Jupiterust/autoBike/bike_code/下位机软件要求.md

# 上位机通信契约 · 协议 v3（舵机轴角 ×100）

> 对应 `USER/upper/upper.c` / `upper.h` 当前实现。舵机命令、回显及边界统一为**相对现有回中位置的舵机输出轴角度 ×100**，有符号16位小端整数，单位0.01°，右正左负。发送前乘100并取整，接收后除100得到度。回显 rpm 优先使用有效的 ODrive 实测反馈，`status & 0x08` 表示本帧 rpm 为实测；`status & 0x20` 表示角度为传感器实测（当前恒0）。v3仅为文档版本，帧中没有版本字段。

上位机连接 **USART2，115200 8N1**：车端 PD6 RX、PD5 TX，双方 TX/RX 交叉连接并共地。UART7 的 ASCII 蓝牙遥控及 USART6 的二进制遥测是另外两条链路；仓库根目录 `REMOTE_PROTOCOL.md` 描述的是遥控链路，不是本文协议。

当前上位机舵机线值范围 **−2100～+2100**（左21.00°～右21.00°）。标定关系为120内部PWM单位≈21°，保持底层 `Servo_Delta=120` 的行程。上位机后轮目标 **0～240 rpm**；遥控器驾驶目标 **−240～+240 rpm**（±4转/秒），每次按键调整6rpm。两种模式均对叠加转弯补偿后的最终速度限幅；上位机不允许倒转，遥控器允许倒转。

遥控L/R键保持独立 `SERVO_RC_LIMIT_UNITS=114`，左右各20°目标向下取整后估算±19.95°，现在相应USART2回显为±1995。屏幕青色 `SERVO~` 仍显示角度（保留一位小数），右正左负，`~`表示估算而非传感器反馈；这里指舵机输出轴，不是龙头或前轮经连杆后的转角。回中位置不变，线性比例和左右对称性仍需硬件验证。

**兼容性：这是舵机字段单位的不兼容变更，上下位机必须同步升级。** 帧头、长度、字段偏移、CRC及方向均不变，不自动识别旧单位。旧程序发`+120`现在表示右1.20°，不再是旧端点约21°；新端点发送`+2100`。上位机连接后应查询边界，当前返回±2100；不要依赖旧±120常量。

**取整：** 命令先限幅到±2100，再按 `PWM = -round(servo × 120 / 2100)` 转换为整数PWM控制量；回显按 `servo = round(-Servo_Ctl × 2100 / 120)` 换算，正负半值均远离零。0.01°是协议分辨率，内部一个PWM单位约0.175°；例如发送`+1000`（右10.00°）得到`Servo_Ctl=-57`，稳定后回显`+998`（估算右9.98°）。量化取整不置`CLAMPED`，超过接受范围才置位。

上电默认由遥控器控制。必须由遥控器发送 `(S,)` 切到上位机控制，再发送新的命令；`S` 是切换命令，请勿周期重发。边界查询在两种模式都可用。执行要求平衡已使能且不在重立缓冲期；否则目标清零。上位机模式超时 **100ms**，请持续每 **20～30ms** 发送完整目标命令（目标未变化也要发）；查询帧不能代替命令保活。

**CRC-8**：多项式 `0x07`，初值 `0x00`，不反转、不异或。命令、普通回显、边界查询/回复及姿态回复使用 CRC；新增姿态查询 `AA 57 49 5A` 的第三字节是类型 `0x49`，不带 CRC。
自检：对 `"123456789"` 算出 `0xF4`。

---

## 一、要实现什么

| # | 方向 | 内容 | 章节 |
|---|---|---|---|
| 1 | 收 | **命令帧**（8 字节）→ 校验通过后设为当前目标值 | §二 |
| 2 | 收 | **边界查询帧**（4 字节）→ 回一帧边界帧 | §三 |
| 3 | 发 | **回显帧**（9 字节）：每 100 ms 一帧，值/状态变化时立即补发 | §四 |
| 4 | 发 | **边界帧**（12 字节）：收到查询帧时回 | §五 |
| 5 | 内部 | **超时保护**：超过超时时间没收到有效命令帧 → 目标清零 | §六 |
| 6 | 内部 | **上电默认**：舵机中位、电机不使能 | §七 |
| 7 | 收/发 | **姿态查询**（4 字节）→ **姿态回复**（11 字节），不主动周期发送 | §四·补 |

---

## 二、收：命令帧（固定 8 字节）

```
 偏移  长度  字段     类型       单位     说明
 ─────────────────────────────────────────────────────────────
  0     1   帧头1    —          —        0xAA
  1     1   帧头2    —          —        0x55
  2     2   servo    int16 小端  0.01°    绝对轴角目标，正 = 右
  4     2   rpm      int16 小端  r/min    电机转速，0 = 停
  6     1   crc8     —          —        覆盖字节 0..5
  7     1   帧尾     —          —        0x5A
 ─────────────────────────────────────────────────────────────
```

**要求：**

1. 找到帧头 `AA 55` → 收满 8 字节 → 查帧尾 `0x5A` → 查 CRC-8 → 查 `rpm ≥ 0`。
2. 全部通过：把 `servo`、`rpm` **限幅后**设为当前目标值，并记录"收到有效命令的时刻"。
3. 任一项不通过：丢弃该帧，不改变任何状态。
4. 丢弃一帧时，**只跳过 `AA 55` 这两个字节**，从下一个字节继续找帧头。
5. 处理必须**幂等**：同一帧收到 100 次 ≡ 收到 1 次，**不得累加**。
6. `servo`、`rpm` 超出你的量程 → 钳位，并置回显帧的 `CLAMPED` 位。

**帧样例**：

| 场景 | 8 字节 |
|---|---|
| 回中 + 停 | `AA 55 00 00 00 00 DD 5A` |
| 直行 120 rpm | `AA 55 00 00 78 00 D7 5A` |
| 直行 240 rpm（当前上限） | `AA 55 00 00 F0 00 C9 5A` |
| 右5.25°（+525）/ 120 rpm | `AA 55 0D 02 78 00 FF 5A` |
| 左10.50°（−1050）/ 180 rpm | `AA 55 E6 FB B4 00 56 5A` |
| 右21.00°（+2100，当前上限）/ 120 rpm | `AA 55 34 08 78 00 77 5A` |
| 左21.00°（−2100，当前下限）/ 120 rpm | `AA 55 CC F7 78 00 EF 5A` |
| 右10.00°（+1000，量化后回显+998）/ 120 rpm | `AA 55 E8 03 78 00 BE 5A` |

---

## 三、收：边界查询帧（固定 4 字节）

```
 偏移  长度  字段     类型   说明
 ──────────────────────────────────────────
  0     1   帧头1    —      0xAA
  1     1   帧头2    —      0x57
  2     1   crc8     —      覆盖字节 0..1
  3     1   帧尾     —      0x5A
 ──────────────────────────────────────────
```

**要求**：CRC 通过 → **立即回一帧边界帧**（§五）。此帧不改变任何目标值。

**帧样例**：`AA 57 38 5A`

---

## 四、发：回显帧（固定 9 字节）

```
 偏移  长度  字段     类型       单位     说明
 ─────────────────────────────────────────────────────────────
  0     1   帧头1    —          —        0xAA
  1     1   帧头2    —          —        0x55
  2     2   servo    int16 小端  0.01°    当前PWM输出换算的轴角估计，正 = 右
  4     2   rpm      int16 小端  r/min    实测转速；反馈失效时回退指令，见 status
  6     1   status   u8         —        见下表
  7     1   crc8     —          —        覆盖字节 0..6
  8     1   帧尾     —          —        0x5A
 ─────────────────────────────────────────────────────────────
```

**`status` 位：**

| 位 | 名称 | 掩码 | 置 1 条件 |
|---|---|---|---|
| 0 | `LINK_OK` | `0x01` | 上位机控制模式下，最近一个超时周期内收到过有效命令帧 |
| 1 | `TIMEOUT_SEEN` | `0x02` | 本次上电后曾因命令超时，或平衡/重立保护清除正在执行的目标而进入安全态；保持到复位 |
| 2 | `MOTOR_EN` | `0x04` | 固件允许后轮驱动；不代表 ODrive 确认闭环或电机实际正在转 |
| 3 | `MEASURED_RPM` | `0x08` | 本帧 rpm 来自有效、未过期的 ODrive 实测速度；0表示回退到速度指令 |
| 4 | `CLAMPED` | `0x10` | 输入命令或最终速度指令被限幅；不表示实测转速被限到0～240 |
| 5 | `MEASURED_ANGLE` | `0x20` | 舵机角度为传感器实测；当前没有位置反馈，恒0 |
| 6–7 | — | — | 填0 |

**要求：**

1. **每 100 ms 一帧**。
2. `servo`、`rpm` 或 `status` 任一变化 → **立即补发一帧**。
3. 角度与转速分别判断测量来源，上位机必须按各自状态位解释。

角度由限幅、转向斜坡后的当前软件输出 `Servo_Ctl` 按上述标定换算，`MEASURED_ANGLE=0`，不是请求目标的直接复制。角度回显与命令采用相同单位和方向，因输出量化及转向斜坡可能不同；平衡关闭或重立时回显0。

转速取 `odrive_vel1_turns * 60` 并四舍五入为整数 rpm。ODrive 位置与速度交替查询，当前速度更新约5Hz；回显频率并不等于传感器采样率。只有收到速度回复、数值有限且可用 int16 表示、距该速度回复解析时间不超过 **500ms** 时置 `MEASURED_RPM=1`。位置回复不刷新速度时间戳，接收重启后也必须等到新的速度回复。

反馈未收到、过期或无效时，清除 `MEASURED_RPM`，回退到最终速度指令 `odrive.set_speed1 * 60`；驱动禁用时回退值为0。若反馈有效，即使超时停车、平衡关闭或 `MOTOR_EN=0`，也继续回传实测速度，保留滑行、反转及超过240rpm的反馈，不按命令范围钳位。边界帧中的0～240rpm仍是**接受的命令范围**。

**帧样例**：

| 场景 | 9 字节 |
|---|---|
| 执行中（估算右5.25°、实测120rpm、链路正常、驱动使能） | `AA 55 0D 02 78 00 0D D0 5A` |
| 执行中（估算右21.00°、实测120rpm、链路正常、驱动使能） | `AA 55 34 08 78 00 0D 61 5A` |
| 反馈失效（估算右5.25°、回退指令120rpm、链路正常、驱动使能） | `AA 55 0D 02 78 00 05 E8 5A` |
| 反馈失效（估算右9.98°、回退指令120rpm、链路正常、驱动使能） | `AA 55 E6 03 78 00 05 7A 5A` |
| 超时后仍滑行（输出角0°、实测60rpm、驱动关闭、曾进安全态） | `AA 55 00 00 3C 00 0A 30 5A` |
| 超时后已停（输出角0°、实测0rpm、驱动关闭、曾进安全态） | `AA 55 00 00 00 00 0A 2B 5A` |
| 超时且反馈失效（输出角0°、回退指令0rpm、曾进安全态） | `AA 55 00 00 00 00 02 13 5A` |

---

## 四·补、IMU 姿态查询与回复

查询固定为 `AA 57 49 5A`（第三字节为 item，不是 CRC）。旧边界查询 `AA 57 38 5A` 保持不变；其他 item 拒收。

回复固定 11 字节：

| 偏移 | 长度 | 字段 | 格式/含义 |
|---|---|---|---|
| 0 | 1 | 帧头 | `0xAA` |
| 1 | 1 | 帧类型 | `0x58` |
| 2 | 2 | pitch | int16 小端，0.01°，抬头为正 |
| 4 | 2 | roll | int16 小端，0.01°，右倾为正 |
| 6 | 2 | yaw | int16 小端，0.01°，俯视顺时针为正 |
| 8 | 1 | status | `0x01 VALID`；`0x02 CALIBRATED`；其他位恒0 |
| 9 | 1 | CRC-8 | 覆盖偏移0～8 |
| 10 | 1 | 帧尾 | `0x5A` |

安装方向已由实车观察确认：`pitch=imu.pit`、`roll=-imu.rol`、`yaw=-imu.yaw`。三轴乘100后四舍五入（负数半值远离零），上位机除100得到度。不改变平衡控制变量，不减 `angular_zero`，不做航向归零；屏幕仍显示原始 `imu.rol/pit/yaw`。车体轴为 x前/y左/z上，角度正方向以本表约定为准。**姿态与舵机字段均用0.01°，但分别表示车身姿态与舵机输出轴角度，两者不能互推。**

`VALID=1` 要求收到帧头和CRC正确、三轴有限的 CH100 数据，距离成功解帧不超过 **100ms**（含100ms），且转换后可用 int16 表示。启动未收到数据、CRC错误、UART错误/接收重启、非有限值、超范围或超过100ms均无效；新的有效帧到达后恢复。无效回复 `status=0`、三个字段填0，**这些0不是实际姿态，上位机必须丢弃**。

`CALIBRATED` 暂时恒0，表示车端未确认零偏标定完成，不否认CH100内部出厂校准或补偿；31秒等待和 `angular_zero` 均不作为标定完成依据。有效回复因此为 `status=0x01`。没有额外 `MEASURED` 位。

一问一答，遥控/上位机两种控制模式、平衡未使能时均可查询。只在前台使用 USART2 非阻塞发送；查询不改变目标，不刷新驾驶超时。待发顺序为 **边界回复 → 姿态回复 → 普通回显**，已在发送的帧不会被中断。UART忙/发送失败时保留待发计数，成功启动发送才扣减。两类查询各用16位饱和计数，极端积压达到65535后同类新增查询丢弃；上位机按10～50Hz轮询即可，切勿无节制连续请求。等待期间不保存历史样本，回复取发送时最新姿态。

样例：`AA 58 2C 01 38 FF 8C 23 01 97 5A`，表示 pitch=+3.00°、roll=−2.00°、yaw=+91.00°，有效且未确认标定。

---

## 五、发：边界帧（固定 12 字节）

```
 偏移  长度  字段        类型       单位     说明
 ─────────────────────────────────────────────────────────────
  0     1   帧头1       —          —        0xAA
  1     1   帧头2       —          —        0x56
  2     2   servo_min   int16 小端  0.01°    最小轴角目标，当前-2100（左21°）
  4     2   servo_max   int16 小端  0.01°    最大轴角目标，当前+2100（右21°）
  6     2   rpm_min     uint16 小端 r/min    最小可稳转速；0 = 未提供
  8     2   rpm_max     uint16 小端 r/min    最大可用转速；0 = 未提供
 10     1   crc8        —          —        覆盖字节 0..9
 11     1   帧尾        —          —        0x5A
 ─────────────────────────────────────────────────────────────
```

**要求：**

1. 填**你实际会接受的量程**（就是 §二 里做限幅用的那两个数）。
2. 必须保证 **`servo_max` 是往右的极限**；舵机装反时在固件内部取反。
3. 未标定时填当前保守值；全部填 0 表示"未提供"。
4. 收到边界查询帧（§三）时回一帧；上电后也可主动发一次。

**帧样例**：

| 场景 | 12 字节 |
|---|---|
| 当前车端：舵机±21.00°（线值±2100）、rpm_min 未标定、rpm_max=240 | `AA 56 CC F7 34 08 00 00 F0 00 AD 5A` |
| 未提供（全 0） | `AA 56 00 00 00 00 00 00 00 00 B8 5A` |

---

## 六、超时保护

**判据**：距上次收到**有效命令帧**的时间 > 超时值。

**动作**：舵机与后轮的**控制目标**清零（回中 + 停），置 `TIMEOUT_SEEN`；收到新的有效命令帧后按平衡/重立条件恢复。回显 rpm 在反馈有效时仍显示实测转速，可能因车轮滑行暂不为0。

**超时值**（当前 `UPPER_TIMEOUT_MS=100u`，编译期可覆盖；下表其他档位仅供配置参考，并非运行时切换）：

| 档 | 超时值 | 上位机发送间隔上限 |
|---|---|---|
| bench（台架 / 低速调试） | 500 ms | ≤ 166 ms |
| slow（低速路测 ≤1.5 m/s） | 200 ms | ≤ 66 ms |
| normal（正常行驶，默认） | 100 ms | ≤ 33 ms |

---

## 七、上电默认

| 项 | 要求 |
|---|---|
| 舵机 | 中位（`servo = 0`） |
| 电机 | 不使能 |
| 目标值 | `servo = 0`、`rpm = 0` |
| 是否等待握手 | 无握手；先由遥控器 `(S,)` 切入上位机模式，平衡使能且非重立期间才能执行新命令 |
