Jupiterust/autoBike/bike_code/下位机通信实现说明.md

# 上位机与下位机通信实现说明

本文仅说明已实现的上位机与下位机串口通信：接口、收发帧、字段含义、命令处理、状态回显及超时保护。完整协议契约及样例见 [下位机软件要求.md](./下位机软件要求.md)。

本次统一将舵机命令、回显、边界改为**舵机输出轴角度 ×100（0.01°）**，右正左负，相对现有回中位置。上位机目标范围为±2100，即±21.00°；保持原PWM行程。旧整数控制量不兼容，帧内没有版本字段，上位机须同步调整发送、解析及边界单位。

## 1. 通信接口

| 项目 | 当前配置 |
|---|---|
| 下位机串口 | USART2 / huart2 |
| 下位机 TX | PD5，连接上位机 RX |
| 下位机 RX | PD6，连接上位机 TX |
| 串口参数 | 115200，8 数据位，无校验，1 停止位，无流控 |
| 电气连接 | 3.3 V TTL，共地 |
| 传输方式 | 二进制原始字节，不追加换行 |

运动命令仅在上位机控制已启用时生效；未启用时忽略运动命令，也不更新命令时间，但仍回复边界查询和发送状态回显。通信协议本身不提供启用或切换控制来源的指令。启用后需要新的完整有效命令，不会自动执行先前收到的目标。

## 2. 协议总览与校验

| 帧 | 方向 | 帧头 | 总长度 |
|---|---|---|---|
| 运动命令 | 上位机 → 下位机 | AA 55 | 8 字节 |
| 边界查询 | 上位机 → 下位机 | AA 57（38） | 4 字节 |
| 姿态查询 | 上位机 → 下位机 | AA 57（49） | 4 字节 |
| 姿态回复 | 下位机 → 上位机 | AA 58 | 11 字节 |
| 状态回显 | 下位机 → 上位机 | AA 55 | 9 字节 |
| 边界回复 | 下位机 → 上位机 | AA 56 | 12 字节 |

所有帧均以 5A 结束。多字节字段使用小端编码；有符号字段使用 int16 补码。

姿态查询 `AA 57 49 5A` 的第三字节是 item，不是CRC；其他帧按下述规则校验。姿态回复字段及有效性见协议契约 §四·补。

CRC-8 参数：多项式 0x07，初值 0x00，不反转，最终不异或。CRC 覆盖帧头至 CRC 字节之前的全部字节，不包含 CRC 本身和帧尾。自检：ASCII “123456789” 的 CRC 为 F4。

运动命令与状态回显虽然都以 AA 55 开头，但长度不同。上位机接收应按 9 字节回显解析，不能按 8 字节命令解析。

## 3. 上位机发送运动命令

### 3.1 帧格式

| 偏移 | 字节数 | 字段 | 含义 |
|---|---|---|---|
| 0–1 | 2 | 帧头 | AA 55 |
| 2–3 | 2 | servo，int16 小端 | 绝对舵机轴角目标，单位 0.01°；正为右，负为左，0 为中位 |
| 4–5 | 2 | rpm，int16 小端 | 电机轴目标转速，单位 r/min；0 为停止 |
| 6 | 1 | CRC | 覆盖字节 0–5 |
| 7 | 1 | 帧尾 | 5A |

### 3.2 当前处理规则

- 校验帧尾、CRC 和 rpm ≥ 0，全部通过才处理命令。
- 合法命令覆盖当前绝对目标，并记录接收时间；重复发送相同命令不累加目标，只更新有效命令时间。
- servo 接受范围为 -2100～+2100，即左 21.00°～右 21.00°。
- rpm 接受范围为 0～240，指电机轴 RPM，不是车轮 RPM 或车辆速度。
- 超过角度或正转速上限时钳位，并设置回显的 CLAMPED 位。
- rpm 为负时拒绝整条命令，转向和转速均不更新，也不刷新超时。
- 帧尾或 CRC 错误时不更新目标及命令时间；仅跳过候选帧头两个字节，继续寻找合法帧。
- 支持分段接收、连续多帧及噪声后的重新同步；串口接收错误时清除未完成的半帧。

转向采用实测标定关系：120内部PWM单位≈21°，不代表已达到0.01°实测精度。命令先限幅，再按 `-round(servo × 120 / 2100)` 转换为整数PWM量，半值远离零；下位机处理安装方向，上位机始终按“正为右”发送。遥控L/R仍限±114内部单位（估算±19.95°），底层共用范围仍为±120单位。

例：发送+1000（右10.00°）得到内部−57单位，稳定后估算9.975°，回显+998（9.98°）。量化取整不置CLAMPED。旧+120线值现在表示1.20°，不能再用作旧端点。

命令接收有效不等于电机已经运行。车辆未满足平衡使能等运行条件时，运动目标会清零，回显可能出现 LINK_OK = 1、MOTOR_EN = 0。

## 4. 下位机发送状态回显

### 4.1 帧格式

| 偏移 | 字节数 | 字段 | 含义 |
|---|---|---|---|
| 0–1 | 2 | 帧头 | AA 55 |
| 2–3 | 2 | servo，int16 小端 | 当前PWM输出换算的舵机轴角估计，单位 0.01°，正为右 |
| 4–5 | 2 | rpm，int16 小端 | 优先实测电机轴RPM；反馈失效时回退软件指令，见status |
| 6 | 1 | status | 状态位 |
| 7 | 1 | CRC | 覆盖字节 0–6 |
| 8 | 1 | 帧尾 | 5A |

舵机回显使用限幅、转向斜坡后的 `Servo_Ctl`，按 `round(-Servo_Ctl × 2100 / 120)` 换算，半值远离零；并非直接复制请求角度。当前没有位置传感器，`MEASURED_ANGLE=0`；平衡关闭或重立时角度回显0。遥控模式采用相同单位，±114内部单位回显∓1995。

RPM优先使用500ms内有效的ODrive速度反馈并置 `MEASURED_RPM`；反馈失效时回退到包含转弯补偿和最终限幅的软件速度指令。驱动关闭时回退指令为0，但有效实测反馈仍保留滑行、反转和超范围速度。回显不是电机控制器的执行确认。

### 4.2 状态位

| 位 / 掩码 | 名称 | 当前含义 |
|---|---|---|
| bit 0 / 01 | LINK_OK | 上位机控制已启用，且最近 100 ms 内收到过有效运动命令 |
| bit 1 / 02 | TIMEOUT_SEEN | 本次上电以来发生过通信超时或平衡/重立保护清除运动目标，保持至复位 |
| bit 2 / 04 | MOTOR_EN | 平衡使能、非重新扶正状态且后轮运行标志有效 |
| bit 3 / 08 | MEASURED_RPM | 本帧RPM来自有效实测反馈；0为指令回退 |
| bit 4 / 10 | CLAMPED | 当前命令或补偿后的输出被限幅 |
| bit 5 / 20 | MEASURED_ANGLE | 当前无舵机位置传感器，恒0 |
| bit 6–7 | 保留 | 0 |

表中掩码为十六进制。未发生保护且正常驱动时，反馈失效回退状态为05，有实测RPM反馈时为0D；超时后相应为02或0A。TIMEOUT_SEEN 是历史标志，不能单独用它判断当前仍处于超时状态。

### 4.3 发送时机

首次运行时发送回显；之后 servo、rpm 或 status 变化时尽快补发，否则按 100 ms 周期发送。

发送采用 HAL_UART_Transmit_IT 非阻塞方式。串口忙时延后处理，不覆盖正在发送的缓冲区；待发顺序为边界回复、姿态回复、普通回显。因此回显是状态快照，不是每条命令一条 ACK，实际发送时机也受主循环和串口可用性影响。

上位机控制未启用时也有回显，但 LINK_OK 为 0；舵机仍按相同物理角度单位回显，遥控后轮反馈允许负RPM。

## 5. 边界查询与回复

上位机发送 4 字节查询：

~~~text
AA 57 38 5A
~~~

其中 38 是 AA 57 的 CRC。合法查询登记后，在串口可发送时优先回复边界帧，不改变目标，也不刷新运动命令超时。

| 偏移 | 字节数 | 字段 | 当前值 |
|---|---|---|---|
| 0–1 | 2 | 帧头 | AA 56 |
| 2–3 | 2 | servo_min，int16 小端 | -2100，即左 21.00° |
| 4–5 | 2 | servo_max，int16 小端 | +2100，即右 21.00° |
| 6–7 | 2 | rpm_min，uint16 小端 | 0，最小可稳转速未提供 |
| 8–9 | 2 | rpm_max，uint16 小端 | 240，电机轴 RPM 上限 |
| 10 | 1 | CRC | 覆盖字节 0–9 |
| 11 | 1 | 帧尾 | 5A |

当前完整回复：

~~~text
AA 56 CC F7 34 08 00 00 F0 00 AD 5A
~~~

建议上位机连接后先查询边界，不硬编码其他车辆的量程。rpm_min = 0 不表示所有低速都已验证可以稳定运行。

## 6. 命令超时保护

当前超时阈值为 100 ms，判据为距上次有效运动命令的时间严格大于 100 ms。刚启用上位机控制、尚未收到命令时，从启用时刻开始计时。

上位机应约每 30 ms 重发当前完整目标，发送间隔不超过 33 ms；即使目标不变也应持续发送。错误帧、负转速命令和两种查询都不能刷新超时。

超时后下位机清零转向与转速目标、回中并安排后轮零速命令，设置 TIMEOUT_SEEN。收到新的有效运动命令后，在运行条件满足时可自动恢复，历史超时标志仍保留。

100 ms 是软件超时阈值，不保证机械车轮在 100 ms 内完全停止；保护执行依赖控制周期正常运行。

## 7. 通信样例与代码入口

以下均为原始 HEX 字节，不追加换行：

| 场景 | 帧 |
|---|---|
| 回中、停止 | AA 55 00 00 00 00 DD 5A |
| 右转 6°、停止 | AA 55 58 02 00 00 47 5A |
| 左转 6°、停止 | AA 55 A8 FD 00 00 6F 5A |
| 直行 60 RPM | AA 55 00 00 3C 00 D8 5A |
| 右转 6°、60 RPM | AA 55 58 02 3C 00 42 5A |
| 左转 6°、60 RPM | AA 55 A8 FD 3C 00 6A 5A |
| 直行 60 RPM 的反馈失效回显示例，status = 05 | AA 55 00 00 3C 00 05 1D 5A |
| 超时且反馈失效的回显，status = 02 | AA 55 00 00 00 00 02 13 5A |

主要通信实现位于 [USER/upper/upper.c](./USER/upper/upper.c)，协议常量和状态位位于 [USER/upper/upper.h](./USER/upper/upper.h)，串口接收入口位于 [USER/uart/uart.c](./USER/uart/uart.c)。

| 函数 | 通信职责 |
|---|---|
| Upper() | 逐字节找帧、校验、更新命令或登记查询 |
| upper_crc8() | CRC-8 计算 |
| upper_rx_reset() | 清除未完成的接收半帧 |
| upper_task() | 非阻塞发送回显、边界及姿态回复 |
| upper_control_tick() | 检查命令超时，施加有效目标或清零 |
