Jupiterust/autoBike/odrive/额外配置.docx

odrv0.config.dc_max_negative_current = -30

odrv0.config.dc_max_positive_current = 120

odrv0.axis0.motor.config.current_lim = 140

odrv0.config.brake_resistance = 2.0

odrv0.axis0.controller.config.vel_limit_tolerance = 2.5

odrv0.config.max_regen_current = 100

odrv0.axis0.motor.config.requested_current_range = 120

odrv0.axis0.motor.config.current_lim = 100

odrv0.axis0.controller.config.control_mode = 2

odrv0.axis0.controller.config.input_mode = 1

odrv0.axis0.controller.config.vel_ramp_rate = 80

odrv0.axis1.controller.config.vel_limit_tolerance = 2.5

odrv0.axis1.motor.config.requested_current_range = 120

odrv0.axis1.motor.config.current_lim = 100

odrv0.axis1.controller.config.control_mode = 2

odrv0.axis1.controller.config.input_mode = 1

odrv0.axis1.controller.config.vel_ramp_rate = 80
