Jupiterust/autoBike/odrive/旧电机配置.docx

//两个电机的速度模式

odrv0.erase_configuration()

odrv0.config.brake_resistance = 2

odrv0.config.dc_bus_overvoltage_trip_level = 56

odrv0.config.dc_max_positive_current = 120

odrv0.config.dc_max_negative_current = -30

odrv0.axis0.motor.config.motor_type = MOTOR_TYPE_HIGH_CURRENT

odrv0.axis0.motor.config.pole_pairs = 20

odrv0.axis0.motor.config.calibration_current = 10

odrv0.axis0.motor.config.current_lim = 120

odrv0.axis0.motor.config.current_lim_margin = 8

odrv0.axis0.encoder.config.mode = ENCODER_MODE_INCREMENTAL

odrv0.axis0.encoder.config.cpr = 8192

odrv0.axis0.controller.config.control_mode = 3

odrv0.axis0.controller.config.vel_limit = 50

odrv0.axis0.controller.config.vel_limit_tolerance = 2

odrv0.axis0.controller.config.vel_gain = 0.05

odrv0.axis0.controller.config.vel_integrator_gain = 0.2

odrv0.axis0.controller.config.input_mode = INPUT_MODE_VEL_RAMP

odrv0.axis0.controller.config.vel_ramp_rate = 50

odrv0.axis1.motor.config.motor_type = MOTOR_TYPE_HIGH_CURRENT

odrv0.axis1.motor.config.pole_pairs = 14

odrv0.axis1.motor.config.calibration_current = 10

odrv0.axis1.motor.config.current_lim = 120

odrv0.axis1.motor.config.current_lim_margin = 8

odrv0.axis1.encoder.config.mode = ENCODER_MODE_INCREMENTAL

odrv0.axis1.encoder.config.cpr = 8192

odrv0.axis1.controller.config.control_mode = CONTROL_MODE_VELOCITY_CONTROL

odrv0.axis1.controller.config.vel_limit = 50

odrv0.axis1.controller.config.vel_limit_tolerance = 2

odrv0.axis1.controller.config.vel_gain = 0.2

odrv0.axis1.controller.config.vel_integrator_gain = 0.2

odrv0.axis1.controller.config.input_mode = INPUT_MODE_VEL_RAMP

odrv0.axis1.controller.config.vel_ramp_rate = 50

odrv0.save_configuration()

odrv0.reboot()

odrv0.axis0.requested_state = AXIS_STATE_FULL_CALIBRATION_SEQUENCE //校准大概需要十秒钟

odrv0.axis0.error //检查是否有错误

odrv0.axis0.requested_state = AXIS_STATE_CLOSED_LOOP_CONTROL

odrv0.axis0.motor.config.pre_calibrated = True

odrv0.axis0.config.startup_encoder_offset_calibration = True

odrv0.axis0.config.startup_closed_loop_control = True

odrv0.axis1.requested_state = AXIS_STATE_FULL_CALIBRATION_SEQUENCE //校准大概需要十秒钟

odrv0.axis1.error //检查是否有错误

odrv0.axis1.requested_state = AXIS_STATE_CLOSED_LOOP_CONTROL

odrv0.axis1.motor.config.pre_calibrated = True

odrv0.axis1.config.startup_encoder_offset_calibration = True

odrv0.axis1.config.startup_closed_loop_control = True

odrv0.save_configuration()

odrv0.reboot()

odrv0.axis0.config.can.node_id =24

odrv0.axis1.config.can.node_id =16

odrv0.can.config.baud_rate = 250000

odrv0.axis0.controller.input_vel = 10 //设置转速

odrv0.axis1.controller.input_vel = 10
