Jupiterust/autoBike/PID_Param_Con/fir.png

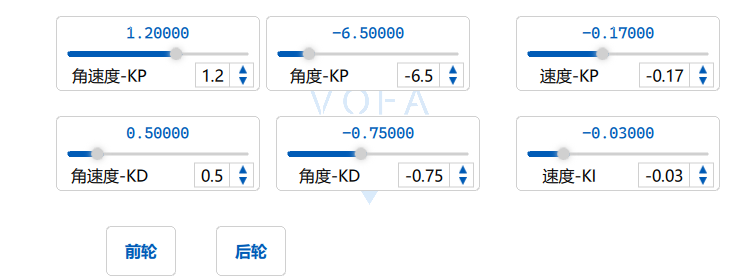
PID_Param_Con/fir.png
