Jupiterust/autoBike/bike_code/TUNING_JOURNAL.md

# TUNING_JOURNAL.md — PID 迭代记录 (append-only)

格式见 `TUNING_PLAYBOOK.md` §5。铁律:一次只动一处;变差就回滚。
静态窗(不给扰动)的 `step_response` 各项记 N/A。

指标缩写:
`settle` 恢复时间ms(±0.1° 紧带) / `overshoot` 峰值角偏离deg / `rms_err` 角误差std deg /
`fly_peak` 峰值|now_speed0| / `sat` 飞轮饱和占比 / `djit` D逐帧抖动 / `idle` now_speed0 均值

---

## iter 0  2026-09-08  focus: 基线 / 静态诊断 (无扰动)

change: (无 — 本轮只建立基线)

机械配置已相对上次调参变更(重心/动力学变了);增益仍是旧配置上整定的。
`angular_zero` 已由用户经 OLED 菜单手调至 -1.32(代码里 `param_init()` 仍是 -1.27)。

四个静态窗(`step_response.found=false`,M0 全程使能):

| 窗 | av_kp/ki/kd | an_kp/ki/kd | fw_kp/ki/kd | zero | rol std | rms_err | idle | idle漂移 | sat | djit | 起始rol-zero |
|---|---|---|---|---|---|---|---|---|---|---|---|
| 071727 (10s) | 1.400/0/1.115 | -7.30/0/-1.20 | -0.160/-0.061/0 | -1.310 | 0.034 | 0.065 | +4.68 | +2.75 | 0% | 0.117 | -0.021 |
| 192147 (30s) | **1.350**/0/1.115 | **-7.20**/0/-1.20 | -0.160/-0.061/0 | -1.320 | 0.091 | 0.185 | +2.59 | +1.42 | 0% | 0.119 | -0.176 |
| 192501 (30s) | 1.400/0/1.115 | -7.30/0/-1.20 | -0.160/-0.061/0 | -1.320 | 0.093 | 0.160 | +6.43 | +14.17 | 0% | 0.123 | -0.082 |
| 192554 (31s) | 1.400/0/1.115 | -7.30/0/-1.20 | -0.160/-0.061/0 | -1.320 | 0.035 | 0.063 | +1.95 | +0.47 | 0% | 0.110 | +0.007 |

step_response: N/A (静态窗)

诊断:
1. **无极限环**。0.15–12Hz 频谱宽带,主峰仅占带内功率 17–27%;分三段峰峰不等幅。
   排除"某个增益过高"的经典高频自激。
2. **静态平衡点偏了**。四窗 `now_speed0` 均值全为正(+1.9..+6.4)且漂移全为正,
   `pwm_accel` 持续为负(速度环在长期出力补偿) —— 违反手册 §1.2 的 idle≈0。
   直接估计:按 1s 分块回归 d(now_speed0)/dt vs imu_rol,过零点即真实平衡点:
   071727 → -1.3426 (r=.44) / 192147 → -1.3444 (r=.38) / 192554 → -1.3489 (r=.63),
   三窗独立估计一致,均值 **-1.345**;192501 因 r=.07 无效(该窗从未接近稳态)。
   当前 zero=-1.32,偏差 **-0.025**。
3. **复现性差(存疑,未定论)**。192501 与 192554 参数完全相同,但 rol std 相差 2.7 倍、
   now_speed0 RMS 相差 3.2 倍。两个"躁动窗"的 imu_rol 与 now_speed0 锁在同一慢频
   (0.035–0.045Hz,周期 22–29s),但 30s 窗内只有 1.0–1.3 个周期,
   **不足以区分"速度环慢极限环"与"一次未收敛的慢漂移"**。
   躁动/平静的分野与起始 rol 相对 zero 的偏差相关(平静窗起始差 ≤0.02°,
   躁动窗 -0.08 / -0.18°),但 n=4,且与"人手放车的方式"混淆,暂不作结论。
4. 黄旗:`djit`(0.110–0.123)约为 |D| 均值(0.060–0.066)的 **1.9 倍**。按手册 §4
   属于"D 在放大噪声"的早期迹象,但未到 >>,暂不动 kd。

verdict: baseline
note: 先修静态零点(手册 §4 规定的开工第一检查,且三窗独立估计一致);零点正了之后
      再重取 2–3 窗看复现性是否还在,若仍在再查 fw_kp/fw_ki(慢频正落在速度环频段)。

---

## iter 1  2026-09-08  focus: angular_zero (静态零点)

change: `param.angular_zero`  -1.32 -> **-1.35**  (OLED 菜单注入, 未烧录)

依据: iter 0 中三窗独立回归 d(now_speed0)/dt vs imu_rol 的过零点一致给出 -1.345。

四个静态窗(zero 全程 -1.35 不变, M0 全程使能, 无脉冲, 其它增益未动),
且 `t_ms` 单调 74s->306s —— **同一次开机内连续采集, 中途没摔没重启**:

| 窗 | 开机时长 | rol均值 | rol std | 误差均值 | idle均值 | idle漂移 | pwm_accel | 平衡点估计 | djit |
|---|---|---|---|---|---|---|---|---|---|
| 194557 | 89 s | -1.3492 | 0.058 | +0.016 | **-1.16** | +3.65 | **+0.018** | -1.3435 | 0.133 |
| 194653 | 145 s | -1.3581 | 0.088 | +0.005 | **-0.17** | -5.03 | **-0.003** | -1.3554 | 0.130 |
| 194738 | 190 s | -1.3743 | 0.042 | -0.017 | +2.02 | +2.26 | -0.042 | -1.3760 | 0.119 |
| 194918 | 290 s | -1.3851 | 0.040 | -0.035 | +3.99 | -0.35 | -0.072 | -1.3860 | 0.133 |

before (zero=-1.32, 同增益 2 窗): rms_err 0.160/0.063  idle +6.43/+1.94  idle漂移 +14.17/+0.47  sat 0%  djit 0.123/0.110
after  (zero=-1.35, 4 窗):        rms_err 0.107/0.162/0.076/0.070  idle -1.16/-0.17/+2.02/+3.99  idle漂移 +3.65/-5.03/+2.26/-0.35  sat 0%  djit 0.133/0.130/0.119/0.133
step_response: N/A (静态窗)

verdict: **keep**

note: 预测基本兑现,但只在前两窗成立 —— 因为暴露了一个更重要的事实。
  1. 方向和量级对了: 前两窗 idle -1.16/-0.17(目标 |mean|<1.5 达标)、pwm_accel +0.018/-0.003
     (目标 ->0 达标)、误差均值 +0.016/+0.005(目标 ->0 达标)。窗首平衡点估计 -1.3435,
     -1.35 当时是对的。
  2. **idle 的符号从"四窗全正"变成"跨零分布"**(-1.16/-0.17/+2.02/+3.99),
     漂移符号同样从全正变成双向。系统性偏置消除了,剩下的是散布。
  3. rol std 未变差(均值 0.057 vs 0.064)。饱和仍 0%。
  4. **新发现(本轮最重要): 平衡点在同一次开机内持续漂移。** 四窗按开机时长回归
     r = -0.958、漂移率 **-0.013 deg/min**(201 s 内移动 -0.043 deg)。三个独立测量
     ——平衡点回归 / rol 均值 / idle 与 pwm_accel —— 全部同向单调,不是回归噪声。
     后两窗变差是因为平衡点走过了 -1.35,不是 -1.35 选错了。
  5. 但它**不是开机时长的函数**: 跨 session 回归 r 仅 -0.32,071727(开机 324s)给出
     -1.3426,与本 session 的拟合(该点应为 -1.367)明显矛盾。所以是"每次开机内非平稳",
     成因未定(IMU 热漂 / 机械沉降 / 电池),暂不猜。
  6. 直接推论: **手动追 angular_zero 追不上**。0.013 deg/min 意味着 10 分钟就偏 0.13 deg
     = 13 个菜单步。这件事必须交给环路自己吸收,不能靠人拧。
  7. 黄旗仍在: djit(0.119-0.133) / |D|均值(0.064-0.072) 比值约 1.85,与 iter 0 持平,
     未恶化也未改善。

---

## iter 2  2026-09-08  focus: fly_wheel_speed_ki (飞轮速度环积分)

change: `param.fly_wheel_speed_ki`  -0.061 -> **-0.081**  (菜单注入, zero 保持 -1.35)

四窗, zero/增益窗内全程不变, M0 全程使能, 无脉冲。
**采样有缺陷(见 note 1)**: 来自两次开机(200224+200328 / 200658+200742),
开机时长全部落在 83-177s, iter1 出问题的 190/290s 区间没采到。

| 窗 | 开机s | bp | offset(bp-zero) | rol std | 误差均 | idle均 | idle漂移 | pwm_acc | 慢模态 |
|---|---|---|---|---|---|---|---|---|---|
| 200224 | 98 | -1.3709 | -0.0209 | 0.061 | -0.007 | +1.17 | -3.14 | -0.029 | 0.035Hz/0.023 |
| 200328 | 162 | -1.3797 | -0.0297 | 0.044 | -0.017 | +2.21 | +3.04 | -0.048 | 0.895Hz/0.020 |
| 200658 | 105 | -1.3434 | +0.0066 | 0.064 | +0.015 | -0.94 | +4.59 | +0.017 | 0.030Hz/0.050 |
| 200742 | 149 | -1.3772 | -0.0272 | 0.045 | -0.006 | +1.21 | -1.35 | -0.032 | 0.890Hz/0.021 |

before(iter1, fw_ki=-0.061): rms_err 0.107/0.162/0.076/0.070  idle -1.16/-0.17/+2.02/+3.99  sat 0%  djit均 0.1289  rolstd 0.040..0.088
after (iter2, fw_ki=-0.081): rms_err 0.107/0.078/0.114/0.079  idle +1.17/+2.21/-0.94/+1.21  sat 0%  djit均 0.1286  rolstd 0.044..0.064
step_response: N/A (静态窗)

verdict: **keep** (改善为真但幅度小于需要; 无任何退化)

note:
  1. **两轮开机时长区间不重叠, idle 不能直接比。** 改用归一化指标
     d(idle)/d(offset) —— 同样的平衡点偏差下, 飞轮残余转速有多大:
       iter1 fw_ki=-0.061 : **-117.9**  (r=-0.987, n=4)
       iter2 fw_ki=-0.081 : **-96.1**   (r=-0.740, n=3)
     **偏置抑制改善约 18%**, 方向与预测一致。d(pwm_accel)/d(offset) 2.06->1.84 基本不变
     (稳态所需的设定值偏置由物理决定, 与 ki 无关), 说明改善确实来自"更小的残余 idle
     就能产生同样的 pwm_accel", 即积分带宽提高。这与"环路一直在追漂移、从未到稳态"
     的模型一致: 残余 idle 正比于 漂移率/带宽。
  2. 无退化: 饱和仍 0%; rol std 最大 0.088->0.064(反而更好); 慢模态幅值均值
     0.0301->0.0284(单窗最大 0.0406->0.0499, 由 200658 一窗贡献, 未越 0.06 回滚线);
     D 抖动/|D| 比值 1.85->1.85 完全持平。**回滚条件一条都没触发。**
  3. 验收标准只部分达成: idle |mean|<1.5 达成 3/4(200328 +2.21);
     **idle 漂移 |·|<2 仍只 1/4 达成, 与 iter1 相同 —— 这条标准当初就定错了**:
     窗内 idle 漂移主要由平衡点本身在漂造成, 不是速度环能消掉的量。
  4. **新发现: 平衡点的主导因素是机械安装, 不是电子漂移。**
     同一开机时长、不同次开机的 bp:
       ~90-105s 三次开机 -> -1.3435 / -1.3709 / -1.3434, 极差 **0.0275 deg**
       ~145-162s 三次开机 -> -1.3554 / -1.3772 / -1.3797, 极差 **0.0243 deg**
     若是 IMU 热漂, 相同开机时长应给出相同结果; 实测不同次开机相差 0.025 deg,
     **排除 IMU 热漂主导**。指向"每次扶车/上架的几何不同 + 放置后持续沉降"。
     结论: angular_zero 的可整定精度被机械重复性限制在 **±0.013 deg** 左右,
     再精细地拧它没有意义。

---

## iter 3  2026-09-08  focus: 抗扰基线 (作废 — 未按预期条件执行)

change: (无。本轮意图是在 zero=-1.35 / fw_ki=-0.081 下跑 0.5deg TEST step 基线)

结果: 四次触发 TEST step, **四次全部进入 5deg 断电保护**。

| 窗 | TEST沿 | 命令阶跃 | 脉冲时长 | 峰值err_zero | 峰now_speed0 | 峰pwm_accel | 饱和占比 | 沿->断电 |
|---|---|---|---|---|---|---|---|---|
| 201732 | 1395 | **+2.0003** | 395ms | +8.14 | -106.0 | +1.583 | 26.7% | 128帧 |
| 201732 | 4088 | **+2.0005** | 400ms | +8.00 | -106.0 | +1.612 | 26.3% | 123帧 |
| 201828 | 1765 | **+1.9998** | 400ms | +8.43 | -120.0 | +1.792 | 24.0% | 121帧 |
| 201852 | 1040 | **+2.0481** | 400ms | +7.84 | -128.3 | +1.918 | 28.7% | 125帧 |

step_response: 全部无效 (激励不是预期的 0.5deg)

verdict: **作废, 不作为调参数据点**

note:
  1. **根因: 固件没重新烧录。** `TEST_STEP_DEG` 是编译期常量, 不是菜单参数;
     iter 1 之后我把它从 2.0f 改成 0.5f 并构建了, 但车上跑的仍是旧二进制。
     遥测实测命令阶跃 +2.00deg 四次一致 -> 板上是 2.0deg 那版。
     磁盘 elf 反汇编 `test_pulse_offset` = `vmov.f32 s0, #96 @0x3f000000 0.5`, 是 0.5deg。
     教训: 菜单能改的只有 `param` 里的量; `TEST_STEP_DEG/TEST_STEP_MS/TEST_ABORT_DEG/
     TEST_ARM_MAX_DEG` 都必须烧录才生效。
  2. 本轮 `fw_ki` 实测是 **-0.0790**, 不是 iter 2 的 -0.0810(静态四窗)。中途多按了一格。
  3. **第二个发现(结构性, 与阶跃大小无关): `Velocity_Control()` 的输出没有限幅。**
     `Velocity = encoder_bias*kp/10 + integral*ki/1000`, 积分项限幅 ±200,
     **比例项完全不限**。kp=-0.16 => pwm_accel = -0.016 * now_speed0。
     - 静态 now_speed0 ±30  -> pwm_accel ±0.48deg (已与本次要注入的 0.5deg 阶跃同量级)
     - 本轮 now_speed0 -128 -> pwm_accel **+1.92deg**, 直接加进角度环设定值
     失控链条(见 201732 逐帧): 2deg 阶跃 -> 角度环要求飞轮加速度超限, set_speed0_raw
     -36.5 撞上 ±18 限幅 -> 飞轮转速冲到 -128 -> 速度环据此命令 +1.9deg 设定值偏置
     -> 车追这个偏置冲过 +3.7deg -> 断电。**脉冲撤销后偏置仍在(t=400ms 时 pwm_accel
     仍 +1.583)**, 这就是"危险发生在撤销之后"的机制。
  4. 按线性外推, 0.5deg 阶跃下: set_speed0_raw ~-9 (不会碰 ±18 限幅),
     now_speed0 峰值 ~-27..-32 (与静态窗常见范围相同), pwm_accel 峰值 ~+0.4..+0.5。
     即上面的失控链条**不应被触发**。

---

## iter 4  2026-09-08  focus: 抗扰基线 (0.5deg 阶跃) —— 首次成功

条件: zero **-1.40**(用户在 iter2 的 -1.35 基础上又下调), fw_ki -0.081, 其余不变。
固件已烧录 0.5deg 版: 线上实测命令阶跃 +0.500/+0.500/+0.579/+0.499。**四次全部未进保护。**

| 窗 | 命令阶跃 | 脉冲时长 | 峰值角偏离 | 峰时刻 | recover(±0.3) | recover_tight(±0.1) | 峰now_spd0 | 峰\|pwm_accel\| | 倍数 | 残余 |
|---|---|---|---|---|---|---|---|---|---|---|
| 203042 | +0.500 | 400ms | **-1.046** | 1130ms | 1621ms | **2406ms** | +134.7 | -1.984 | **4.0x** | +0.018 |
| 203102 | +0.500 | **500ms** | -2.260 | 1195ms | — | — | -196.3 | +3.040 | 6.1x | -0.180 |
| 203409 | +0.579 | 400ms | **+0.838** | 565ms | 2466ms | 未恢复 | +118.7 | -1.808 | 3.1x | +0.173 |
| 203436 | +0.499 | 400ms | **-1.270** | 1115ms | 未恢复 | 未恢复 | +155.7 | -2.160 | 4.3x | -0.242 |

(analyzer 窗长本轮由 2000ms 改为 3000ms —— 2000ms 下 4 窗有 3 窗被截断成"未恢复"。
 本轮是首个基线, 无历史可比, 是改窗长的正确时机。)

verdict: **基线成立, 但测到的不是我们想测的东西**

note:
  1. **203102 作废**: 脉冲跑了 **500ms** 而非 400ms。两个沿附近 loop_cnt 连续(dloop=2)、
     无丢帧, 是真的跑长了。根因: `test_pulse_start()` **不防重复触发**, 而遥控协议规定
     "按住 = ~10Hz 重发同一 id"(REMOTE_PROTOCOL.md), OK 多按住 100ms 就把 test_start_ms
     刷新一次。**500-400 = 100ms 正好一个重发间隔。** 已修(见下)。
  2. **本轮最重要的结论: 主导响应的是速度环, 不是被注入的扰动。**
     四窗一致 —— `Velocity_Control()` 命令的设定值偏置是阶跃的 **3.1..6.1 倍**:
       阶跃 +0.50deg  ->  峰值 pwm_accel 1.8..3.0deg
     逐帧(203042): t=410 撤销脉冲 -> t=660 飞轮卷到 now_speed0 +120, pwm_accel -1.760
     -> t=810 pwm_accel **-1.984**, angle_tgt 被拉到 **-3.32**(车在 -1.46)
     -> t=1110 车追到 -2.36, 即峰值角偏离 -1.05(与阶跃反向、且是阶跃的 2 倍)。
     **SAT 全程 0** —— 飞轮指令根本没撞 ±18 限幅, 纯粹是 pwm_accel 无限幅。
     这与 iter3 里 2deg 阶跃翻车是**同一机制**, 只是幅度小到没摔。
  3. 因此本轮的 recover/overshoot 数字**不能用来评判角度环或内环增益** —— 它们测的是
     速度环的大信号行为。要拿到有意义的抗扰基线, 必须先把这个偏置限住。

code (两处, 均已构建通过并在二进制中验证):
  a. `PID.h/PID.c`: `Velocity_Control()` 输出限幅 **FLY_SPEED_OUT_LIMIT = 0.5f**。
     依据: 静态四窗 24266 帧 pwm_accel 分布 p1 -0.234 / p99 +0.288 / |max| 0.432,
     取 0.5 比最坏静态样本高 15%, 静态时不介入; 瞬态由 1.8..3.0 压到 0.5(降 4-6 倍)。
     刻意不用"降 fw_kp": 降增益会把静态动量管理能力按同样比例砍掉, 限幅只切大信号。
     限幅在 telem tap 之前, 所以遥测里的 pwm_accel 就是真正进入角度环的值;
     若某静态窗里它贴在 ±0.5, 说明限太紧, 调大即可(自诊断)。
  b. `Balane.c`: `test_pulse_start()` 增加 `if (test_active) return 0;`。
     属仪器修复, 不碰控制律: 单击行为不变, 只是按住不再延长脉冲。

tooling: 修掉 analyzer 一处误报 —— "安全中止"提示原来只看 error_zero 而不看脉冲时长,
  在 203436(脉冲跑满 400ms)上误报过。现在只陈述事实并告诉读者拿 pulse_ms 去比对
  固件的 TEST_STEP_MS, 不替读者下结论。

---

## iter 5  2026-09-08  focus: 速度环输出限幅 —— **回滚**

change: `FLY_SPEED_OUT_LIMIT = 0.5f` (Velocity_Control 输出限幅) —— **已撤销**

结果: 车完全站不住。四次测试(zero -1.40, fw_ki -0.081)全部在 30s 内倒下, M0 断电保护触发。

| 窗 | pwm_accel \|max\| | 贴±0.5 帧占比 | now_speed0 峰值 | M0 |
|---|---|---|---|---|
| 203436 (限幅前, 可用) | **2.160** | — | +156 | 全程正常 |
| 205220 | **0.500** | **18.0%** | **+205** | 掉落 |
| 205256 | **0.500** | **21.1%** | **+203** | 掉落 |
| 205516 | **0.500** | **18.0%** | **+204** | 掉落 |
| 205556 | **0.500** | **12.4%** | **+206** | 掉落 |

verdict: **rollback** (已执行: 限幅代码与 FLY_SPEED_OUT_LIMIT 宏全部移除,
  PID.c / PID.h 现与 HEAD 逐字节一致; 二进制反汇编确认 Velocity_Control 内已无 0.5 常量)

note:
  1. 机制清楚: `pwm_accel = -0.016 * now_speed0`, 所以 ±0.5 的限幅等价于
     "|now_speed0| > 31 就开始削"。实测 12-21% 的帧贴在限幅上, 飞轮因此卸不掉动量,
     一路卷到 205(限幅前同类窗最高 156), 然后倒。
  2. **推导错误(我的)**: 定这个值时只取了四个**最平静**的静态窗的 pwm_accel 分布
     (|max| 0.432), 把它当成了工作范围。而更早的静态窗 now_speed0 就到过 ±51
     (= pwm_accel 0.82, 已超限幅), 扰动后到 120..156。取样子集不代表工作范围。
  3. **更根本: 这个修法方向就是错的。** 要让限幅不误伤, 得设到 >=2.2, 那就完全不起作用。
     因为反作用轮卸动量**必须**靠车身倾斜让重力产生反向力矩 —— iter4 里看到的
     "pwm_accel 达到阶跃 3-6 倍"不是正反馈失控, 是动量卸载的物理必需。
     我把必要的控制作用误判成了缺陷。
  4. 因此 iter4 note.2 的结论要修正: 速度环在扰动后命令大偏置**是正常的**;
     真正的问题是**扰动期间飞轮就卷到了 120-200**(静态只有 ±30)。方向应转向
     动量容量 / fly_wheel_rate_limit / 扰动幅度, 而不是去限速度环的输出。
  5. 当前固件 = iter4 已验证可用的那版 + `test_pulse_start()` 的防重复触发守卫。
     该守卫只作用于菜单触发路径, 不可能影响平衡。TEST_STEP_DEG 仍为 0.5f(二进制已确认)。

---

## iter 6  2026-09-08  focus: 回滚验证 + angular_zero 写进代码默认值

change: `param_init()` 及全部预设的 `angular_zero`  -1.27 -> **-1.40** (代码, 需烧录)

### 6a 回滚验证 —— 通过

烧录回滚版后, zero -1.40 / fw_ki -0.081, 六窗 **M0 全程未掉**, pwm_accel 恢复到 1.2..2.4
(限幅版是精确顶在 0.500 且 12-21% 帧被削)。

静态三窗是一条清晰的沉降收敛:

| 窗 | 开机s | rol均值 | rol std | 误差均 | idle均值 | 平衡点 | r |
|---|---|---|---|---|---|---|---|
| 210603 | 81 | -1.5497 | 0.1437 | -0.2184 | +23.05 | -1.5489 | 0.31 |
| 210624 | 100 | -1.4626 | 0.1170 | -0.0853 | +9.13 | -1.4696 | 0.19 |
| 210718 | 155 | **-1.4002** | **0.0276** | **-0.0034** | **+0.37** | **-1.4007** | 0.60 |

**210718 是至今最干净的一窗**: rol std 0.0276(历史最好 0.0341)、idle +0.37(历史最好 +1.94)、
稳态角误差 -0.003。zero=-1.40 在稳定态下几乎精确命中。

### 6b 抗扰基线(修正版, 无限幅) —— 可复现

| 窗 | 阶跃 | 峰值角偏离 | 峰时刻 | recover(±0.3) | recover_tight(±0.1) | 峰now_spd0 | 残余 |
|---|---|---|---|---|---|---|---|
| 210758 | +0.484 | -1.480 | 1145ms | 2946ms | 未恢复 | 152.7 | -0.352 |
| 210817 | +0.500 | -1.075 | 1071ms | 2556ms | 未恢复 | 119.3 | -0.109 |
| 210839 | +0.500 | -1.385 | 1095ms | 2921ms | 2936ms | 135.0 | -0.345 |

与 iter4 (峰值偏离 -1.046/-1.270, 飞轮峰 134.7/155.7) 高度一致 —— 回滚完整恢复了先前行为。
**合计 6 窗构成可复现基线。** 特征:
  - 峰值角偏离 **-1.08..-1.48**, 即阶跃的 2-3 倍, **且与阶跃反向**
  - 峰值出现在 **1071-1145ms**, 即脉冲撤销后约 670-745ms —— 主导的是回摆瞬态
  - 恢复(±0.3) **2.6-2.9s**; 紧带(±0.1) 多数 >3s
  - 飞轮峰值 119-153 (静态只有 ±30)

### 6c 代码改动

`angular_zero` 的默认值散落在 **4 处**, 只改 param_init 会留陷阱(按菜单 LOAD calm/wind
或 VOFA '2'/'3' 会静默 revert 回 -1.27)。四处全改:
  - `Balane.c param_init()`
  - `vofa.c case '2'` (无风预设)
  - `vofa.c case '3'` (有风预设)
  - `ui.c menu_load_preset()` (菜单项 11/12 共用)
验证: 镜像中 `-1.27f` 出现 **0** 次, `-1.40f` 出现 3 次(编译器合并了字面量)。
**只改了 angular_zero(机械零点), 两组预设的 9 个增益一个字未动。**

verdict: keep

note:
  1. 取 -1.40 而非历史 10 个估计的中位数 -1.3735: 最新、相关性最好、且是在"至今最干净的
     一窗"里测到的; 也与用户已连续多轮手动使用的值一致。机械件若再变动仍需重测。
  2. 代码默认值主要影响 **31s 直立倒计时**那段 —— 那时还够不到菜单。本轮 210603
     (开机 81s, idle +23) 说明刚站起来那段确实偏得厉害, 把默认值改对能明显缩短沉降。
  3. **`fw_ki` 的默认值仍是 -0.061**, 而实际使用的是 -0.081(iter2 判定 keep)。
     每次烧录后仍需手动重设, 与 angular_zero 是同一类隐患。未一并修改 —— 它是增益不是
     机械量, 改它等于改动两组预设的内容, 留给用户决定。

---

## iter 7  2026-10-12  focus: 新飞轮 av_kp 单步试验

change: 用户通过遥控器将 `av_kp` **1.40 -> 1.35**；本轮只分析实测并追加记录。
其余实测增益均为 av_ki=0 / av_kd=1.115，an=-7.30/0/-1.20，fw=-0.160/-0.081/0。
目标按用户最新要求：优先评价偏差/扰动后的稳定恢复；angular_zero 仅作为场地初始条件，不寻找跨场地通用固定值。

### 数据与可比性

- 新日志 `telem_20261012_092656.csv`：30.028s，无 TEST，zero=-1.40，servo_ctl=0。
- 新日志 `telem_20261012_092823.csv`：31.338s，无 TEST，zero=-1.38，servo_ctl=0。
- 新日志 `telem_20261012_092904.csv`：31.343s，zero=-1.38，servo_ctl=0；第9.779s触发一次0.300deg/400ms TEST，保留21.564s响应。
- 三窗增益在各自窗口内恒定，M0全程开启，STM32速度指令SAT=0，IMU CRC新增0。后两窗开头约1.3s存在遥测序号缺口，TEST响应段连续；序号缺口不等于控制环漏执行。
- 静态优先匹配旧 `075553` 与新 `092823`：两者 zero=-1.38、servo_ctl=0，记录的增益仅 av_kp 不同。旧 `075719` 的 servo_ctl=-4，不能与新窗作严格单变量对照。
- 脉冲比较旧 `075836` 与新 `092904`：均为0.300deg/400ms，但zero分别为-1.40/-1.38；触发瞬间 now_speed0 为13.667/0.333，imu_vx 为-0.419/+0.145deg/s。旧窗此前还有舵量/控制源变化，不能将全部差异归因于 av_kp。

### 实测结果

| 指标 | av_kp=1.40 | av_kp=1.35 |
|---|---:|---:|
| 匹配静态窗 imu_rol std (deg) | 0.06619 | 0.03396 |
| 匹配静态窗 now_speed0 std | 3.92998 | 2.62255 |
| 匹配静态窗最大绝对速度指令 (turn/s) | 4.50181 | 2.01379 |
| 匹配静态窗 D逐帧抖动 | 0.17996 | 0.15768 |
| 脉冲正向角偏离峰值 (deg) | +0.63734 @0.410s | +0.62376 @0.485s |
| 脉冲反向角偏离峰值 (deg) | -0.45349 @0.810s | -0.56593 @1.506s |
| 脉冲后0-3s角偏离RMS (deg) | 0.24758 | 0.29495 |
| 脉冲后4-10s imu_rol std (deg) | 0.08640 | 0.04500 |
| 脉冲后最大绝对速度指令 (turn/s) | 13.71042 | 11.63088 |
| 脉冲后 now_speed0 正峰值 | 51.000 | 38.667 |
| 动态角误差持续在±0.3deg内的起点 | 7.518s | 3.361s |

口径：角偏离相对各窗TEST前200ms的imu_rol均值；动态角误差=angle_target-imu_rol，目标会随动量反馈移动，不等于车身回到固定初始姿态。旧窗±0.3deg保持至10.374s，新窗保持至21.564s。相对固定脉冲前姿态的±0.3deg保持起点反而为2.166s -> 2.946s；恢复结论依赖所评价的物理量，不能混用。

新窗在完整21.564s响应中未持续保持动态角误差±0.1deg；12-21s角度std=0.03500deg，now_speed0均值=-0.30815、std=2.67810，说明已回到较小波动，但不是完全无残余摆动。

now_speed0 是TIM8计数/控制周期的三点平均，不是turn/s或rpm。绝对峰值51 -> 38.667不能单独视作24%的抗扰改善：相对触发瞬间速度的正向增量分别为37.333和38.333。

### 分析口径与结论

- 原始CSV复算优先于summary：`pid_tuning_bridge.py` 的 `speed_loop.now_speed0` 仍误取set_speed0；本轮使用真实now_speed0列。
- 摘要的2.951s恢复仅检验到约3s窗口末尾，之后再次越界；延长检查后应为3.361s。旧摘要0.3642deg混入同一更新时刻的速度补偿，扣除其他补偿后真实脉冲为0.3000deg。
- 静态主峰从旧窗约1.63Hz变为新窗约1.37-1.50Hz，振幅下降；频率降低本身不证明阻尼或所有抗扰指标改善。
- 静态和后段回摆改善，前3s及反向峰值变差，正向峰值仅改善约2%；本轮不宣称抗扰全面改善，也不认定根因已定位。

verdict: keep（暂保留1.35为候选；不是最终整定或抗扰全面通过）

next: 不继续降至1.30或同时改其他增益。补充同一场地/朝向、zero=-1.38、servo_ctl=0、相近初始姿态与飞轮速度下的脉冲对照：1.35再测一窗，1.40测一窗；每窗仅触发一次相同TEST并保留至少20s响应。比较早期峰值/回摆与后段衰减后，再决定最终保留或回滚。上述车上切换尚未执行；本轮未修改固件或ODrive配置。

---

## iter 8  2026-10-12  focus: av_kp=1.35 的 TEST 重复性

change: 本批没有有效的1.40/1.35脉冲对照；后三窗实测av_kp均为1.35，其余增益与iter7相同。

### 排除与有效数据

- `telem_20261012_095251.csv`：用户明确说明中途误切断，不具参考意义，排除统计与参数评价。该窗仅7.438s，av_kp=1.40，没有TEST。
- 有效窗为 `095316`、`095352`、`095435`：各一次TEST，实际偏置均为0.300deg；标志持续400/401/401ms，符合采样时间量化，没有提前保护中止的证据。
- zero依次为-1.40/-1.40/-1.41，每窗内部固定；servo_ctl均为0，没有控制源切换。脉冲后记录22.560/23.415/23.936s，响应段无遥测序号缺口。
- 全程M0开启、STM32速度指令SAT=0、IMU CRC新增0；这些不证明ODrive没有限流。

### 原始CSV复算

| 指标 | 095316 | 095352 | 095435 |
|---|---:|---:|---:|
| av_kp | 1.35 | 1.35 | 1.35 |
| angular_zero | -1.40 | -1.40 | -1.41 |
| 触发瞬间now_speed0 | +1.333 | +3.000 | -4.000 |
| 脉冲前5s角度std (deg) | 0.04567 | 0.04702 | 0.04546 |
| 正向角偏离峰值 (deg) | +0.59878 | +0.62066 | +0.65373 |
| 反向角偏离峰值 (deg) | -0.47634 | -0.39349 | -0.51993 |
| 脉冲后0-3s角偏离RMS (deg) | 0.25224 | 0.25564 | 0.27872 |
| 脉冲后4-10s角度std (deg) | 0.08642 | 0.05043 | 0.12830 |
| 脉冲后15-20s角度std (deg) | 0.04744 | 0.05590 | 0.06761 |
| 脉冲后now_speed0正峰值 | 35.000 | 37.333 | 42.000 |
| 正峰值出现时刻 (s) | 0.600 | 0.596 | 1.941 |
| 最大绝对速度指令 (turn/s) | 9.92158 | 11.35507 | 12.14846 |
| 动态角误差±0.3deg保持起点 (s) | 5.182 | 3.292 | 20.344 |

角偏离仍相对各窗TEST前200ms的imu_rol均值；now_speed0单位为TIM8计数/控制周期的三点平均，不是turn/s/rpm。动态角误差=angle_target-imu_rol，±0.3deg保持起点表示最后一次越界之后至记录结束均在带内，不表示此前持续处于大幅失稳。三窗随后分别保持17.378/20.123/3.592s。

完整记录的动态±0.1deg末段仅保持0.916/0.565/0.025s，不能据此宣称紧带稳定恢复。第三窗summary的2.682s/2.977s来自约3s的分析窗口；实际第20.314-20.339s又连续6帧越过动态±0.3deg，约20.324s最大0.331deg。第三窗第20-23s角度std=0.10197deg，确有后段波动再次增大，不能将最后越界时间解读成一直没有恢复。

### 本轮结论与下一步

- 首次正向角偏离稳定在约0.60-0.65deg，约为注入幅度的2倍；后段回摆差异较大。前两有效窗记录参数完全相同，但4-10s角度std仍为0.086/0.050deg，说明重复波动不可忽略。
- iter7中“1.35后段摆动更小”只适用于当时的具体窗口；本批不支持将其推广为稳定、可重复的改善。第三窗更差也不能仅归因于zero的0.01deg变化。
- 本批唯一1.40窗口已排除，没有新增有效1.40 TEST证据，故不能确认1.35优于1.40，也不继续下调至1.30。

verdict: pending（更新iter7的暂留候选判断：最终保留/回滚尚待有效1.40对照）

next: 沿用最后一窗当前场地、朝向、zero=-1.41、servo_ctl=0与其余增益，仅通过遥控器将av_kp从1.35切到1.40，采集一窗相同0.300deg/400ms TEST，保留至少20s响应。触发前保留平稳段，尽量匹配较低飞轮速度与姿态。已有1.35重复数据可用于比较，不需要再重建这一组基线。本轮只追加分析记录，未执行车上参数切换。

---

## iter 9  2026-10-12  focus: av_kp 分组比较及 LOADwind 误选核对

change: 用户计划依次测试av_kp=1.40/1.45/1.35/1.30，每组两次TEST。以原始CSV逐帧参数为准，实际是前三组各两次，最后两次为LOADwind整组预设；用户回复“可能误选了 LOADwind”。

### 实际分组与有效性

- 1.40：`telem_20261012_100231.csv`、`telem_20261012_100305.csv`。
- 1.45：`telem_20261012_100354.csv`、`telem_20261012_100438.csv`。
- 1.35：`telem_20261012_100525.csv`、`telem_20261012_100602.csv`。
- LOADwind：`telem_20261012_100642.csv`、`telem_20261012_100716.csv`。
- 前六窗均zero=-1.40、servo_ctl=0，其他增益av_ki=0/av_kd=1.115，an=-7.30/0/-1.20，fw=-0.160/-0.081/0，窗口内没有参数/控制源切换。脉冲响应段连续，首六窗可以作单增益比较，但初始姿态、角速度、飞轮速度仍有差异，且每组只有两次顺序试验。
- 八窗均仅一次TEST，分离速度等补偿后实际偏置0.300deg；TEST标志时长395-401ms，与名义400ms及采样边界相容。M0全程开启、STM32速度指令SAT=0、IMU CRC新增0。
- 第七窗开始为av_kp=1.30，但采集第12.961s（TEST前4.107s）同时改变六个增益：av_kp=1.20、av_kd=1.16、an_kp=-7.9、an_kd=-1.6、fw_kp=-0.17、fw_ki=-0.065。与`USER/ui/ui.c:128`的LOADwind完整一致。第八窗全程使用此组。没有有效的1.30 TEST，不能把最后两窗当作降低av_kp的单变量收益。

### 同口径比较前六窗

前六窗都有至少18s响应，统一用TEST后0-18s作组间比较；保留完整窗口检查迟发回摆。角偏离相对TEST前200ms平均姿态；动态角误差=angle_target-imu_rol。

| av_kp / 日志尾号 | 前3s角偏离RMS(deg) | 4-10s角度std(deg) | 0-18s动态误差RMS(deg) | 动态±0.3deg保持起点(s，检查至18s) | now_speed0正峰 |
|---|---:|---:|---:|---:|---:|
| 1.40 / 100231 | 0.21596 | 0.06865 | 0.14552 | 5.257 | 37.333 |
| 1.40 / 100305 | 0.22980 | 0.08687 | 0.15158 | 6.737 | 33.000 |
| 1.45 / 100354 | 0.25543 | 0.11495 | 0.17107 | 9.614 | 34.667 |
| 1.45 / 100438 | 0.23511 | 0.09708 | 0.16219 | 9.594 | 31.667 |
| 1.35 / 100525 | 0.22077 | 0.05073 | 0.13769 | 2.501 | 32.333 |
| 1.35 / 100602 | 0.29810 | 0.10388 | 0.23440 | 7.433 | 47.000 |

- 1.40本批两次较均衡。1.45两次后段角度std均高于1.40，±0.3deg末次越界更晚；100354在18s之后还有再次放大，完整窗口的末次越界后起点为22.880s，仅剩0.170s记录，不能认为全程9.614s后稳定。
- 1.35的100525较好，但100602前3sRMS为0.29810deg，飞轮峰47出现在1.861s，3-4s反馈均值仍36.825，4-6s均值28.697，明显拖尾。其触发前5s角度std=0.07529deg、触发瞬间反馈5.333，与另一窗0.05220deg/2.000不同，不能把重复差异全归因于增益。
- 1.45相对前200ms基线的正峰看似较小，但初始摆动相位不同；同一固定zero下最大角偏离为0.563/0.570deg，1.40为0.525/0.560deg，未见可靠的峰值优势。不要只凭单个正峰排序。
- now_speed0仍为TIM8计数/控制周期的三点平均，不是turn/s/rpm；动态±0.3deg时间不是回到固定初始姿态的时间。各窗紧带±0.1deg仍会再次越界，不能使用summary约3s窗口给出最终整定结论。

### LOADwind作为整组线索

两窗0-3s角偏离RMS=0.20101/0.26635deg，4-10s角度std=0.04704/0.04547deg；观测到的动态±0.3deg保持起点0.750/3.121s。后段有改善线索，但不能归因于av_kp=1.20或任一单独参数。

第七窗仅有14.266s响应，且8.668-9.159s存在序号缺口，最大缺口231ms；第八窗6.978-7.008s、13.410-13.620s有缺口，最大94ms。缺失区间无法证明连续保持，以上时间仅针对已记录样本。第七窗前5s还跨越预设切换，不用作纯wind静态指标。

两窗4-10s D逐帧抖动=0.22754/0.23179，1.40为0.16443/0.14889；D包含目标跳变且缺帧影响逐帧统计，这只是输出波动代价线索，不足以认定噪声放大或直接批准整组替换。

verdict: keep av_kp=1.40作为当前对照基线；1.45本批无收益，1.35尚无稳定优势；1.30 TEST缺失。LOADwind留作待拆分验证的候选，不写入默认参数。

next: 补齐真正的1.30组两次TEST。先加载LOADcalm并核对其恢复的基线，再仅改av_kp=1.30；其余av_ki=0/av_kd=1.115、an=-7.30/0/-1.20、fw=-0.160/-0.081/0、zero=-1.40、servo_ctl=0保持固定。相同场地/朝向，平稳后在采集第5-8s触发一次0.3deg/400ms，保留至少20s响应。如果1.30也没有可重复收益，停止扩展av_kp扫描，固定基线后再逐项检验阻尼相关参数。这里只提出下一轮方案，未操作硬件或修改固件默认值。

---

## iter 10  2026-10-12  focus: 补齐 av_kp=1.30 TEST 与后续阻尼试验

change: 用户补测1.30，实际采集三窗；第一窗忘记切换参数并主动中止，按用户要求排除。后两窗实测av_kp=1.30，av_ki=0/av_kd=1.115，an=-7.30/0/-1.20，fw=-0.160/-0.081/0，均无窗口内参数变化。

### 数据条件

- `telem_20261012_101700.csv`：3.376s，av_kp=1.40，无TEST，排除参数评价。
- `telem_20261012_101910.csv`：zero=-1.43，servo_ctl=0；采集第9.044s触发一次TEST，保留22.330s响应。
- `telem_20261012_102005.csv`：zero=-1.44，servo_ctl=0；采集第15.671s触发一次TEST，保留15.677s响应。
- 两窗实际注入0.300deg，TEST标志持续400/396ms，与名义400ms及采样边界相容。响应段无序号缺口；M0全程开启、STM32速度指令SAT=0。IMU CRC累计25，在三窗内均未增加，不是本轮新增25次错误。
- 旧1.40/1.45/1.35组zero=-1.40，新1.30组为-1.43/-1.44，且属于新的开机记录。可以评价当前工作条件下的表现，但不能将全部差异归因于av_kp。按用户要求不追求通用固定零点；下一轮只需固定最近一次的场地初始条件。

### 原始CSV复算与四档比较

最短有效响应15.677s，故整体指标统一至TEST后15s；仍检查完整记录的迟发越界。角偏离相对各窗TEST前200ms平均姿态，动态角误差=angle_target-imu_rol。

| av_kp / 日志尾号 | 前3s角偏离RMS(deg) | 4-10s角度std(deg) | 0-15s动态误差RMS(deg) | 动态±0.3deg保持起点(s，检查至15s) |
|---|---:|---:|---:|---:|
| 1.40 / 100231 | 0.21596 | 0.06865 | 0.15627 | 5.257 |
| 1.40 / 100305 | 0.22980 | 0.08687 | 0.16346 | 6.737 |
| 1.45 / 100354 | 0.25543 | 0.11495 | 0.18559 | 9.614 |
| 1.45 / 100438 | 0.23511 | 0.09708 | 0.17074 | 9.594 |
| 1.35 / 100525 | 0.22077 | 0.05073 | 0.14952 | 2.501 |
| 1.35 / 100602 | 0.29810 | 0.10388 | 0.25331 | 7.433 |
| 1.30 / 101910 | 0.20159 | 0.04689 | 0.17373 | 1.961 |
| 1.30 / 102005 | 0.20422 | 0.04826 | 0.15373 | 1.326 |

1.30两窗完整记录中动态±0.3deg起点不变，随后分别保持20.369/14.351s。其余不同指标为：

| 指标 | 101910 | 102005 |
|---|---:|---:|
| 脉冲前5s角度std(deg) | 0.03713 | 0.05434 |
| 触发瞬间now_speed0 | +3.333 | +3.000 |
| 正向角偏离峰值(deg) | +0.62496 @0.510s | +0.58732 @0.480s |
| 反向角偏离峰值(deg) | -0.34760 @0.961s | -0.44165 @0.871s |
| now_speed0正峰 | 39.000 | 35.667 |
| 最大绝对速度指令(turn/s) | 10.11595 | 11.04135 |
| 4-10s now_speed0均值 / std | 12.094 / 2.998 | 3.070 / 4.247 |
| 4-10s imu_rol均值(deg) | -1.50011 | -1.47525 |
| 4-10s动态角误差RMS(deg) | 0.14556 | 0.07348 |
| 4-10s D逐帧抖动 | 0.16128 | 0.15858 |

now_speed0为TIM8计数/控制周期的三点平均，不是turn/s/rpm。第一窗车身摆幅虽然小，飞轮反馈在4-10s均值仍12.094，到15-20s才降至1.939；第二窗12.106s曾反向至-12，15-15.677s又均值+9.191，尚未证明飞轮速度稳定归零。

两窗完整记录的动态±0.1deg末段只保持1.436/0.220s。1-2s进入宽带不能称作全系统恢复完成；整体15s动态误差RMS也没有一致优于1.40。首个正向偏离仍约0.6deg，飞轮峰值未低于1.40组的37.333/33.000，剩余问题是首次回摆与动量恢复。

### 决策与下一步

verdict: keep av_kp=1.30作为当前摆放条件下的暂留候选，结束本轮av_kp扫描。依据是两窗大幅回摆衰减和4-10s角度波动较一致；不声称整体控制性能最优、纯增益因果已确定或飞轮速度恢复已完成。1.40保留为历史对照，不改固件默认值。

next: 下一轮仅将角度环`an_kd`从-1.20改为-1.25，检验小幅增加角速度反馈能否减少首次回摆及随后的飞轮速度积累。源码`USER/PID/PID.c:39`中此项直接乘实测gyro；它与内环av_kd的误差差分含义不同。菜单步长0.05，此候选为一格试探，尚未实车验证。

下一轮固定av=1.30/0/1.115，an=-7.30/0/-1.25，fw=-0.160/-0.081/0；沿用最近一次zero=-1.44、servo_ctl=0、同一场地/朝向。不加载会覆盖增益和零点的预设。采集两窗，每窗第5-8s仅触发一次0.3deg/400ms TEST，保留至少20s响应。评价首次正/反峰、4-10s摆动、飞轮峰/均值/反向再加速；若回摆、D波动、饱和或飞轮恢复变差，an_kd回到-1.20。不能仅以摆幅减小或±0.3deg时间缩短判定成功。本轮未执行车上修改。

---

## iter 11  2026-10-13  focus: an_kd=-1.25 三次复测评价（采集于2026-10-12）

change: 用户完成上一轮角度环an_kd=-1.20 -> -1.25试验但忘记采集次数；新增原始CSV共三窗，全部含一次有效TEST：`telem_20261012_103037.csv`、`telem_20261012_103114.csv`、`telem_20261012_103147.csv`。

### 条件核对

- 三窗均av=1.30/0/1.115，an=-7.30/0/-1.25，fw=-0.160/-0.081/0，zero=-1.43，servo_ctl=0；无窗口内参数或控制源变化。
- 真实TEST偏置均0.300deg、标志持续400ms；第三窗摘要0.3158deg混入速度等补偿，使用分离补偿后的原始CSV结果。
- 三窗响应时长21.094/15.752/25.996s，响应段无遥测序号缺口；M0全程开启、STM32指令SAT=0；IMU CRC累计25，本窗新增0。
- 对照iter10的101910/102005，an_kd=-1.20，其余增益一致；零点分别-1.43/-1.44。三窗新测试触发瞬间now_speed0=-6.333/+1.667/+1.333，对照为+3.333/+3.000；尤其第一窗初始速度方向不同，不能将全部幅度变化归因于an_kd。

### 同口径结果

角偏离相对TEST前200ms平均姿态；共同观察窗为脉冲后15s。角度峰峰值不依赖基线角度的选择。

| 日志 / an_kd | 前3s角偏离RMS(deg) | 正/反角偏离峰(deg) | 角度峰峰值(deg) | 4-10s角度std(deg) | 动态±0.3deg保持起点(s) |
|---|---:|---:|---:|---:|---:|
| 101910 / -1.20 | 0.20159 | +0.62496 / -0.34760 | 0.97255 | 0.04689 | 1.961 |
| 102005 / -1.20 | 0.20422 | +0.58732 / -0.44165 | 1.02897 | 0.04826 | 1.326 |
| 103037 / -1.25 | 0.30472 | +0.75660 / -0.66083 | 1.41743 | 0.03606 | 2.076 |
| 103114 / -1.25 | 0.24763 | +0.63530 / -0.50390 | 1.13920 | 0.02751 | 2.051 |
| 103147 / -1.25 | 0.23673 | +0.59939 / -0.49106 | 1.09045 | 0.03352 | 2.606 |

新三窗真实now_speed0正峰为39.333/36.333/36.000，对照为39.000/35.667，未出现明确下降。新三窗4-10s速度均值为-5.541/-5.495/-4.323，说明后段摆动虽然更小，仍存在反向飞轮转动，不能把姿态较静等同于速度归零。now_speed0单位仍为TIM8计数/控制周期的三点平均，不是rpm或turn/s。

新三窗4-10s D逐帧抖动为0.13760/0.14220/0.14402，低于对照0.16128/0.15858；不是所有指标都变差。后段角度std和动态误差也有收益，但前3s角偏离RMS三次均高于对照，反向峰与峰峰值三次也均更大；本轮“减小首次回摆及飞轮速度积累”的目标未实现。

新三窗完整记录的动态±0.1deg末段保持为2.026/0.395/8.324s；第三窗确实在17.672s后持续保持至结束。这是较好的后段结果，不能省略，但各记录长度不同，不足以据此抵消初期回摆的代价或证明全局优势。

### 决策

verdict: rollback（建议车上将an_kd=-1.25恢复为-1.20；尚未操作硬件）。av_kp=1.30继续作为暂留候选，保持其他增益；不继续增加an_kd绝对值。

依据：上一轮增加角速度反馈以减小初期回摆的假设，本批没有得到支持。实际闭环包含滤波、角度/角速度控制、ODrive速度控制与动量反馈，不能由“D更大”直接推定整车阻尼更好；本轮只报告实测取舍，不认定根因已唯一确定。

next: 仅回滚an_kd=-1.20，保持当前zero=-1.43、av=1.30/0/1.115、an_kp=-7.30、an_ki=0、fw=-0.160/-0.081/0、servo_ctl=0及摆放条件。用相同0.3deg/400ms TEST做两窗回滚确认，采集第5-8s触发，保留至少20s响应。尽量匹配较低的初始飞轮速度，检验早期峰/峰峰值是否回到旧水平，并检查速度残余；在回滚确认前不同时加入新的增益调整。本轮只追加分析记录，没有修改固件默认值。

---

## iter 12  2026-10-13  focus: an_kd=-1.20 下 av_kp=1.30→1.00 七档扫描

change: 用户逐档减小av_kp，每档两次TEST。新增原始CSV共14窗，实际参数依次为1.30、1.25、1.20、1.15、1.10、1.05、1.00；每档恰好两窗，窗口内无参数变化，无LOADwind混入。

### 条件、数据质量与人工干预

- 本批固定av_ki=0、av_kd=1.115；an=-7.30/0/-1.20；fw=-0.160/-0.081/0；servo_ctl=0。1.30至1.10的10窗zero=-1.44，1.05和1.00的4窗zero=-1.46。
- 用户确认同一场地、同一朝向，仅调整参数和零点；最后一窗末尾因飞轮转速较快且未收敛而手动扶车。用户明确“小车没有失去平衡”。该事件必须与自主响应区分。
- 14窗均只有一次TEST；分离angle_target内其他补偿并在角度环更新采样点核对，真实偏置均为0.300deg。TEST标志持续395～401ms，符合400ms名义脉冲及采样边界误差。
- 响应段序号连续，实际控制频率399.82～399.85Hz，IMU CRC累计/新增均0。部分采集开头约1.3s有遥测序号缺口，均早于TEST；不能把采集缺帧直接说成控制器丢环。
- 前13窗M0全程开启、STM32速度指令SAT=0。最后一窗自主比较段0～20s同样无饱和；末尾扶车事件另列，不纳入自然收敛、最大输出和稳定性排序。
- 最短响应是003320，仅11.790s；因此全组整体误差统一用TEST后0～10s，初期偏离用0～3s、后段波动用4～10s。其余较长记录继续检查迟发回摆，不只使用bridge默认3s摘要。

### 原始CSV同口径比较

表中每格斜线分隔同档的第一次/第二次；文件均为`logs/telem_20261013_<尾号>.csv`。角偏离相对各次TEST前200ms平均姿态，动态误差为angle_target-imu_rol。now_speed0仍为TIM8计数/控制周期的三点平均，不是rpm或turn/s。速度均值接近零也可能由正反摆动抵消，需结合标准差、绝对值均值与完整曲线判断。

| av_kp | 日志尾号 | 前3s角偏离RMS(deg) | 前3s角度峰峰值(deg) | 4～10s角度std(deg) | 4～10s now_speed0均值 | 0～10s动态误差RMS(deg) |
|---|---|---:|---:|---:|---:|---:|
| 1.30 | 003025/003107 | 0.257/0.208 | 1.131/1.022 | 0.046/0.042 | -0.11/-0.46 | 0.182/0.163 |
| 1.25 | 003208/003242 | 0.225/0.244 | 1.045/1.113 | 0.075/0.055 | 12.85/5.20 | 0.218/0.211 |
| 1.20 | 003320/003355 | 0.219/0.206 | 0.995/0.931 | 0.051/0.036 | -0.16/-0.35 | 0.177/0.178 |
| 1.15 | 003439/003518 | 0.243/0.244 | 1.050/1.097 | 0.061/0.038 | 7.81/-1.05 | 0.283/0.211 |
| 1.10 | 003556/003630 | 0.206/0.208 | 0.943/1.011 | 0.043/0.036 | 1.13/-1.13 | 0.172/0.169 |
| 1.05 | 003749/003823 | 0.196/0.191 | 0.857/0.877 | 0.039/0.039 | -2.26/-4.99 | 0.168/0.171 |
| 1.00 | 003905/003958 | 0.198/0.217 | 0.963/0.971 | 0.049/0.057 | 11.72/42.16 | 0.271/0.546 |

### 完整响应与候选比较

- **1.30为本批对照**：0～10s动态±0.3deg保持起点1.265/1.275s，但003025之后重新越界，完整记录的末段起点22.419s、仅余0.355s；不能把前10s结果当作全程稳定。003107保持至17.382s记录结束。第一窗触发时反馈-8.667、初始角姿态与其余窗不同，0.257deg初期RMS不是纯增益效应。
- **1.25无重复收益**：动态±0.3deg末段起点7.313/2.561s，4～10s飞轮均值+12.85/+5.20，拖尾较明显。
- **1.20可平衡但未明确超过1.10**：动态±0.3deg起点2.641/2.626s；其中一窗仅有11.790s响应，晚期证据有限。
- **1.15重复性不足**：003439飞轮正峰46.333在1.356s出现，4～10s反馈std=11.08，宽带保持到9.815s才开始；003518则在后段再次出现较大动态误差，完整窗口起点17.968s。不能假设av_kp越低指标就单调改善。
- **1.10为优先暂留候选**：两窗动态±0.3deg起点1.455/0.811s，随后分别保持26.622/27.206s直至记录结束。前3sRMS为0.206/0.208deg，4～10s反馈均值+1.13/-1.13、std=2.92/1.83、绝对值均值2.53/1.81。该段D逐帧抖动0.1756/0.2026，本批1.30为0.2086/0.1839，未见一致加剧。前3s飞轮正峰32/36，对照1.30为33.667/28；没有证据宣称所有指标都优于1.30。
- **1.05是待确认候选**：两窗初期峰峰值0.857/0.877deg，反向偏离-0.259/-0.287deg，较1.10的0.943/1.011deg及-0.378/-0.361deg更小。动态±0.3deg从1.455/0.845s保持至21.899/23.394s记录结束；4～10s反馈均值-2.26/-4.99、std=2.47/2.42、绝对值均值2.90/4.99，动量残余未一致更好。两窗同时使用zero=-1.46，不能把全部改善归因于av_kp由1.10降至1.05。
- **1.00暂不保留**：即便剔除最后人工扶车事件，003905的4～10s飞轮均值仍+11.72，003958则+42.16；后者10～15s/15～20s均值进一步为+50.14/+55.95，对应动态误差RMS=0.700/0.760deg。车身摆幅小与飞轮速度恢复不是同一指标。该窗不应被归类为“自行失衡”，但没有达到扰动后速度快速收敛的目标。

003958的人工事件诊断：TEST后24.465s起指令触及+18，24.715s时imu_rol=+3.576deg、zero=-1.46deg，差约5.036deg，M0清零，与源码5deg保护一致。用户确认先因持续高速而扶车；不能把该段饱和、约125的反馈峰或停机当成av_kp=1.00自然失稳/电机能力不足的证据，也不能把停机后静止当作收敛。

触发初态仍不完全一致：1.10的now_speed0为-0.333/+1.333，1.05为-5.667/+2.000，1.00为+9.333/+5.667；每档仅两次且顺序扫描，不能拟合为已确定的增益最优曲线。1.10和1.05在紧带±0.1deg内仍会反复越界，1.10末段仅连续1.811/0.345s，不能宣称整车与飞轮均已完全收敛。

### 源码解释与决策

`USER/PID/PID.c:12-19`中av_kp直接乘(Gyro-Gyro_Target)，输出为送入ODrive的速度指令组成项；Gyro_Target来自角度误差与an_kd×实测角速度（同文件39行）。av_kp从1.30降到1.10，使相同内环误差对应的P输出降低约15.4%，但av_kd的误差差分项不变；同时改变了角度环与速度执行链的整体响应。因此不能用“P越小越不振荡”或名义D/P比例直接决定最优值。当前数据体现了初期回摆、晚期速度恢复和初始状态之间的取舍，尚不需要据此改环路结构或ODrive配置。

verdict: 优先暂留av_kp=1.10、an_kd=-1.20作为下一轮对照；1.05作为待同条件确认的候选；不保留1.00、不继续向下扫描。本结论是参数建议，未修改固件默认值或操作硬件。历史1.30仍保留为对照，不能把1.10称为通用最优。

next: 先只将当前av_kp=1.00恢复到1.10；保持本场地最新zero=-1.46，不为比较来回修零点。其余固定av_ki=0/av_kd=1.115、an=-7.30/0/-1.20、fw=-0.160/-0.081/0、servo_ctl=0。按1.10→1.05→1.05→1.10顺序做四窗同样TEST，每档两次，消除原扫描中零点变化并减轻时间漂移混淆。每窗30s，第5～8s触发一次0.3deg/400ms，保留至少20s响应；尽量匹配低初始飞轮速度和接近静稳的姿态。若中途扶车，记录时刻并截断自主响应。只有1.05在初期回摆与速度残余/拖尾两方面都有可重复优势才替换1.10；否则结束内环kp扫描，保留1.10后再决定下一项。

---

## iter 13  2026-10-13  focus: 固定zero下确认av_kp=1.10/1.05，结束kp扫描

change: 用户报告完成测试，新增6窗均包含一次有效TEST。`005522`、`005640`为av_kp=1.10、zero分别-1.42/-1.45，单独记录，不混入固定zero的候选比较；`011736`、`011808`、`011846`、`011919`为固定zero=-1.47的四窗，实际顺序1.10→1.10→1.05→1.05，并非计划的ABBA，但可以评价当前条件下的重复表现。全部文件为`logs/telem_20261013_<尾号>.csv`。

### 条件与质量

- 六窗其余参数均av_ki=0/av_kd=1.115、an=-7.30/0/-1.20、fw=-0.160/-0.081/0、servo_ctl=0，窗口内无参数变化。六窗M0全程开启，STM32指令饱和占比0，IMU CRC累计/新增均0。
- 分离angle_target其他补偿后真实TEST偏置均0.300deg，标志持续395～401ms。固定zero四窗控制频率399.83～399.84Hz。
- 六窗TEST后响应分别23.980、24.856、17.637、23.865、23.800、22.804s。最短011736不足20s，四窗整体比较统一用0～17s；初期0～3s、后段4～10s和4～17s另列，继续检查各自完整记录。
- 011846在TEST后7.078～7.113s之间出现三处序号缺口，缺4帧遥测，相邻间隔最大15ms；其余五窗响应段连续。逐帧D统计排除跨缺口的差分；缺失区间不能证明连续保持。持续反转较严重的011919没有响应段缺帧。
- 文件时间与车上uptime表明011736前重新开始了车上计时；前两窗与后四窗不能当作一段连续、相同零点的试验。四窗虽固定参数，初始姿态、角速度、飞轮速度仍有差异，未重复交错顺序，不宣称已确定唯一增益因果。

### 固定zero四窗的原始CSV复算

角偏离相对TEST前200ms平均姿态；动态误差=angle_target-imu_rol；反馈速度单位为TIM8计数/控制周期的三点平均，不是rpm/turn/s。

| 日志 | av_kp | 前3s角偏离RMS(deg) | 前3s角度峰峰值(deg) | 4～10s角度std(deg) | 4～10s速度均值 | 4～17s速度绝对值均值 | 0～17s动态误差RMS(deg) |
|---|---:|---:|---:|---:|---:|---:|---:|
| 011736 | 1.10 | 0.2023 | 1.0743 | 0.0423 | -5.511 | 6.101 | 0.1641 |
| 011808 | 1.10 | 0.2689 | 1.3166 | 0.0495 | +1.989 | 5.040 | 0.1942 |
| 011846 | 1.05 | 0.2011 | 0.8791 | 0.0371 | -1.168 | 4.514 | 0.1543 |
| 011919 | 1.05 | 0.2253 | 1.0076 | 0.0428 | -12.250 | 11.121 | 0.2072 |

1.05对初期回摆有改善线索：反向峰-0.219/-0.354deg，对照1.10为-0.467/-0.526deg；初期反馈正峰29.333/36.333，对照34.667/40.667。但触发初始反馈分别为-6.333/-4.000，对照+4.667/-2.000，不能把绝对速度峰下降全部算作增益收益。

1.05没有满足“初期回摆与速度恢复同时、可重复改善”的预设保留条件：011846的共同17s指标较好，随后18～21s反馈均值又达-13.00，动态误差重新越过±0.3deg；011919在4～17s反馈全为负，范围-19.667～-2.000，均值/绝对值均值均为11.121的幅值，末3s仍均值-12.529。后者不是正反抵消造成的均值，也不是通信缺帧导致的假象。

完整记录动态±0.3deg末段保持起点/持续时间：1.10为1.425/16.212s、3.812/20.053s；1.05为20.239/3.561s、17.447/5.357s。各记录长度不同，其中011736只检查到17.637s；因此以共同17s指标为主要对照，把完整窗口作为迟发拖尾证据，不宣称两档最终整定时间已精确辨识。011846在共同17s内的1.646s保持起点只针对已记录样本，其后存在缺帧且在更长记录中再次越界。

4～10s D逐帧抖动分别0.1438/0.1712（1.10）、0.1541/0.1219（1.05），无一致变大；当前排除1.05的主要理由是恢复一致性和速度残余，不是D噪声或饱和。1.10也有残余速度，本批不再复现上轮4～10s约±1.13的低均值，不能称其对所有摆放/初态都最优。

### 不同zero两窗的补充观察

005522（zero=-1.42）初期RMS=0.2059deg、4～10s速度均值+6.824、10～17s均值+15.088，触发时已是-14；005640（zero=-1.45）初期RMS仅0.1571deg、峰峰值0.6531deg，但4～10s均值+7.299，之后仍有较长正反转动，完整±0.3deg末段起点20.234s。它说明单次初期摆幅很小仍不等于飞轮速度恢复；不据此追求一个跨地面的固定angular_zero，也不把这两窗当成1.10优于1.05的公平对照。

### 决策与下一步

verdict: keep av_kp=1.10、an_kd=-1.20作为暂留工作基线；建议从最后一窗的1.05只恢复到1.10，结束av_kp扫描，不要求重复更多1.05/1.10对照。1.05的初期收益存在，但没有达到上一轮预先规定的双目标保留条件。只追加分析记录，未修改固件默认值或操作车上参数。

next: 先恢复av_kp=1.10，维持本轮zero=-1.47和其余参数，采一窗同样TEST作当次基线；随后仅将fw_kp从-0.160改为-0.165（USER/ui/ui.c:85的一格0.005，绝对值增加3.125%），采两窗同样TEST。每窗30s，第5～8s触发0.3deg/400ms，至少保留20s响应，尽量匹配低初始飞轮速度。此试验固定角速度/角度环，检验加强按速度产生的姿态目标补偿是否能减少扰动后的长期转动；不是已确定fw_kp偏小，也不保证增益增大就更快收敛。

依据当前源码USER/PID/PID.c:44-54，fw_kp影响速度偏置的比例分量，而积分状态限幅±200，在fw_ki=-0.081时I贡献最多±0.0162deg；fw_kd不参与该控制表达式。现有记录在姿态摆动已较小时仍有速度拖尾，因此先对速度补偿P作一格验证，不同时改变fw_ki/限幅或重新修改av/an增益。该环与姿态环耦合，评价两窗的4～10s和10～20s速度绝对值均值、正反拖尾、初期角度峰峰值及D波动/饱和。只有速度恢复有重复收益且姿态响应无明显代价才保留；若出现更大持续摆动、饱和或速度拖尾加重，fw_kp回到-0.160。不重复历史已回滚的PWM_accel硬限幅方案。

---

## iter 14  2026-10-13  focus: fw_kp=-0.160/-0.165/-0.155 六窗比较

change: 用户完成六次TEST。原始CSV核实为三档各两次：-0.160对应012838/012915，-0.165对应012959/013032，-0.155对应013123/013154。文件均为`logs/telem_20261013_<尾号>.csv`；后两窗是减小绝对值到-0.155，不是继续增加到-0.170。

### 数据条件

- 六窗固定av=1.10/0/1.115、an=-7.30/0/-1.20、fw_ki=-0.081/fw_kd=0、zero=-1.47、servo_ctl=0。各窗口内无参数变化，未混入预设。
- 六窗均仅一次TEST，真实偏置0.300deg、标志时长400ms。012838摘要显示0.3158deg，是混入了同时更新的其他目标补偿；在角度环更新点从angle_target减去zero/pwm_accel/fly_gain/servo补偿，重建结果为0.300deg。
- 六窗M0全程开启，STM32指令SAT=0，IMU CRC累计/新增均0，TEST响应段序号连续，实际环频399.82～399.84Hz。采集开头的序号缺口都早于TEST。
- TEST后可见响应分别13.606、23.815、19.373、24.070、27.561、21.839s。第一窗按键较晚，因此全组整体指标统一至TEST后13s，尾段比较用4～13s；10～20s只能在时长足够的窗口内描述，不能把不同长度当成统一对照。

### 同口径结果

下表每格为同档第一次/第二次。角偏离相对TEST前200ms平均姿态；动态误差=angle_target-imu_rol；反馈速度单位为TIM8计数/控制周期的三点平均，不是rpm或turn/s。使用速度绝对值均值，避免正反转抵消。

| fw_kp | 前3s角偏离RMS(deg) | 前3s角度峰峰值(deg) | 4～13s速度绝对值均值 | 4～13s角度std(deg) | 4～13s D逐帧变化均值 | 0～13s动态误差RMS(deg) |
|---|---:|---:|---:|---:|---:|---:|
| -0.160 | 0.2129/0.2061 | 0.9741/0.9038 | 3.046/5.495 | 0.0340/0.0426 | 0.1287/0.1096 | 0.1569/0.1964 |
| -0.165 | 0.2299/0.1960 | 1.0421/0.9187 | 4.397/3.506 | 0.0446/0.0446 | 0.1312/0.1653 | 0.1926/0.1873 |
| -0.155 | 0.1944/0.2057 | 0.8615/1.0239 | 9.288/4.810 | 0.0522/0.0444 | 0.1676/0.1508 | 0.2117/0.1884 |

- **-0.165没有达到替换基线的证据标准**：4～13s速度绝对值均值组均值3.95，对照4.27，改善约7.5%，明显小于本批同档重复差异，不能当作确定收益。两窗正向偏离峰0.557/0.504deg低于基线0.649/0.600deg，但反向偏离为-0.485/-0.415deg，比基线-0.325/-0.304deg更深；后段角度std及D逐帧变化也均高于基线两窗。是响应取舍，没有证据认为所有指标都改善；D输出变化不等于已证明传感器噪声放大。
- **-0.155有更明显的早期速度拖尾**：4～10s速度绝对值均值9.284/5.841，对照3.647/5.379。013123在4～13s反馈基本保持正向，均值+9.288，10～20s仍+6.663，动态±0.3deg保持起点直到10.564s；013154较好，但不足以抵消另一窗长期转动。不保留此档。
- **-0.160继续作为工作基线**：本批两窗动态±0.3deg保持起点为1.521/3.541s；-0.165为2.976/2.316s，-0.155为10.564/2.296s。六窗在各自完整记录内均没有后续再越过此宽带，但检查时长不同；第一窗仅13.606s。该宽带与注入幅值相同，不能据此宣称姿态及飞轮速度已完全恢复。
- 各自末3s速度绝对值均值依次为2.09/1.66、3.22/2.19、2.63/6.06，仅作尾段描述，不能用不同终点严格排序。动态±0.1deg末段保持分别为未保持/0.010s、0.160/1.175s、0.955/0.365s；尚未证明紧带内长期稳定。

### 初态与积分限制的解释边界

触发时反馈速度：基线+1.333/-2.667，-0.165组+3.000/+2.333，-0.155组-6.000/0.000。触发时角速度、姿态和脉冲前速度均值也不同，每档仅两次且顺序执行；不能把组差异解释为严格因果或统计显著的最优点。

源码USER/PID/PID.c:44-54仍为速度P偏置加限幅积分：积分状态±200、fw_ki=-0.081，对姿态目标的I贡献最多±0.0162deg。利用loop_cnt%60==0的同步速度环采样反推，4～13s积分贴限占比分别20.0%/28.3%、25.0%/95.0%、100.0%/58.3%。013123的持续正向残余与积分长期贴上限同时存在；这证明积分状态受限，不等于证明积分限幅就是唯一根因，更不能把贴限率直接当成应提高fw_ki或扩大限幅的依据。不得混淆该积分限幅、STM32速度指令限幅与ODrive电流限制；本批没有电流实测。

### 决策与下一阶段

verdict: keep fw_kp=-0.160，保留av_kp=1.10、an_kd=-1.20；建议从最后一次-0.155只恢复到-0.160。-0.165暂不保留，-0.155不保留，停止本轮fw_kp邻近档扫描，不继续推到-0.170或-0.150，也不同时调整fw_ki或积分限幅。该结论遵循预先设定的“速度恢复重复改善且姿态无明显代价”判据，不是认定-0.160为所有地面下的最优参数。

当前工作基线：av=1.10/0/1.115，an=-7.30/0/-1.20，fw=-0.160/-0.081/0，当前摆放zero=-1.47、servo_ctl=0。本轮只追加日志分析，没有更改固件默认值、遥测脚本或车上设置。

next: 转入固定参数的慢响应诊断，不再安排新一档增益试探。恢复上述基线后，在同场地/朝向固定零点采两窗60s：一窗完全静置且不触发TEST，另一窗第5～8s只触发一次相同0.3deg/400ms TEST。用途是区分无扰动也存在的慢速漂移，与TEST导致的额外速度残余，并观察30s以后是否仍持续或反复反转；比较速度绝对值/漂移、动态角误差、积分贴限与其时序。若中途扶车，标记时刻并截断自主响应。这是对当前基线和慢漂移机制的验证，不是追求通用固定angular_zero，也不预先批准任何结构/限幅改动。

---

## iter 15  2026-10-13  focus: 60s静置/TEST区分慢速残余与积分限幅

change: 用户采集四个约60s窗口，并确认同一场地、同一朝向，除TEST外没有扶车或额外扰动，仅调整了参数和零点。文件为`logs/telem_20261013_<尾号>.csv`。

### 条件核对

| 日志 | 类型 | fw_kp | zero | 采集时长(s) | TEST后的响应(s) |
|---|---|---:|---:|---:|---:|
| 014448 | 静置，无TEST | -0.155 | -1.46 | 60.030 | — |
| 014632 | 一次TEST | -0.155 | -1.46 | 61.331 | 53.493 |
| 014758 | 一次TEST | -0.160 | -1.46 | 61.422 | 53.823 |
| 015028 | 静置，无TEST | -0.160 | -1.45 | 61.322 | — |

四窗固定av=1.10/0/1.115、an=-7.30/0/-1.20、fw_ki=-0.081/fw_kd=0、servo_ctl=0；窗口内参数不变。两次TEST均为真实0.300deg/400ms，分别在采集第7.838/7.599s触发。四窗M0全程开启、STM32指令SAT=0、IMU CRC累计/新增均0；014448全程连续，其余仅采集开头约1.3s有序号缺口，两窗TEST后均连续。

前两窗构成相同参数/zero的静置与TEST对照。-0.160的静置和TEST零点不同，不能当作完全匹配对照；两次TEST虽然zero相同，初始速度、积分状态也不同，不能据单次结果给两档fw_kp重新作因果排序。静置统计取采集第2～60s，避开起始缺帧；长响应尾段统一取TEST后30～50s。以下速度单位均为编码器计数/控制周期的三点平均，不是rpm/turn/s。

### 主要观测

| 日志/分析段 | 反馈速度均值 | 速度绝对值均值 | 速度std | 角度std(deg) | 动态角误差RMS(deg) | 速度积分贴下限占比 |
|---|---:|---:|---:|---:|---:|---:|
| 014448静置2～60s | -5.534 | 5.551 | 3.111 | 0.0398 | 0.0948 | 100% |
| 014632 TEST后30～50s | -9.298 | 9.298 | 3.693 | 0.0448 | 0.1398 | 100% |
| 014758 TEST后30～50s | -12.887 | 12.887 | 3.718 | 0.0582 | 0.1933 | 100% |
| 015028静置2～60s | -0.349 | 4.143 | 4.929 | 0.0360 | 0.0734 | 43.2%（另有14.0%贴上限） |

1. **持续余速并非只由TEST造成。** 014448未注入扰动，2～60s仍有97.0%的样本为负速度，50～60s均值-7.756；速度积分整个分析段维持-200。014632在TEST前5s速度已均值-7.389，积分也贴-200；TEST后30～50s为-9.298，末10s仍-8.322。因此不能把全部余速解释为飞轮惯性导致的脉冲衰减。TEST可以改变慢状态，但无TEST时问题已经存在。
2. **延长观察揭示了30s摘要遗漏的尾段。** 两次TEST前3s角偏离RMS=0.2029/0.1989deg，但30～50s速度全为负，未回到近零。完整记录的动态±0.3deg末段保持起点39.252/51.997s，±0.1deg最终仅保持0.680/0.481s；不能用bridge默认3s摘要的2.771/2.160s恢复时间代表全系统恢复。动态目标包含速度补偿，这些误差越界不等于车身本身出现同等幅度的倾倒。
3. **最后静置窗均值接近零，仍有慢速正反转。** 015028第10～20s速度均值-4.261，第40～50s变为+6.669；全分析段速度范围-9.333～+14.333，绝对值均值4.143。均值-0.349不能当作稳定零速；zero从-1.46变成-1.45，也不能把其改善全归因于fw_kp。该窗说明工作状态对小偏置敏感，不是建议把-1.45当成跨地面的通用最优零点。
4. **晚期仍在下发非零速度指令。** 两次TEST后30～50s set_speed0均值为-0.908/-1.260，反馈均值为-9.298/-12.887。持续转动同时存在持续同向命令，不能直接归因于电机被大惯量拖着滑行，或驱动电流能力不足。本批没有电流测量，也没有ODrive内部闭环误差记录。

### 源码与积分状态复核

USER/PID/PID.c:44-54中速度环每60个控制周期更新，积分状态累加整数化速度误差并限幅±200；其输出为`encoder_bias*fw_kp/10 + integral*fw_ki/1000`。在fw_ki=-0.081时，积分对角度目标的最大贡献仅±0.0162deg；贴下限-200时贡献为+0.0162deg，持续负速度已不能再增加这部分慢补偿。

速度积分没有直接遥测字段。这里取loop_cnt%60==0的同步更新样本，从pwm_accel减去速度P分量反推，并独立检查相邻更新周期的“累加→±200限幅”递推。四窗共1599个连续递推对，最大状态误差约0.00061，符合浮点舍入；不是误把角速度内环inner_i当成速度积分。摘要显示内环I=0%与这里速度积分贴限并不矛盾。

两次TEST后10～20s积分贴下限占比89.6%/97.0%，30～50s均为100%；014448无TEST也100%贴下限。这比短窗口中偶尔触限更支持“慢速偏置补偿范围受限，需要验证”的判断。静置/尾段实测roll-zero均值约+0.020/+0.030/+0.035deg，已与±0.0162deg的积分补偿同量级；但平均姿态不是独立测得的机械平衡点，gyro均值也有变化，不能直接用这些差值反算唯一所需积分量或认定偏置来源。

传感器偏置、地面/接触几何、慢环耦合和初态仍可能共同贡献；本轮不能唯一定位它们，也没有证据指向速度指令饱和。更大的积分范围也可能改变慢速正反摆动，必须对照验证。

### 决策与具体候选

verdict: 保持av_kp=1.10、an_kd=-1.20和fw_kp=-0.160作为暂留工作基线；尚未达到长期零速/紧带恢复目标。停止av_kp/fw_kp邻近档扫描，不继续追逐固定angular_zero，不据此宣称惯量适配完成。

next candidate（尚未实施/烧录）: 优先验证**仅将Velocity_Control中的积分状态限幅±200放宽到±400**，保持fw_ki=-0.081及所有PID增益不变。这样最大I补偿从±0.0162deg增至±0.0324deg，而未触限区间的累加规律与积分系数不变；相对原上限额外放宽0.0162deg，是用于检验补偿范围受限假设的一步试验，不是从质量比推导的整定值，也不保证足够覆盖所有偏置。

选择该候选是为了把“积分作用范围”与“积分系数/累加速度”分开验证；直接提高fw_ki会同时改变两者。代码修改应只涉及USER/PID/PID.c:50-53的四处状态限幅常量，保留P分量、总pwm_accel输出及现有保护逻辑；这不是历史iter5失败的总输出±0.5deg截断方案。

进入该代码试验时，需保留GBK/CRLF、检查仅预期差异并编译；编译通过只代表构建验证。测试应固定当时的场地/朝向/零点（当前最后一窗为-1.45），使用改前后同条件的60s静置及0.3deg/400ms TEST记录，比较速度绝对值均值、持续单向余速、低频反转幅度、姿态峰值和积分贴限。只有余速可重复下降且姿态/慢摆不明显恶化才保留；否则回到±200。当前已完成数据与源码分析，只追加本记录，没有修改控制源码、默认参数或操作车上设置，也没有请求再次进行相同的P增益扫描。

---

## iter 16  2026-10-13  focus: 舵机固定打角补偿与方向差异

change: 用户补充实际比赛扰动主要来自舵机转动，提交约03:46开始的各档静置数据，要求在av_kp=1.10下检查舵机补偿。用户确认同一场地/朝向、原地平衡、采集前固定打角、无扶车；后续说明部分记录因遥控器突然断电、舵机回中而放弃。以遥测实际servo_ctl分组，不以口述符号/档位作为标签。只分析和追加记录，未修改控制代码、菜单参数或烧录。

### 范围与数据质量

- 主批从`telem_20261013_034548.csv`（03:45:48，约03:46）至`telem_20261013_040523.csv`。29窗中有27个约30～31s的固定打角完整窗口。
- 排除035416（12.580s，8.55s后servo_ctl从+48回到0，9.024s到0）和035451（3.941s）。用户已说明断电回中背景，不把该回中段当作正常可复现舵机阶跃，更不把短记录解释为自行失衡。
- +12/+24/+36/+48/+60以及-12/-24/-48均各3窗；-32只有2窗，-60只有1窗；本批没有完整servo_ctl=0对照，也没有-36档。03:34～03:39的早期窗口zero=-1.38，且零位记录短或混合动作，不混入本批zero=-1.40的对照。
- 27窗参数均为av=1.10/0/1.115，an=-7.30/0/-1.20，fw=-0.160/-0.081/0，angular_zero=-1.40；窗内参数不变。所有flags=1：M0开启、M1关闭、无TEST、无STM32速度指令饱和；IMU CRC累计/新增均0。不能据此推断ODrive电流未限幅，本批无电流遥测。
- 统一使用每窗第2～30s，排除常见起始约1.3s遥测缺口。034803在20.384/20.393s各少1帧，其余完整窗在2s后连续。缺口不等于控制器停止运行。改用10～30s统计后主要方向差异仍成立。
- servo_ctl是软件限速后的控制量，不是舵机位置传感器测量，也不直接当作前轮实际转角（度）。now_speed0仍是TIM8计数/控制周期的三点平均，不是rpm。原始CSV重算反馈，未使用bridge中误取set_speed0的同名摘要。

### 固定打角结果

下表采用各窗2～30s统计后等权平均；“速度绝对值均值”先对每个样本取绝对值，防止正反转抵消。角度std是各窗内部标准差的平均，不含跨窗均值差异。

| servo_ctl | 次数 | 当前舵机补偿(deg) | 各窗速度均值 | 组速度绝对值均值 | 角度std(deg) |
|---|---:|---:|---|---:|---:|
| +12 | 3 | -0.0444 | -11.06 / -10.85 / -7.61 | 10.12 | 0.0594 |
| +24 | 3 | -0.1032 | -18.23 / -21.30 / -21.05 | 20.19 | 0.0801 |
| +36 | 3 | -0.1656 | -24.90 / -16.78 / -19.81 | 21.35 | 0.1052 |
| +48 | 3 | -0.2544 | -30.20 / -26.59 / -26.35 | 27.82 | 0.1259 |
| +60 | 3 | -0.3240 | -27.80 / -23.00 / -32.61 | 27.85 | 0.1147 |
| -12 | 3 | +0.0108 | +5.23 / +3.66 / +0.06 | 7.70 | 0.0620 |
| -24 | 3 | +0.0528 | -0.00 / -0.52 / -3.13 | 6.85 | 0.0605 |
| -32 | 2 | +0.1088 | -1.94 / +1.73 | 6.84 | 0.0542 |
| -48 | 3 | +0.1728 | -6.38 / -7.90 / -3.73 | 7.34 | 0.0523 |
| -60 | 1 | +0.2280 | -9.44 | 9.55 | 0.0624 |

分组文件尾号：+12=034548/034621/034705；+24=034803/034842/034923；+36=035054/035128/035212；+48=035304/035340/035458；+60=035546/035618/035649；-12=035747/035833/035952；-24=040030/040101/040139；-32=040216/040249；-48=040326/040357/040429；-60=040523。完整文件名为`logs/telem_20261013_<尾号>.csv`。

1. **正向固定打角的持续负转可重复，不能归于转舵瞬间。** +24三窗20～30s速度均值仍为-18.96/-20.19/-17.24；+48为-41.33/-18.96/-31.96；+60为-26.99/-24.94/-26.25。主批窗内servo_ctl恒定，故未记录打角开始和持续时间，不能从这些窗口计算正常舵机动作的超调或恢复时间。
2. **方向差异很大。** +48速度绝对值均值27.82，-48为7.34，约3.8倍；对应姿态std均值0.1259/0.0523deg。负向-24/-32有小的有符号均值，但绝对值仍约6.8，仍存在正反转，不称为零速收敛。角度顺序与时间相关，缺少同批零位复测，不能把全部差异唯一归因于补偿表，也不把三个连续窗口当作三个独立随机化实验。
3. **积分长期用于抵消正向打角偏置。** +12/+24/+36/+48/+60速度积分贴-200比例依次93.4%/100%/88.6%/97.0%/98.8%。源码仍是±200，之前iter15提出的±400尚未实施。同步速度环反推积分并检查递推，主批最大状态残差约0.00151，符合浮点精度。贴限说明余量用尽，但不能证明扩大积分就是本次转向问题的适当修复。
4. **持续转速有对应速度命令。** +48组set_speed0均值-2.702，+60为-2.716（ODrive速度指令单位）；不是仅观察到飞轮无指令滑行。全组未撞STM32的±18速度指令限幅，不能把方向差异解释为已证实的电机能力不足。

### 当前舵机补偿的实际含义

源码USER/PID/PID.c:135-177：`G(s) = s * (Servo_Gain_K + Servo_ZERO[index(s)])`。它是按软件位置查分段系数，再形成持续的姿态目标偏置；不是对舵机速度/加速度的瞬态前馈，也不是直接电机转矩补偿。USER/Balane/Balane.c:161-181先对Servo_Ctl限速，再计算G并加进角度目标：`zero + pwm_accel + G + Fly_Gain + TEST`。没有实际舵机位置反馈用来校正机械迟滞。

遥测虽没有独立sgain字段，但全组由`servo_zhongzhi_gain/s - Servo_ZERO[index]`反推的Servo_Gain_K均约0.0015，与当前源码默认一致；角度环同步帧各补偿之和与angle_target最大偏差不到1.8e-7deg。补偿确实已生效，不是菜单数值没有进入控制器。新界面的Zservo显示`zero+G`，不包括pwm_accel/Fly_Gain，也不是实际测出的机械平衡点。

**当前曲线存在需要重新核定的方向/幅值匹配线索。** +48的zero+G=-1.6544deg，而实测平均roll约-1.5514deg，相差+0.1030deg；+60相差+0.1033deg。-48的对应差为+0.0325deg。这些值与持续负转共同支持“正向较大打角的补偿偏负、负向较大打角也有剩余偏置”的假设。但闭环平均roll不是独立测量的物理平衡点，不能直接把上述差值加回表内并宣称完成标定，也不能仅凭左右曲线不对称判定错误；机构本身可能不对称。

**分段表不连续，是独立的动态风险线索。** 当前G(+10)=+0.0050deg、G(+11)=-0.0407deg，跨档跳变-0.0457deg；G(+40)=-0.1840deg、G(+41)=-0.2173deg，跳变-0.0333deg；负侧-10到-11则从-0.0050跳到+0.0099deg。舵机位置限速不保证合成角度目标连续。它可能在实际转舵时额外激励平衡环，但本批没有可比的正常转动记录，尚不能确定其实际贡献或主导性。

`sgain`只是额外线性斜率，不是整张表的比例缩放，更不是开关：sgain=0仍保留Servo_ZERO表补偿。增大sgain会让正向G更正、负向G更负；因此不能用一个全局增量同时修正本批两侧大档都表现出的同向余速。直接给整张表乘2.38145也没有依据。

### 决策与下一步

verdict: 暂留当前PID（av_kp=1.10等）和积分状态限幅±200，把下一项验证转向舵机补偿；iter15的积分限幅扩大候选暂缓，不与此次舵机标定同时实施。当前证据支持检查固定打角曲线，不能宣称比赛转舵冲击已被定位或解决。

next candidate（未执行）：先在**固定servo_ctl=+48**做一组局部方向验证，利用菜单仅改`sgain: 0.0015 → 0.0020`，使本档G从-0.2544变为-0.2304deg（+0.024deg）；其它PID、zero、积分限幅及条件不变。这是局部诊断探针，不是最终全局推荐参数，也不能带着它直接重扫负向档（-48会相反改变-0.024deg）。采用A→B→B→A的60s静置窗口、无TEST，各窗打角和菜单值稳定后开始；比较共同10～60s的速度绝对值、单向余速、慢速摆动和姿态std，借回到A检查时间漂移。重复改善才支持该方向；若摆动或余速加重，立即回0.0015。本阶段不按每个角度重新找angular_zero。

若局部验证支持曲线失配，后续再对正负方向分别校准并设计连续插值，一次只改幅值或连续性之一；不能现在直接用闭环均值替换整表。之后记录真正的舵机动作（先采5～10s零位基线，再相同速度打角、保持、回中，左右分别重复），覆盖动作前后，才能评价比赛相关的瞬态补偿；无需再用OLED TEST代替实际转舵。

本轮只追加本记录，保留工作区既有UI/显示/测试文件修改。未修改PID、舵机表、积分限幅或桥接脚本，未操作硬件。

---

## iter 17  2026-10-13  focus: 固定servo_ctl=+48的sgain扫描

change: 用户新增七窗，并确认同一场地/朝向、无扶车或其他扰动，仅调整sgain。实际不是上一轮建议的60s A-B-B-A，而是每档一窗约30～31s的扫描；按实际数据分析，不把它当作已经完成重复验证。

### 数据与参数核实

文件为`logs/telem_20261013_<尾号>.csv`，采集顺序044329、044429、044518、044603、044640、044717、044754。sgain依次0.0020、0.0015、0.0030、0.0035、0.0040、0.0045、0.0050，均固定servo_ctl=+48。每窗内sgain/控制量/PID/零点不变，无TEST。

七窗共同参数：av=1.10/0/1.115，an=-7.30/0/-1.20，fw=-0.160/-0.081/0，angular_zero=-1.40。flags始终1（M0开启，M1关闭，无重启、TEST或STM32速度指令饱和），IMU CRC累计/新增均0。044329连续，其余缺帧仅在开头1.326s以内；统计段均连续。车上时间210.387～506.103s递增，记录之间没有计时复位，仍不能用这一点证明未发生未记录的物理变化；同场地条件来自用户确认。

sgain不在遥测参数字段中，依照当前Servo_ZERO[4]=-0.0068，从`servo_zhongzhi_gain/48+0.0068`反推；实测补偿与上述各值匹配。角度环同步帧目标之和最大残差约1.8e-7deg；速度环积分递推1401对的最大反推状态残差约0.00151，与当前±200限幅匹配。PID.c没有实施iter15的±400候选。

### 同口径比较

主指标取每窗第10～30s，避开起始缺帧与较早初态变化；另以2～30s复核方向。速度单位为TIM8计数/控制周期的三点平均，不是rpm/turn/s。速度绝对值均值按逐样本绝对值计算。下表按sgain大小排列，采集顺序中的0.0020早于0.0015。

| 日志 | sgain | 舵机补偿G(deg) | 速度均值 | 速度绝对值均值 | 姿态std(deg) | 动态角误差RMS(deg) | D逐帧抖动 | 积分贴下限 |
|---|---:|---:|---:|---:|---:|---:|---:|---:|
| 044429 | 0.0015 | -0.2544 | -30.661 | 30.661 | 0.1082 | 0.4371 | 0.1478 | 100% |
| 044329 | 0.0020 | -0.2304 | -24.389 | 24.497 | 0.1238 | 0.3718 | 0.1570 | 97.0% |
| 044518 | 0.0030 | -0.1824 | -18.985 | 18.985 | 0.0855 | 0.2735 | 0.1448 | 100% |
| 044603 | 0.0035 | -0.1584 | -19.658 | 19.658 | 0.0868 | 0.2904 | 0.1405 | 100% |
| 044640 | 0.0040 | -0.1344 | -18.456 | 18.456 | 0.0789 | 0.2632 | 0.1432 | 100% |
| 044717 | 0.0045 | -0.1104 | -11.786 | 11.786 | 0.0626 | 0.1806 | 0.1668 | 100% |
| 044754 | 0.0050 | -0.0864 | -4.633 | 4.872 | 0.0349 | 0.0860 | 0.1490 | 67.7% |

- **修正方向得到较强支持。** 在PID与零点不变的条件下，减小+48处负补偿幅值，伴随持续负转及姿态波动总体下降。0.0050相对本批0.0015，10～30s速度绝对值均值下降84.1%、姿态std下降67.7%；D逐帧变化仅增加约0.8%，没有同幅度恶化。2～30s重算分别为速度绝对值28.983→4.352（下降85.0%）、姿态std0.1099→0.0372（下降66.1%），结论不是选某个时间段才出现。这里是本批单窗观测差异，不是可保证的重复收益或统计显著性声明。
- **不支持简单的“sgain每加一档都更好”。** 0.0020的姿态std比本批0.0015更高；0.0030/0.0035/0.0040的后段余速改善没有逐档单调关系；0.0045的D逐帧变化也偏高。不能按七点拟合直线后外推一个精确零速参数，更不建议直接继续加到0.0055/0.0060。
- **0.0050是本批+48最佳观测候选，但仍未零速收敛。** 10～30s速度90.6%为负，范围-12.333～+4.000；平均-4.633，积分67.7%贴下限。20～30s均值-3.464、绝对值均值3.783，但积分贴下限又达82.1%。最后2s速度均值-6.45，因此不能把后10s均值改善解读为单调趋零或积分问题已完全消除。
- **全窗近零均值会掩盖前后抵消。** 0.0050在4～8s的两段速度均值为+4.06/+4.82，14～16s变为-8.90，末段又负转。2～30s均值-2.501比10～30s的-4.633乐观，仍需长窗确认慢漂移/反转。
- **尚未测到比赛中的转舵瞬态。** 七窗servo_ctl均恒定48，无法从本批计算正常打角开始时的冲击或回中恢复时间；仍是局部固定打角补偿的试验。

### 解释与适用范围

当前+48所在区间：`G=48*(sgain-0.0068)`。0.0015→0.0050使G由-0.2544→-0.0864deg，增加0.1680deg，尚未反转补偿符号。结果更支持检查旧舵机补偿曲线与当前整车状态的匹配，不能把所有问题归于av_kp偏小或大飞轮难以刹停。但各候选仅测一次、0.0030之后与时间顺序相关、无最终回到基线的记录；平均roll也随时间/参数变化，不能据此唯一排除传感器/接触状态慢变。

**0.0050不能直接设为全局通用值。** 相同全局sgain变化在servo_ctl=-48处，会把G从+0.1728降到+0.0048deg，减少0.1680deg；上一批负向大档已经有负向余速，这样改变没有验证。+12/+24/+36/+60也没有在新sgain下验证。若后续确定只需校正正向某区间，应保留负向标定并检查区间连续性，不能现在把全局sgain写入默认值，或仅修改单个表项造成新的跨档跳变。

### 决策与下一步

verdict: 把sgain=0.0050列为**固定servo_ctl=+48下的复测候选**；本批支持减小该位置负补偿幅值的方向，尚未完成重复、长时间及动态验证。不改av/an/fw PID或积分限幅，不将其推广为整张转向补偿表的最终参数，也不按质量比统一放大补偿。

next: 停止继续上探sgain；仅做三窗60s固定+48、无TEST的`0.0050 → 0.0015 → 0.0050`对照，其余参数和zero=-1.40、场地/朝向不变，菜单值与舵机控制量稳定后开始记录。比较共同10～60s的速度绝对值均值、持续余速、姿态std、低频反转及积分贴限；回到0.0015用于检查时间漂移，前后两窗0.0050用于检查重复性。出现明显加重的摆动或转速异常时结束并记录时刻。只有两次候选的收益均出现且无姿态/慢摆代价，才进入邻近角度与实际转动的补偿标定；正常全角度操作前恢复原sgain=0.0015，不能把局部候选直接用于未验证的负向转向。

本轮仅追加记录，未修改控制源码、默认值或硬件参数；保留既有UI/显示/测试文件改动。源码检查和CSV重算不等于固件已改或比赛动态性能已验证。

---

## iter 18  2026-10-13  focus: +48局部sgain重复验证及0.0058补充窗

change: 用户完成四窗，实际顺序sgain=0.0058→0.0050→0.0015→0.0050。用户确认本批同一场地/朝向且无扶车；四窗zero均为-1.47，与上批-1.40不同，具体调整原因未说明，不臆测原因。依据本批内部对照判断，不把跨批绝对转速变化当作同条件参数收益。采集仍约31s，没有完成上一轮建议的60s时长。

### 条件与质量

文件为`logs/telem_20261013_<尾号>.csv`：045734（31.243s）、045820（31.424s）、045908（31.333s）、045958（31.318s）。均固定servo_ctl=+48，av=1.10/0/1.115，an=-7.30/0/-1.20，fw=-0.160/-0.081/0，zero=-1.47；各窗内参数、舵机位置和补偿不变。sgain从G/48+0.0068反推，与上述档位吻合，分别G=-0.0480001/-0.0864/-0.2544/-0.0864deg。

所有flags=1，M0开启，M1关闭，无TEST、重启或STM32速度指令饱和；IMU CRC累计/新增均0。代码仍限速度积分状态±200，未修改限幅或舵机表。同步速度环791对递推最大状态残差约0.00059，角度目标组成最大残差约1.2e-7deg。

045820/045908/045958的缺帧都只出现在开头1.326s以内，第2s后连续，构成干净的0.0050→0.0015→0.0050内部对照。045734的采样缺口持续存在：第2～30s少289帧（5.16%），第10～30s少251帧（6.28%），相邻记录最大间隔205ms；不能确认缺口内峰值或连续保持。该问题是遥测记录不完整，不等于证明控制器丢环。对10～30s以端点梯形积分作插值敏感性核对，速度均值/绝对值均值为+1.893/3.847，接近原始已收样本的+1.897/3.897；整体趋势未被这一检查推翻，但插值不恢复真实缺失数据。

### 同口径结果

主指标取每窗第10～30s；速度为TIM8计数/控制周期三点平均，不是rpm/turn/s。0.0058列仅作补充观察。

| 日志 | sgain | 速度均值 | 速度绝对值均值 | 姿态std(deg) | 动态角误差RMS(deg) | D逐帧变化 | 速度积分贴下限 |
|---|---:|---:|---:|---:|---:|---:|---:|
| 045734 | 0.0058 | +1.897 | 3.897 | 0.0323 | 0.0644 | 0.1293 | 27.4% |
| 045820 | 0.0050 | -7.518 | 7.518 | 0.0429 | 0.1206 | 0.1329 | 100% |
| 045908 | 0.0015 | -26.622 | 26.622 | 0.1017 | 0.3701 | 0.1646 | 100% |
| 045958 | 0.0050 | -10.143 | 10.232 | 0.0493 | 0.1605 | 0.1320 | 94.0% |

1. **0.0050相对原补偿的局部收益已得到两侧复现。** 两窗速度绝对值均值分别比中间0.0015低71.8%和61.6%，姿态std低57.9%和51.5%，D逐帧变化低19.2%和19.8%。第2～30s复核速度收益71.6%/61.7%，姿态收益56.8%/51.7%。同一候选在基线前后均改善，支持+48处旧负补偿幅值需要减小，较上一轮单向扫描更能抵抗简单时间漂移混淆；不是对所有地面/角度/动态动作的证明。
2. **0.0050仍保留持续负向余速。** 两窗20～30s均值-8.032/-11.777；后者25～30s为-14.359，不能称为单调趋零。积分在后10s均贴下限。这里只确认“相对旧补偿改善”，没有达到长期零速/积分余量充分的目标，也没有60s以后数据。
3. **0.0058有进一步降低余速的线索，但未完成复测。** 它第2～30s均值+0.143，绝对值均值仍4.426；5～10s均值-7.469，20～30s均值+3.983，最后10s几乎全为正。第10～30s速度范围-9.667～+9.000（仅已记录样本）。全窗近零均值来自前负后正部分抵消，不能由此宣称0.0058就是正确零速点。该窗后段积分不再贴下限，属于可继续观察的有利迹象，但单窗且有缺口，尚不足以取代0.0050作为已重复验证的局部工作候选。
4. **不以跨批速度数字判断候选退化。** 上批0.0050的zero=-1.40，本批-1.47，同一G对应的zero+G相差-0.07deg。在固定+48时，这个加性目标差值等价于约0.001458的sgain变化（仅目标表达式的代数等效，不是物理上应这样调参）。因此参数名相同并不代表合成目标条件相同；也不建议为每个打角去重新寻找一个独立angular_zero。

### 决策与阶段推进

verdict: **保留sgain=0.0050作为固定+48、当前条件下的局部验证候选**；旧0.0015在+48造成的较大持续负转已再次复现，不再要求重复这一组静置对照。0.0058作为补充探索结果，不因单窗均值接近零直接升级为最终参数，不继续上探更大sgain。不改av/an/fw PID或积分限幅，也不立即写入固件默认值。

作用范围仍严格局限：在servo_ctl=-48，sgain=0.0050会使G=+0.0048deg，0.0058会使G=-0.0336deg，而原值是+0.1728deg；未经验证的负向补偿甚至会反号。因此这些全局sgain设置只能用于明确限定方向的实验，不能推广为正常全角度操作参数。+48的局部验证不等于邻近角度或过渡路径已经标定。

next: 从静态方向确认转到用户实际关心的转舵扰动记录。先保持sgain=0.0050及本批其余参数/zero=-1.47，限定**0→+48→0**这一正向实验，不混入负向或OLED TEST。每窗60s，先在servo_ctl=0采约10s基线，用相同操作打到+48，保持到约40s再回0，继续记录至60s；重复两窗。动作必须发生在采集开始后，日志要覆盖完整打角和回中；以实际servo_ctl变化时间对齐，不把手动操作时刻当作精确阶跃。比较实际打角历程、补偿/总角目标变化、车体峰值和飞轮余速，以及回中后的恢复；必要时由数据再判断静态曲线、跨档跳变或动作速率的贡献。该过渡路径本身也是待验证对象，不能称为已验证的动态方案。

应使用原串口采集命令中的`--capture 60`（本批约31s尚不是60s记录）。若发生扶车、遥控器断电回中或其他异常，结束该次并说明时刻，避免混为正常动作响应。正常全角度操作前仍恢复原sgain=0.0015；本轮不追逐更细的单点零速参数，也不声称固定零点可跨场地通用。

本轮仅追加日志分析，未修改控制源码、默认参数、遥测桥接脚本或操作车上设置；既有UI/显示/测试改动保持原样。

---

## iter 19  2026-10-13  focus: 实际正向打舵、掉线回中与补偿跨档跳变

change: 用户新增`logs/telem_20261013_051519.csv`，确认位置与姿势一致；进一步确认约11.3s第一次回中由遥控器断电或掉线导致，没有扶车。当前仅有一条59.990s记录，包含两次打舵尝试，末尾未回到0。保留可用分段，不把整窗作废，也不把掉线回中当作正常指令响应。

### 数据和实际动作

11994帧，实际环频399.833Hz，遥测序号全程连续；IMU CRC累计/新增0。flags始终1：M0开启、M1关闭，无TEST、STM32速度指令饱和或重启。flags没有遥控链路健康字段，IMU CRC正常不能证明遥控连接正常。

本窗固定av=1.10/0/1.115，an=-7.30/0/-1.20，fw=-0.160/-0.081/0，sgain由非零舵机段反推为0.0050。zero=-1.40（上批为-1.47），窗内不变；不把两批绝对速度差解释为同条件参数退化。当前±200积分限幅、补偿表及控制公式没有修改。

| 车上相对时间(s) | 实际servo_ctl行为 | 分析用途 |
|---|---|---|
| 0～8.879 | 0 | 本窗动作前基线 |
| 8.879～11.315 | 0→4→8…→32 | 第一轮打舵，后被遥控掉线打断 |
| 11.315～11.620 | +32快速回0 | 用户确认的掉线回中，非正常重复动作 |
| 11.620～13.616 | 保持0 | 距掉线回中仅约2s，不能认作完全重置的独立初态 |
| 13.616～17.897 | 0→4→8…→48，历时4.281s | 第二轮正常手动打舵过程 |
| 17.897～55.188 | 保持+48约37.29s | 持舵后的持续转速与姿态 |
| 55.188～59.990 | +48→44→40…→20 | 回中未完成，无法评估回到0后的恢复 |

以上均为软件控制量变化时刻，无实际舵机位置反馈，不能当作机械转角已准确到位。第二轮是多次离散按键形成的约4.3s过程，不是0.3deg/400ms TEST或单次瞬时舵机阶跃。

掉线行为与源码一致：USER/ui/ui.h的遥控超时500ms；USER/ui/ui.c:503-515超时后停止后轮并设置servo_con=1，不关闭平衡；USER/vofa/vofa.c:86-114按约10ms/控制量1向0回中。遥测+32→0约0.305s与此路径相符，不能据此判定车自行失衡。

### 分段结果

速度仍为编码器计数/控制周期三点平均。动作前基线取2～8.5s，避免紧邻首个按键；持舵和尾段按实际+48指令区间划分，不混入末尾回中。

| 分段 | 速度均值 | 速度绝对值均值 | 姿态std(deg) | 速度积分贴下限 |
|---|---:|---:|---:|---:|
| 零位基线2～8.5s | -4.763 | 4.778 | 0.0370 | 100% |
| 第二次打舵13.616～17.897s | -9.850 | 9.850 | 0.0664 | 100% |
| +48保持17.897～55.188s | -15.114 | 15.114 | 0.0666 | 100% |
| +48保持末10s | -14.488 | 14.488 | 0.0571 | 100% |

- 基线在未打舵时已有负向转速及积分贴限，不能把全部余速归于舵机。进入+48后同向余速明显加重，保持超过30s仍没有回到近零；25～30s、45～50s、50～55s速度均值分别-17.42/-9.52/-19.06，存在慢变而非单调恢复。
- 第二次打舵相对动作前1s平均roll=-1.37990deg，打舵期间最大绝对偏离0.2059deg，包含到达+48后3s为0.2215deg。本次未出现大的倾倒或指令饱和；这些是相对初态的描述，不是已完成整定时间/过冲辨识，也不能与瞬时TEST直接等价比较。
- 持舵期间速度范围-33.333～-1.333，全部负转；平均set_speed0=-1.477，存在对应负向速度命令。平均|D|=0.0630、D逐帧变化0.1146，并未表现为只有动作时才出现的持续高频D抖动。
- 400个同步速度更新点反推积分均为-200（误差范围小于0.00037，递推也吻合）。本窗没有积分释放或反转的证据，但不能据此跳回扩大限幅而忽略转向相关偏置。

### 补偿跨档跳变已经在实际记录中出现

Servo_Gain仍是`s*(sgain+Servo_ZERO[index])`，在角度环中直接相加。同步角度环更新点的目标分解如下，pwm_accel在这三次目标更新中均未变化：

| 时间(s) | servo_ctl变化 | 舵机G变化(deg) | Fly_Gain变化(deg) | 总目标角变化(deg) | 内环D该帧 |
|---|---|---:|---:|---:|---:|
| 14.111 | +8→+12 | -0.034400 | +0.000167 | -0.034233 | +0.243878 |
| 16.917 | +40→+44 | -0.035200 | +0.000167 | -0.035033 | +0.474655 |
| 57.990 | +44→+40 | +0.035200 | +0.000167 | +0.035367 | -0.475390 |

因此，“分段补偿会制造目标角跳变”已从源码风险变为本次可观测事实，不是TEST混入或速度环同时更新造成的这几次目标跳变。16.917s处仅G跳变按控制公式就贡献-0.25696deg/s的角速度目标变化；按当前av_kp/av_kd，它对首次更新P+D输出的代数贡献约+0.5692（速度指令单位），但实际输出还叠加了姿态/角速度变化，不能把全部D峰或车身摆动都归到该项。

+40→+44处实际上一遥测帧set_speed0=-0.4975，本帧+0.4436，随后+0.005s为-0.0516；说明内环确有短时指令尖峰。没有对照修改前后数据，尚不能判断消除跨档跳变能改善多少，更不能说它解释了+48静止保持37s的所有余速。需把静态曲线匹配和动态连续性分开处理。

### 手动转向命令的附加代码观察

USER/ui/ui.h的按键步长是5，但ui_drive_steer()把新目标直接写入Servo_Ctl；balance()又把限速后的中间值覆盖同一变量。当前日志手动按键主要呈现4单位变化，Servo_Lim=4，与该实现一致：超过每周期限速的单次目标差值可能被丢弃，而不是下一拍继续追完目标。上位机模式会每拍重写绝对目标，行为不同。此点影响遥控动作的可重复性和步距，但不作为本窗持续负转的唯一根因；本轮未改这条路径，不能同时改变它与补偿曲线来做单变量验证。

### 决策与下一步

verdict: 本窗确认了真实打舵过程中的补偿跨档跳变和持舵后的持续余速；没有证据要求重新扫描av_kp。sgain=0.0050仍是+48局部候选，相对旧0.0015的历史内部对照收益保留，但当前条件下没有完成静态零速或动态恢复目标。不能以本窗推翻/重算上一批收益，因为zero、初态与动作轨迹不同。全局sgain不继续上探，也不改积分限幅。

下一项应补齐一条**遥控连接正常、完整回到0并保留尾段**的动作记录，避免继续靠固定打角均值代替动态评价；不重扫PID或sgain。先保证遥控器供电/连接持续正常，保持本窗参数/zero=-1.40，限定0→+48→0。采集90s：前10s保持0，随后按相同方式打到+48，保持约20s后开始回中，并确保显示servo_ctl实际到0后至少还记录20s。若中途掉线，注明时刻，把它作为异常输入分段处理。当前末尾未回0不是“回中后不收敛”的证据；下一条记录用于补上这一缺口。

进入控制代码修改时，优先候选是把位置分段补偿做成连续曲线，并保留已验证固定点（尤其+48）的补偿值用于隔离动态连续性影响；还应验证邻近角度和负向作用，不能直接把单个全局sgain当作整表标定。此为后续方案方向，尚未实施；不在同一轮同时改转向目标保持逻辑、sgain、积分限幅或PID。正常全角度运行仍不能直接使用仅在正向局部试验的sgain=0.0050。

本轮只追加记录，未修改控制源码、默认参数、遥测脚本或操作硬件，保留既有UI/显示/测试改动。

---

## iter 20  2026-10-14  focus: 完整回中后延迟慢响应与舵机补偿连续化候选

change: 用户新增`logs/telem_20261013_053426.csv`，90.033s，完整覆盖正向打舵、保持及回中后46.144s。用户明确确认：约44s回中后没有扶车、碰车或其他操作，遥控正常。因此55～74s的慢响应可按无外部操作尾段分析。本轮未改变控制参数或源码。

### 条件、动作与数据质量

实际参数全窗固定：av=1.10/0/1.115，an=-7.30/0/-1.20，fw=-0.160/-0.081/0，zero=-1.40；由非零舵机段及现有表反推sgain=0.0050。当前源码速度积分限幅仍为±200，Servo_Gain仍采用原分档表。flags全为1：平衡开启，后轮关闭，无TEST或STM32速度指令饱和；IMU CRC累计/新增均0。这不提供ODrive电流/转矩是否饱和的证明。

| 相对时间(s) | 软件servo_ctl及动作 |
|---|---|
| 0～5.483 | 保持0 |
| 5.483～6.413 | 短暂-4，之后回0；不臆测原因 |
| 6.413～8.604 | 保持0 |
| 8.604～14.901 | 逐档0→+48，历时6.297s |
| 14.901～37.636 | 保持+48，22.735s |
| 37.636～43.889 | 逐档+48→0，历时6.253s |
| 43.889～90.033 | 保持0，舵机补偿G全程严格为0 |

软件控制量不是实际舵机角度反馈；早期-4小动作意味着初始段不是完全孤立的单阶跃。主动作中未见上窗掉线式快速回中，但遥控健康仍以用户确认为依据，不能用IMU CRC代替。

共收16589帧，按首尾loop_cnt/2推得应有18000帧，缺1411帧（7.84%）；最大相邻记录间隔306ms。缺的是遥测记录，不等于控制环停止。主慢响应60～70s有1991帧，接近完整，速度均值+38.793；该慢响应不是仅由稀疏采样形成。另用相邻样本梯形积分检查时长加权敏感性，结论一致；插值不恢复缺失的真实峰值，也不能证明缺口内连续满足整定带。

### 回中后的完整结果

速度取原始CSV的now_speed0，为TIM8计数/控制周期三点平均，不是rpm。下表为已收样本统计；积分比例只在同步速度环更新点反推。

| 分段 | 速度均值 | 速度绝对值均值 | roll std(deg) | 动态角误差RMS(deg) | 积分贴限 |
|---|---:|---:|---:|---:|---|
| +48保持 | -11.804 | 11.804 | 0.0571 | 0.1754 | 下限86.9% |
| +48保持末10s | -10.860 | 10.860 | 0.0536 | 0.1692 | 下限100% |
| 回中后0～10s | +2.003 | 4.758 | 0.0419 | 0.0854 | 两侧均0% |
| 回中后10～30s | +29.580 | 29.580 | 0.0948 | 0.4046 | 上限83.9% |
| 回中后30s～结束 | +3.537 | 6.960 | 0.0552 | 0.1222 | 上限49.5% |
| 全窗最后10s | +7.232 | 7.236 | 0.0495 | 0.1197 | 上限66.7% |

- 回中后先减速，随后出现明显延迟放大：在60.771s、回中后16.882s，记录到now_speed0=+53。回中后10～30s速度绝对值均值约为前10s的6.2倍。只观察回中最初几秒会误判恢复。
- 71.210s记录到roll=-1.82830deg，相对zero约-0.42830deg；77.413s速度反向到-15.333。末10s又以正转为主，不能把一次过零当作已经收敛。未触发平衡关闭或STM32指令限幅，说明此次维持了平衡，但快速消除余速的目标未达成；单窗也不足以认定持续极限环或必然发散。
- 时长加权插值检查得到回中后0～10s/10～30s速度绝对值均值4.501/28.889，与原始样本4.758/29.580方向一致。末10s为6.954，对应原始7.236。

### 不能把延迟慢响应全部归因于舵机仍在施加补偿

回中后servo_ctl=0、G=0持续46.144s，而明显加速出现在回中十几秒后。故持续非零舵机位置补偿不是尾段直接输入；仍需考虑此前转舵激励留下的车体/飞轮状态，以及速度补偿与姿态闭环的慢响应、偏置变化。没有实际舵机位置、电流及接触力测量，不能排除机械回中偏差等因素，更不能由这一条记录唯一辨识根因。

同步速度更新点60.691s，now_speed0=51，反推积分状态约+200：

- 速度P输出：`51 * (-0.160) / 10 = -0.8160deg`。
- 速度I输出：`200 * (-0.081) / 1000 = -0.0162deg`。
- pwm_accel=-0.8322deg，Fly_Gain=+0.0255deg，总目标约-2.2067deg；当时roll约-1.4044deg。

这次目标角大幅偏移主要来自速度P项；这是分项贡献证据，不能单凭它认定fw_kp过大或直接决定新数值。514对连续同步更新的积分递推最大误差约0.000606，与±200夹紧逻辑吻合。积分贴限不等于已证明扩大积分上限能改善恢复，也没有理由把整体pwm_accel硬限幅作为速效修复（历史iter 5已有失败经验）。

### 舵机跨档跳变仍然成立，但只确认了输入侧问题

| 时间(s) | servo_ctl变化 | G变化(deg) | 总目标变化(deg) |
|---|---|---:|---:|
| 9.549 | +8→+12 | -0.0344 | -0.034900 |
| 13.751 | +40→+44 | -0.0352 | -0.035367 |
| 38.241 | +44→+40 | +0.0352 | +0.035200 |
| 42.953 | +12→+8 | +0.0344 | +0.034400 |

均在相邻同步角度更新点比较，pwm_accel未同时变化，微小差异由Fly_Gain贡献。该事实支持减少人为目标跳变，但不能证明它单独造成了后续几十秒的慢响应，也不能把当前D峰全部称为传感器噪声。

### 决策与下一项可审查实验

verdict: **完整动态基线已取得，当前能平衡但回中恢复不理想。** 不再要求重复同一套未改动的90s基线，不继续扫描全局sgain或追逐固定zero；本次数据也不足以给出新的最优PID。保留现有参数作为对照。

next: 优先候选为仅将正向舵机位置补偿改成连续分段线性曲线，保留0/+12/+24/+36/+48/+60这些已测固定指令处的原补偿值，尤其保持+48处G=-0.0864deg；这表示保留已有对照点，不表示这些点均已最优标定。PID、sgain=0.0050、zero=-1.40、积分限幅及手动目标保持逻辑不同时变动。负向曲线保持当前实现，本轮仍限定0→+48→0，不能把局部候选推广到正常全角度运行。

在sgain=0.0050下，该候选的离线代数值示例：

| servo_ctl | 当前G(deg) | 候选连续G(deg) |
|---:|---:|---:|
| 0 | 0 | 0 |
| +4 | +0.0160 | -0.0008 |
| +8 | +0.0320 | -0.0016 |
| +12 | -0.0024 | -0.0024 |
| +24 | -0.0192 | -0.0192 |
| +36 | -0.0396 | -0.0396 |
| +40 | -0.0440 | -0.0552 |
| +44 | -0.0792 | -0.0708 |
| +48 | -0.0864 | -0.0864 |
| +60 | -0.1140 | -0.1140 |

对应+8→+12的补偿变化由-0.0344减至-0.0008deg，+40→+44由-0.0352减至-0.0156deg。候选会改变中间角度的静态补偿，不能描述成“所有静态值不变，只加平滑”；这些也只是公式计算，不是闭环回放或硬件收益证明。

该一处修改实施并通过构建/端点与连续性验证后，再按相同操作记录两次90s完整往返，回到0后至少保留40s。先比较动作轨迹是否相近，再比较目标跳变、姿态峰值、回中后10～30s速度绝对值均值和末10s余速，不能只看短窗恢复。如果跳变减少但慢响应未改善，应将重点转到速度补偿与姿态环的耦合辨识；不继续靠加大sgain补救。若稳定性或主指标变差则回滚这一处改动。

本轮仅追加日志分析及候选定义，尚未实施连续曲线、修改固件默认值或操作硬件。保留既有UI/显示/测试文件改动；原AGENTS.md保持不变。源码核对、CSV重算和候选公式不等于新方案已上车验证。

---

## iter 21  2026-10-14  focus: 实施正向舵机补偿连续化，等待硬件对比

change: 用户确认“好的，开始修改吧”。仅修改`USER/PID/PID.c`中`Servo_Gain()`的正向计算分支，实施iter 20定义的连续分段线性候选；新增`tests/test_pid.c`及`tests/run_pid_tests.sh`用于回归验证。未烧录或操作硬件。

### 实现和保留边界

- 插值对象为舵机静态补偿值`s * Servo_ZERO[index]`，随后相加原有线性项`s * Servo_Gain_K`，不是直接插值系数，也没有增加低通滤波及其时间滞后。
- 正向原点补偿为0，保留+12/+24/+36/+48/+60处原公式输出；在任意菜单sgain下这些固定点均保留（容许浮点舍入误差）。中间指令处的补偿值会改变，这是本次实验变量。
- 对大于+60的正向范围，以原+70/+80/+90/+100输出为后续插值端点，+100以上接回原线性公式，覆盖当前+120上限，避免在实验范围外另造一个连接跳变。这些较大角度仅通过软件验证，尚未做本轮车上验证。
- 负向分支、原表、全局sgain可调项及默认0.0015不变；PID、zero、速度积分±200、转向限速/目标保持逻辑、遥测格式均不变。PID.c保留GBK和CRLF，修改区间之外逐字节保留。

| 指令/过程 | 旧补偿或变化(deg) | 新补偿或变化(deg) |
|---|---:|---:|
| +48固定点，sgain=0.0050 | -0.0864 | -0.0864 |
| +8→+12，同上 | -0.0344 | -0.0008 |
| +40→+44，同上 | -0.0352 | -0.0156 |

以上为代码输出，不是硬件响应收益或旧日志的闭环重演。连续分段线性曲线在节点处仍可改变斜率；软件指令本身逐档改变时也仍有有限的目标变化，不能称为所有冲击均已消除。

### 验证结果

- `sh tests/run_pid_tests.sh`：通过。直接编译当前生产PID.c的编码转换副本，在AddressSanitizer和UndefinedBehaviorSanitizer下验证：sgain菜单0～0.01的101档中，固定端点保持原输出、全部负向整数指令及+100以上尾段保持原公式输出；候选数值及日志中的两处跨档变化符合iter 20；正向0～120逐单位扫描没有旧分档跳变，反向扫描输出一致；改变sgain仍仅增加线性项。
- 主机编译只对生产PID翻译单元屏蔽既有`calculateGain()`中`abs(float)`的Clang警告；该无关函数未修改，测试自身仍使用`-Wall -Wextra -Werror`。源文件只在build副本中转换为UTF-8。
- `make -j4`：通过，生成`build/Fly_Dreams.elf/.hex/.bin`；text=48236、data=492、bss=8460。该固件包含当前工作区既有UI等改动；本轮未改写这些文件。构建不等于中断最坏执行时间或上车稳定性验证。
- 检查原始字节和散列：AGENTS.md、既有display/ui/测试桩及UI测试改动均原样保留；本日志仅追加。差异空白检查将CR识别为行尾，避免为了普通`git diff --check`对CRLF的提示而重编码旧文件。

verdict: **候选已实现，主机测试和固件构建通过，硬件效果待测。** 当前证据支持减少目标跳变，不保证解决iter 20记录的延迟慢响应。

next: 用户烧录后，在菜单核对并恢复本批对照设置：av=1.10/0/1.115，an=-7.30/0/-1.20，fw=-0.160/-0.081/0，sgain=0.0050，zero=-1.40。尤其启动av_kp仍为1.40、sgain仍为0.0015，重启后不能直接视为与上一窗同参数；不要误加载LOADwind。固定本次场地/朝向做两次90s记录，前约10s保持0，再用相近操作打到+48并保持约20s，回到0后至少留40s尾段；不加OLED TEST。

继续使用原端口/波特率，将采集参数设为`--capture 90`。比较实际动作轨迹、目标角变化、姿态峰值、回中后10～30s速度绝对值均值及末10s余速；以原始servo_zhongzhi_gain验证新曲线实际生效，例如sgain=0.0050时+8补偿约-0.0016deg。若跳变减少而慢响应未改善，下一步转向速度补偿与姿态环耦合分析，不继续扫描更大的sgain；稳定性或主指标变差则回滚本次正向分支改动。

---

## iter 22  2026-10-14  focus: 连续舵机补偿最后三窗实测，回中余速仍未解决

change: 用户要求以最后三条采集为准。本轮仅分析`logs/telem_20261014_022722.csv`、`022855.csv`、`023028.csv`，没有把较早两条新采集纳入评价。用户确认三次同一场地/朝向，除调整零点与转舵外无扶车或其他扰动；另确认第一窗约40.5s快速回中是遥控掉线或断电，分段保留，不按正常完整往返处理。

### 参数、实际动作和质量

三窗实际av=1.10/0/1.115，an=-7.30/0/-1.20，fw=-0.160/-0.081/0，zero=-1.35，各窗内不变。按新曲线反推sgain均为0.0050，补偿公式最大残差小于4.3e-8deg，确认连续曲线已在实际控制记录中生效。旧动态基线053426的zero=-1.40，新旧相差+0.05deg；不要求为追求统一零点把它调回，但该差异限制前后因果比较。

| 尾号 | 时长(s) | 持舵过程 | 最后回到0(s) | 回中尾段(s) | 遥测缺帧 |
|---|---:|---|---:|---:|---:|
| 022722 | 91.308 | +48保持21.915s；掉线回中后再次+48保持31.159s | 84.085 | 7.223 | 192/18255，1.052% |
| 022855 | 91.099 | +49保持46.330s | 71.731 | 19.368 | 139/18213，0.763% |
| 023028 | 91.094 | +48保持52.237s | 72.576 | 18.518 | 114/18212，0.626% |

- 第一窗初期有-4小动作，主打角13.260～18.567s；40.482～40.947s快速回中，约0.465s，与用户确认的掉线对应。43.278～46.459s再次打角，77.618s开始最后一次手动回中。不能将两次持舵当作完全独立初态。
- 第二窗打角13.941～20.564s，实际停在+49；G=-0.0887deg，相比+48的-0.0864多-0.0023deg。第三窗打角7.768～13.646s。正常手动回中分别耗时4.837/6.693s。
- 三窗flags均为1：平衡开启、后轮关闭、无TEST或STM32速度指令饱和；IMU CRC累计/新增均0。最大采样间隔125/205/85ms。第二窗回中尾段连续，第三窗尾段只缺36帧；缺帧不等于控制环停顿，IMU CRC正常也不证明遥控链路正常。
- 采集总时长达到91s，但没有一窗达到所需的回中后40s尾段。第一窗不用于长尾判断，后两窗支持约18s共同区间评价，不能报告30～40s恢复或长期整定时间。

### 曲线修复的实际输出验证

新记录+8补偿约-0.0016deg，+40约-0.0552deg，+44约-0.0708deg；+48保持-0.0864deg。与新代码和iter 21候选一致。相邻同步角度更新中：

| 变化 | 旧G变化(deg) | 本批G变化(deg) |
|---|---:|---:|
| +8→+12 | -0.0344 | -0.0008 |
| +40→+44 | -0.0352 | -0.0156 |
| +44→+40 | +0.0352 | +0.0156 |
| +12→+8 | +0.0344 | +0.0008 |

例如第三窗13.150s的+40→+44，总目标变化-0.0161deg，其中G=-0.0156、Fly_Gain=-0.0005，速度偏置当次未变。说明已减少原分档制造的目标跳变；内环D还受实际姿态/角速度和速度偏置更新影响，不能由G下降比例推导D或车体摆动同样比例下降。

### 余速及延迟响应

速度取原始now_speed0，单位仍为编码器计数/控制周期三点平均，不是rpm。第一窗最后尾段不足10s，用单独短窗描述；正常对比以最后两窗为主。

| 尾号 | 持舵速度绝对值均值 | 回中后0～10s | 回中后10～18s | 全窗末5s |
|---|---:|---:|---:|---:|
| 022722 | 15.340 / 15.441（两段） | 不足10s；全7.223s为7.035 | 无记录 | 4.779 |
| 022855 | 10.557 | 12.229 | 11.720 | 13.371 |
| 023028 | 19.135 | 6.355 | 13.117 | 13.904 |

上述后两窗末5s速度均为负，并非正负抵消造成均值。第二窗回中后11.045s记录到-30，第三窗回中后13.251s记录到-24.333。第三窗前10s速度绝对值均值6.355，到后8s增为13.117，约翻倍；roll标准差也由0.0404增至0.0781deg。新曲线没有消除回中后的延迟加速。

第二窗尾段roll-zero最大+0.3972deg，第三窗最大+0.2111deg；未关闭平衡或发生STM32速度指令限幅。第二窗尾段D绝对峰值1.8705，不能宣称新曲线已经普遍降低D峰。持舵时间长达46/52s，仍存在负向余速，末10s速度绝对值均值10.976/17.829，不能把固定+48的补偿视为已最终标定。

与旧053426仅比较回中后共同0～18s：速度绝对值均值旧13.428，新12.003/9.389；roll std旧0.0759，新0.0761/0.0615deg。但zero、持舵时长、起始速度/积分状态及第二窗指令+49不同，因此这些是描述性数字，不把它们换算成“曲线带来百分之几恢复提升”。旧窗前10s为4.758，新窗为12.229/6.355，后段排序又不同，更不能只选有利时间段。

### 慢响应诊断推进

1. 回中后软件servo_ctl和G都为0，余速仍持续；舵机持续非零补偿不是尾段直接输入。机械舵角没有反馈，不能据此断言机械回中绝无偏差。
2. 第三窗605个同步速度环样本反推积分全部为-200，浮点范围约[-200.000589,-199.999706]；包括整个打舵、持舵和回中尾段。因而该窗延迟加速不是积分持续累加或翻转造成的。积分补偿范围是否不足仍是另一假设，不能从贴限直接断言要扩大。
3. 第二窗82.766s的速度偏置为+0.4802deg，其中P=+0.4640、I=+0.0162；第三窗85.871s为+0.4002，其中P=+0.3840、I=+0.0162。慢变目标仍主要由速度P反馈驱动。三窗1798对连续同步积分递推的最大误差小于0.00059，支持当前公式及±200状态限幅的反推。
4. 后两窗末5s的平均set_speed0为-1.3357/-1.3680，反馈均值-13.371/-13.904（两者单位不同）。持续负转伴随持续同向速度命令，不能简单归因于大惯量滑行，也没有电流实测支持驱动能力不足结论。下一阶段应研究产生这些持续命令的速度补偿与姿态闭环、慢偏置/初态，而非只继续改舵机系数。
5. 历史iter 14已比较fw_kp=-0.160/-0.165/-0.155，邻近档没有重复优势；iter 15已有零舵位静置慢漂移与积分贴限记录，但zero/条件不同。保留这些历史证据，不重新从“只要降低或提高P就能解决”开始扫描，也不重启全局sgain上探。

时长加权敏感性复核：后两窗回中后0～18s速度绝对值均值为12.003/9.324，与原样本12.003/9.389一致。迟发余速是数据中可重复观察到的现象，缺口不是主要解释。

### 决策与下一步

verdict: **连续曲线暂留为已验证减少目标跳变的实验实现，整体恢复性能尚未验证改善。** 本批继续维持平衡，但余速恢复目标未达成；因前后zero和动作条件不同，尚无充分依据把慢响应的变化归因于新曲线并判定必须回滚。当前不修改PID、sgain、积分限幅或源码，不宣称适用于全角度比赛运行。

next: 固定当前新曲线、av=1.10/0/1.115、an=-7.30/0/-1.20、fw=-0.160/-0.081/0、sgain=0.0050及zero=-1.35，做两条有明确区分用途的120s记录：

- A：servo_ctl=0，全程静置，不转舵、不加TEST，用于观察当前条件下没有转舵也会出现多大的慢漂移。这补充的是新参数/零点条件下的长零位对照，不否认历史静置记录已有慢漂移证据。
- B：0→+48→0，不加TEST；约10s开始打角，约35s开始回中，争取45s前显示回到0，然后一直保持到120s。这样即使手动动作耗时不同，也能保留至少约75s尾段。比较A同时间段与B回中后10～30/30～60s的速度绝对值、姿态变化和积分状态，区分本底慢漂移与转舵引起的额外响应。

两条使用同一场地/朝向与同一零点，不为每窗另找中值。先保持遥控连接正常；若再发生掉线注明时刻，分段处理。该阶段不重复原样短尾动态基线，不再安排一轮大范围PID/sgain扫描，也不因积分贴限自动实施旧±400候选。

本轮仅追加本记录，保留所有控制源码及既有未提交改动；没有操作硬件。详细重算保存在`/private/tmp/bike_servo_retest_20261014/`，长期证据以原CSV及本记录为准。

---

## iter 23  2026-10-14  focus: 实际av_kp=1.20的两窗长尾转舵记录，静置对照仍缺

change: 按用户要求只评价最后两条`logs/telem_20261014_030257.csv`和`telem_20261014_030519.csv`。用户确认同一场地/朝向，无扶车、额外扰动或遥控异常；核对发现av_kp=1.20时，用户答复“我没注意到这个”。因此保留为实际1.20条件下的有效观察，不标成计划中的1.10试验，也不将意外参数变化视为已确认的调参决策。

### 条件和完整性

两窗均有0→+48→0动作，没有全程零位静置窗。实际参数全窗固定：av=1.20/0/1.115，an=-7.30/0/-1.20，fw=-0.160/-0.081/0，zero=-1.355；按新曲线反推sgain=0.0050，公式残差小于3.7e-8deg。相对上一批同时改变了av_kp（1.10→1.20）和zero（-1.35→-1.355），不能作为单变量比较。

| 日志尾号 | 总时长(s) | 打角区间(s) | +48保持(s) | 回中区间(s) | 回中后记录(s) |
|---|---:|---|---:|---|---:|
| 030257 | 120.036 | 12.190～16.792 | 36.361 | 53.153～58.365 | 61.671 |
| 030519 | 121.322 | 18.558～28.002 | 43.369 | 71.371～77.293 | 44.029 |

第一窗23998帧、序号连续；第二窗24122帧、缺133帧（0.548%），缺口全部在开头1.316s以内，之后及完整动作/尾段连续。真实环频约399.83Hz。flags始终1：平衡开启、后轮关闭、无TEST或STM32速度指令饱和。IMU CRC累计为22且全程不变，**本窗新增0**，不能误写成累计0或把这22次归因于当前动作。

### 长尾已经补齐，仍存在晚期正反转

速度单位为TIM8计数/控制周期三点平均，不是rpm；以下为原始now_speed0的绝对值均值。

| 分段 | 030257 | 030519 |
|---|---:|---:|
| 打角前零位段 | 8.471 | 8.806 |
| +48保持 | 11.792 | 10.136 |
| 回中后0～10s | 4.674 | 4.857 |
| 回中后10～30s | 7.761 | 4.191 |
| 回中后30～40s | 6.300 | 11.981 |
| 共同回中后0～43s | 6.326 | 6.200 |
| 各窗最后10s | 6.443 | 7.918 |

- 030257回中后24.881s达到+21，31.844s反向到-20.333；30～60s平均绝对速度仍5.257，最后10s为持续负转。不是回中后单调衰减。
- 030519回中后31.234s达到+22.667，38.132s反向到-21.333；10～30s看起来较好，30～40s平均绝对速度却增至其约2.86倍。上一批18～19s尾段不足以覆盖这种晚期波动。
- 两窗回中后完整尾段速度均值仅-1.973/-1.538，但绝对值均值为5.965/6.218，接近零的均值部分来自正负抵消，不代表稳定低速。
- 共同0～43s的roll std为0.0619/0.0613deg，回中后相对zero的最大绝对角偏离约0.2185/0.2174deg。两窗都保持平衡，未出现保护关闭；但零速恢复目标未达成。这些数据不支持声称必然发散或已辨识出固定频率极限环。
- 各窗最后10s仍有平均速度命令-0.6237/-0.6778；余速仍伴随非零控制命令，不能单独用大惯量被动滑行解释。

### 1.20与上批的比较边界

统一取回中后0～18s，上一批1.10两窗速度绝对值均值12.003/9.389，本批为5.926/4.896；姿态std由0.0761/0.0615变为0.0582/0.0430deg。存在早期拖尾减小的观测线索，不能忽略，但不能据此确定1.20更优。

同时，打角前零位段速度绝对值均值从上一批4.962/4.690变为本批8.471/8.806，roll std从0.0334/0.0426变为0.0756/0.0694deg。本批动作前速度已分别覆盖-16.333～+25.333、-22.667～+17.333。前段持续12/18s、初态和零点不同，既不能把它严格定性为1.20造成的静置退化，也不能把回中后全部摆动视为舵机新产生的扰动。该前段还不足以排除前次操作残余，不能替代计划中的120s全静置对照。

打角历时4.602/9.444s，保持和回中时长也不同。旧1.10记录没有同样长的回中尾段，所以不能给两档参数进行完整恢复时间排序。

### 控制分项复核

当前源码仍为速度P加积分限幅±200，每60控制周期更新；新正向补偿曲线不含动态状态。回中后servo_ctl及G始终为0。

本批速度积分能释放并反向，区别于上批第三窗全程贴-200：回中完整尾段贴下限占比33.1%/34.1%，贴上限1.7%/4.4%。两窗1600对同步更新的积分递推最大误差小于0.00050，与当前公式吻合；“速度积分一直不释放”不能解释所有慢响应。

在030257的83.291s，速度偏置-0.308212deg，其中P=-0.304000、I=-0.004212（积分状态约+52）；030519的108.497s为-0.337701，其中P=-0.336000、I=-0.001701（积分状态约+21）。较大速度目标偏置发生时积分可以远离限幅，继续支持优先分析速度反馈与姿态闭环的慢响应，而不是仅凭过去贴限就扩大积分范围。P项占比本身也不是减小fw_kp的充分依据。

历史fw_kp邻近档试验无重复优势，当前不重新进行增益扫描；没有电流遥测或ODrive内部闭环误差数据，也不能把这次结果归因于驱动电流能力不足。

### 决策：只补一条与现有动态记录配对的静置窗

verdict: **两条长尾记录有效，保留连续舵机曲线；av_kp=1.20只作为本批实际试验条件，不升级为最终推荐参数。** 本次已不缺长尾转舵数据，不再要求原样重复转舵。当前缺的是同一参数/零点条件下、没有转舵的长时间记录，原计划的静置/转舵区分尚未完成。

next: 为利用已有两条动态记录，下一条暂时固定本批实测参数av=1.20/0/1.115、an=-7.30/0/-1.20、fw=-0.160/-0.081/0、sgain=0.0050、zero=-1.355；**只采一窗120s，全程servo_ctl=0，不转舵、不加TEST、不在窗口内调参或零点**。这是为配对对照固定已测条件，不是正式采用1.20。同场地/朝向、遥控连接正常，若有扶车或掉线需注明。后续按相同时间跨度比较静置与转舵尾段的速度绝对值、正反幅值、姿态波动和积分状态，再决定回到1.10或进一步诊断的具体方向。

该安排不要求重新寻找跨地面的固定angular_zero，不叠加新PID/sgain/限幅修改，也不把未完成的静置窗描述成已有结论。本轮只追加记录，控制源码、AGENTS.md及已有UI/协议/测试改动均保留；没有烧录或操作硬件。重算中间结果位于`/private/tmp/bike_long_tail_20261014/`，长期依据为原CSV和本记录。

---

## iter 24  2026-10-15  focus: 120s零舵位静置基线，采集前零点重新调整

change: 新增`logs/telem_20261015_030351.csv`及对应summary。用户确认场地和摆放位置不变；进一步确认每次采集前都会调整零点，使飞轮运动尽量平缓。本窗全程不再改变参数。采集前已经回中静置多久未提供。本轮接受“每次测试前适应当前状态调零”的操作方式，不要求跨日保持旧零点。

### 条件与数据质量

- 原始CSV共23949帧，车上时间跨度120.026s，按loop_cnt/t_ms计算控制频率399.830Hz。全窗servo_ctl=0、servo_zhongzhi_gain=0、flags=1：平衡开启，后轮关闭，遥控模式，无TEST、重立或STM32指令饱和。IMU CRC累计0、本窗新增0。
- 序号缺少47个遥测帧，约0.196%；六处缺口集中于15.932～16.137s和37.496～37.576s，最大相邻帧时间间隔170ms。summary中的`dropped_loops_est=94`是未观测到的控制序号数，不能据此断言控制中断执行丢失。38s以后连续；下面80～120s比较三窗均为7996帧，没有插值。
- 实测PID与iter23相同：av=1.20/0/1.115，an=-7.30/0/-1.20，fw=-0.160/-0.081/0。angular_zero为**-1.295**，上次为-1.355，相差+0.060deg，采集内不变。
- **sgain未在遥测字段中直接记录，全程零舵位时无法反推其数值，也不能用此窗确认非零打角补偿曲线。** 零舵位补偿为0，当前静置指标不依赖sgain；下一轮转舵前须核对0.0050。不能将PID一致误写为所有调节项均已核验一致。
- 继续使用CSV原始`now_speed0`，单位为TIM8计数/控制周期三点平均，不是rpm或turn/s；`set_speed0`才是ODrive速度指令turn/s。桥接脚本summary的`speed_loop.now_speed0`实际统计set_speed0，本轮不采用该字段作反馈。

### 当前静置表现：姿态稳定，仍有小幅正反转

全窗原始反馈均值+0.247，绝对值均值2.456，最小-9.000、最大+8.333；roll标准差0.03060deg，相对本窗零点的平均偏差-0.00364deg、最大绝对偏差0.11186deg。排除开始10s后，平均绝对速度2.373、roll标准差0.03057deg，结论不依赖最初几秒。

| 本窗分段 | 平均速度 | 平均绝对速度 | 速度范围 | roll标准差(deg) |
|---|---:|---:|---|---:|
| 10～120s | +0.117 | 2.373 | -9.000～+7.667 | 0.03057 |
| 60～120s | +0.326 | 2.656 | -9.000～+7.667 | 0.03076 |
| 最后10s | +1.067 | 2.973 | -6.667～+5.667 | 0.03175 |

40～50s速度均值-2.613，50～60s转为+1.792，70～80s为-2.764，80～90s为+2.047；75.282s仍出现-9的负速度峰。后半段并非持续衰减至零，但观察窗内未出现持续放大的姿态摆动、保护关闭或指令饱和。可以作为当前状态下的有效静置基线，不能称为已完成零速收敛，更不能用接近零的带符号均值掩盖正负抵消。

### 与历史转舵尾段的描述性比较

统一取**各窗开始后的80～120s**，两条旧记录此时均已回中（分别在58.365s、77.293s回中）。这不是相同“距回中时间”的比较，也不是同零点的因果对照。

| 指标 | 本次静置030351 | 旧转舵030257 | 旧转舵030519 |
|---|---:|---:|---:|
| 平均绝对速度 | 2.514 | 6.132 | 5.962 |
| 速度最小/最大 | -6.667 / +7.667 | -20.333 / +21.000 | -21.333 / +22.667 |
| roll标准差(deg) | 0.02972 | 0.05992 | 0.06099 |
| 速度积分贴任一限幅占比 | 0% | 24.6% | 32.5% |

另外按旧030257回中后0～43s对应的采集58.365～101.365s比较，旧/新静置平均绝对速度为6.326/2.819；旧030519回中后可共同覆盖的77.293～120.026s为6.213/2.551。差异具有一致方向，但**零点、开机/初始状态、采集日期和动作历史不同**，不能把差值全部当作转舵额外扰动，也不能据此判定补偿已经修好、1.20优于1.10或电机能力不足。

### 速度环积分复核

当前源码`Velocity_Control(int encoder, int target_encoder)`先将速度反馈截断为整数，每60控制周期更新，`pwm_accel=encoder*fw_kp/10+integral*fw_ki/1000`，积分限幅±200。对loop_cnt模60为0的799个可观测更新点反推积分，范围约**-137～+116**，没有观测到贴限；相邻完整更新的递推验证最大残差0.000156，与当前公式一致。首次完整更新前和跨缺帧区间不用于递推验证；分段积分统计采用已观测更新值保持。

本窗积分项最大绝对贡献约0.01110deg。2s之后速度P项平均绝对贡献0.03309deg，积分项0.00436deg。总角度目标满足zero+pwm_accel+fly_gain，静置全窗最大残差1.17e-7deg。说明本窗慢波动发生时速度积分不需要碰到限幅，**本轮没有扩大积分限幅或修改fw_ki的依据**。P项较大本身也不足以支持重启fw_kp扫描。

### 决策与下一项

verdict: 保留当前控制代码与本窗PID作为下一次观察条件；不据此宣布1.20为最终最优，也不要求把zero调回-1.355。当前静置数据有效，但原计划的严格静置/转舵配对因采集前重新调零而未完成。下一轮把配对放进同一条记录，以适应用户每次记录前调零的实际流程。

next: **仅采一条180s，先静置、再转舵、最后回中**。采集前允许按当前状态调一次零点，核对av=1.20/0/1.115、an=-7.30/0/-1.20、fw=-0.160/-0.081/0及sgain=0.0050；采集中保持参数和零点不变，后轮关闭，不叠加TEST。

- 0～60s：舵机回中，原地平衡，建立同一次记录的静置基线。
- 约60s开始：沿用此前遥控方式打到**原内部servo_ctl=+48**，目标到达后保持约20s。
- 约90s开始回中，争取100s前归零；随后静置到180s，保留至少约80s回中尾段。按CSV实际动作时刻对齐，不把手动计划时刻当精确阶跃。
- 当前屏幕`SERVO~`已显示右正左负的估算轴角，原+48内部单位对应**约-8.4deg（向左）**；USART2新协议中等效线值为-840。遥测servo_ctl仍是内部单位，不能把旧+48直接当作新协议48或实际48度。此次为保持操作路径一致，继续使用遥控方式；若实际档位略有偏差，按原始日志记录处理。
- 若扶车、掉线或中途改参数，记录时刻并分段。用同窗前20～60s基线与回中后10～30/30～60s比较姿态、绝对速度、速度偏置和积分，判断动作后是否重复出现超出本底的慢响应，再决定参数或补偿的下一步。

本轮仅追加分析记录，未修改控制代码、默认参数、原始CSV/summary或操作硬件。中间计算保存在`/private/tmp/bike_static_20261015/`，80～120s主要指标另用标准库独立复算一致，长期依据为本节与原始日志。

---

## iter 25  2026-10-15  focus: 同窗静置—左转—主动快速回中，主要残余出现在固定打角段

change: 新增`telem_20261015_031757.csv`（2.471s、372帧，仅零舵位）与`telem_20261015_031802.csv`（181.328s、36108帧）。前者未覆盖动作，不参与本轮响应比较，不推测短采集原因；以后一条完整记录为依据。用户确认场地正常、无干扰，并进一步确认约103.8s的快速回中是**主动按停止/回中键**，不是遥控掉线。

### 参数、动作与数据质量

- 完整窗PID及zero均不变：av=1.20/0/1.115，an=-7.30/0/-1.20，fw=-0.160/-0.081/0，zero=-1.295。与iter24一致。本次同窗比较不再受“两窗之间重新调零”的直接混淆。
- 非零舵位按当前连续曲线反推sgain，范围0.0049999988～0.00499999995，即0.0050；全窗补偿公式最大残差6.28e-8deg。角度环同步帧的目标分项之和最大残差1.52e-7deg，确认连续正向曲线实际生效。
- 全窗flags=1，平衡开启、后轮关闭、遥控模式，无TEST、重立或STM32速度指令饱和；IMU CRC累计/新增0。控制序号/车上时间对应399.828Hz。
- 共缺143个遥测帧，约0.394%；主要在前1.306s，另有130.616～130.641s及156.897～156.957s的短缺口，最大相邻记录间隔56ms。转舵和快速回中区间连续。缺帧不等于证实控制ISR停顿；以下为原始有效样本统计，未用插值恢复未知峰值。

| 阶段 | 实际采集时间(s) | 舵机内部量/物理估计 |
|---|---|---|
| 零位基线 | 0～66.664 | 0 |
| 逐次按键打角及微调 | 66.664～76.093 | 0→49→53→49 |
| 固定保持 | 76.093～103.800 | +49，估算向左8.575°，屏幕约-8.6° |
| 主动K回中 | 103.800～104.280 | +49→0，约0.480s |
| 回中后尾段 | 104.280～181.328 | 0，持续77.048s |

实际主要档位为+49，短暂到过+53，不能写成精确+48实验。+49处G=-0.088700deg，+53处G=-0.097900deg。K回中轨迹每约10ms减少1内部单位，符合现有回中流程；这比此前数秒的手动回中快，不能用本次结果宣称所有转舵速率或比赛行驶条件均已验证。

### 同一零点下的分段结果

速度取CSV原始now_speed0，单位为编码器计数/控制周期三点平均；不是ODrive指令turn/s，更不是rpm。均值与平均绝对值分开报告。

| 分段 | 平均速度 | 平均绝对速度 | 速度最小/最大 | roll标准差(deg) |
|---|---:|---:|---|---:|
| 转舵前20～60s | +1.236 | 2.624 | -6.000 / +9.000 | 0.03312 |
| +49保持全段 | -8.903 | 8.903 | -22.333 / -1.000 | 0.04942 |
| +49保持末20s | -7.473 | 7.473 | -17.000 / -1.000 | 0.04005 |
| 回中后0～10s | +3.528 | 3.868 | -6.333 / +8.000 | 0.03071 |
| 回中后10～30s | +0.890 | 2.107 | -5.000 / +6.000 | 0.02795 |
| 回中后30～60s | +0.615 | 2.299 | -5.667 / +6.667 | 0.02896 |
| 回中后60～77s | -0.483 | 2.575 | -7.333 / +7.000 | 0.03370 |

- **本窗回中后的长期指标已回到自身静置量级。** 基线最后40s另算平均绝对速度2.418、roll std 0.03271deg，结论同样成立。回中后5～10s仍有一次正向回摆，5秒段平均绝对速度5.356；10s以后的各5秒段为1.432～2.891，落在本窗静置5秒段0.738～4.504的波动量级。这里是分段观测，不是宣称严格“10秒整定时间”或飞轮不再转动。
- **固定左转仍有明确持续负向余速。** +49保持时全部已记录速度为负；末20s仍平均-7.473，约为基线平均绝对速度的2.85倍。长期速度指令同时约-0.732 turn/s，故不能仅解释为大飞轮被动滑行。保持阶段姿态仍维持平衡，但波动比零位更大。
- 回中完整77.048s的速度均值+0.823、平均绝对值2.513、roll std 0.03078deg。最后20s平均绝对速度2.633、roll std 0.03223deg，没有复现旧窗晚期约±20量级的反转；仍有本底小幅慢摆。
- 相对转舵前平均roll=-1.31918deg，打角/微调段最大偏离0.13384deg，保持段0.19236deg，回中后前10s为0.14658deg。均未触发保护，但只代表本窗、当前原地姿态与动作。

### 积分与补偿的解释边界

按当前源码每60周期更新、encoder参数向零截断反推1204个可观测速度环积分状态；1200对相邻完整更新的递推最大误差0.000396。基线20～60s积分贴+200约41.4%，但速度幅度仍较小；+49保持贴-200约99.7%，末20s为100%；回中后约0.860s开始离开-200，之后能向正值变化。回中后30～60s再次贴+200约34.4%，而平均绝对速度仍2.299。

这说明积分贴限不等同于回中失效，也不支持仅凭贴限扩大积分范围。+49保持末20s速度P平均+0.11532deg、I平均+0.01620deg、舵机G=-0.08870deg、fly_gain约-0.00373deg；存在速度反馈与姿态/舵机补偿的共同作用。分项代数不能单独证明机械偏置由哪一项造成，也不能把P项较大直接当作修改fw_kp的依据。

结合iter17/18在+48的结果，减少负补偿幅值曾伴随持续负转减小；本次又在同一零点下显示问题主要出现在固定打角段，支持把下一项验证限定到该位置的补偿。此前0.0058仅一窗、存在缺帧和后段正转，不能直接采用为最终值。本次没有电流遥测，不据此判断ODrive电流/转矩余量。

### 决策与下一项局部对照

verdict: 保留连续曲线及当前PID；**本次主动K回中长尾通过了“恢复至同窗静置量级”的观察检查，固定左转的持续负转仍需处理。** 不再原样重复静置—转舵基线，也不重启av_kp/fw_kp扫描或扩大积分限幅；1.20仍是当前工作条件，不宣称全局最优。

next: 使用现有菜单参数做一次**固定左转档位的sgain A→B→A对照**，只检验一个候选：0.0050→0.0054→0.0050。0.0054是在已测0.0050与探索0.0058之间的小步候选，不是由本窗拟合出的精确零速值；在+49处把G由-0.0887改为-0.0691deg（目标分项+0.0196deg）。该参数影响全方向，本次仅限定内部约+49的左转位置，不作为全角度通用值。

操作：采集前在回中状态按当前条件调零一次，核对当前PID并设置sgain=0.0050；再打到固定左转约-8.6°（内部+49，尽量沿用同一档位），稳定菜单和舵机后开始一条180s记录。0～60s保留0.0050；约60s只改sgain为0.0054（当前菜单步长0.0001，共四格）；约120s改回0.0050，记录到180s。本窗有意允许且仅允许sgain两次变化，其余PID、zero、实际舵位保持不变，后轮关闭、不加TEST。按日志反推的实际sgain变化时刻分段，不要求手动秒点完全精确。

评价各稳定档最后约30s的平均绝对速度、带符号速度、姿态std、D波动及积分状态。只有B相对两侧A都减轻余速、没有转为同等或更大的持续正转、姿态没有恶化，才保留为该左转位置的候选；否则留0.0050并停止继续上探。若存在逐段时间漂移，保留不确定性。该安排是在同一采集中验证局部补偿效应，避免每次重新调零混淆参数比较；后续若确认收益，再讨论仅正向曲线的实现，不现在改全局默认值。

本轮只追加分析记录；原始CSV/summary、控制代码、默认参数及既有父目录协议改动均保留。中间计算在`/private/tmp/bike_motion_20261015/`；表中主要速度与姿态指标另用标准库重新读取原CSV独立核验一致。没有烧录或操作硬件。

---

## iter 26  2026-10-15  focus: 固定左转sgain A→B→A，0.0054有局部收益但尚未通过最终保留条件

change: 用户确认最近一条是正确完成要求的采集，场地不变、没有干扰。本轮仅分析最新`logs/telem_20261015_034014.csv`，此前`033548`不参与有效对照。没有修改固件或默认参数。

### 实际参数、分段与数据质量

- 原始CSV共35922帧，跨度181.437s；全程servo_ctl=+49，估算轴角向左8.575°，屏幕约-8.6°。这是固定舵位试验，没有转舵或回中动作，也没有TEST。
- PID和零点全程不变：av=1.20/0/1.115，an=-7.30/0/-1.20，fw=-0.160/-0.081/0，zero=-1.295。flags始终为1：平衡开启、后轮关闭、遥控模式，无重立、TEST或STM32速度指令饱和；IMU CRC累计和新增均为0。
- sgain没有直接遥测字段，但按当前正向连续曲线、固定+49及实测G可以反推。此处曲线偏置为-0.3337deg，G=49×sgain-0.3337；两档G分别为-0.088700与-0.069100deg，实际目标分项变化+0.019600deg。
- 车上时间与控制序号对应399.830Hz；共缺351个遥测帧，约0.968%，50处序号缺口，最大相邻帧间隔155ms。B整段连续；主要末30s窗口A1/B/A2分别缺17/0/46帧。summary估计的702个未观测控制序号不能当作已证明控制ISR漏执行。

| 稳定档 | 实际时间(s) | 反推sgain | 持续时间(s) |
|---|---|---:|---:|
| A1 | 0～55.669 | 0.0050 | 55.669 |
| B | 56.754～104.069 | 0.0054 | 47.315 |
| A2 | 105.120～181.437 | 0.0050 | 76.317 |

中间各约1s为逐格调整，四格步长均约0.0001，排除在稳定档比较之外。实际切换点与计划60/120s不同，但各段均足以覆盖预定末30s评价；按真实切换时刻分析。

### 主要结果：两侧A均比B有更大的负向余速

采用iter25预先指定的各稳定档最后30s：A1为25.669～55.669s，B为74.069～104.069s，A2为151.437～181.437s。速度取原始now_speed0，单位仍是编码器计数/控制周期三点平均，不是rpm或turn/s；不使用summary中误标为反馈的速度指令统计。

| 指标 | A1：0.0050 | B：0.0054 | A2：0.0050 |
|---|---:|---:|---:|
| 平均速度 | -8.173 | -2.404 | -5.947 |
| 平均绝对速度 | 8.173 | 2.883 | 5.947 |
| 速度最小/最大 | -17.333 / -2.000 | -8.667 / +3.667 | -19.333 / +0.333 |
| roll标准差(deg) | 0.04230 | 0.03453 | 0.03941 |
| D项逐帧差分标准差 | 0.25401 | 0.26179 | 0.25074 |
| 速度积分贴-200占比 | 100% | 74.19% | 100% |

- B平均绝对速度相对两侧A分别下降64.7%和51.5%，roll标准差下降18.4%和12.4%。改回0.0050后持续负转重新加重，支持0.0054在这个左转档位存在局部改善作用。
- B仍以负转为主，末30s约85.3%的样本为负；末10s均值-2.668、绝对值均值2.679。不能称为已经零速收敛或找到了最优补偿，也没有观测到同等量级的持续正转替代原负转。
- D差分抖动相对A1/A2增加约3.1%/4.4%，D项平均绝对值也由0.1010/0.0995变为0.1049。D差分只使用相邻序号增量为2的连续遥测帧，排除了跨缺口差分。这是约200Hz遥测尺度的指标，不代表完整400Hz控制输出频谱。
- 两侧A本身不一致，说明仍有状态或时间漂移；单次A→B→A不能消除全部混淆，也不能由大量相邻样本推导独立重复试验的统计置信度。

### 取窗与控制分项复核

进一步对齐各稳定档开始后的17～47s，A1/B/A2平均绝对速度为7.410/2.857/8.155，roll标准差0.04319/0.03459/0.04892deg，改善方向相同。该窗口B的D抖动相对两侧A高约6.0%/5.4%；因此不能把主窗口的D略增简单归因于A2窗口较晚。各档末20s平均绝对速度8.876/2.866/6.079，亦支持相同方向。

主窗口按实际时间间隔作梯形加权的平均绝对速度为8.165/2.883/5.917，与原始样本均值接近，缺口没有改变平均指标判断；这项敏感性检查不能恢复缺失时刻的真实峰值。

当前速度环每60控制周期更新，输入先向零截断成整数，P=encoder×fw_kp/10，I=integral×fw_ki/1000，积分限幅±200。反推1193个可观测更新点，1183对完整相邻更新递推最大残差0.000332，与源码一致。主窗口B积分状态约-200～-153，仍有74.19%贴下限；P平均贡献从A1/A2的+0.12419/+0.08961deg降至+0.03415deg，I平均贡献从+0.01620降至+0.01573deg。

本次收益主要伴随所需速度反馈偏置减小，但不能仅凭代数分项确定全部机械原因。积分尚未完全释放不是扩大积分范围的依据；没有ODrive电流遥测，也不能由无STM32指令饱和推断电流或转矩余量。角度环同步帧的目标分项和最大残差1.73e-7deg，补偿变化与当前控制逻辑一致。

### 决策与下一项

verdict: **0.0054保留为固定左转+49的局部动态复测候选，尚不作正式keep。** 静态余速和姿态指标明显改善，但TUNING_PLAYBOOK要求D抖动/饱和不恶化，本次D指标略增，不能宣称完整验收通过。当前记录已恢复0.0050；代码、默认值、PID和积分限幅保持原状。不继续向上扫描sgain，也不把这个点推广为全角度补偿。

next: 只采一条180s的**0.0054静置—左转—主动K回中**记录，检验实际动作及长尾是否保留静态收益，并继续检查D项。

- 采集前在回中状态按当前实际情况调零一次，菜单设置sgain=0.0054；PID保持本窗值。记录内不再改零点、PID或sgain，后轮关闭，不加TEST。
- 0～60s回中静置，形成同窗基线；约60s按上次方式打到屏幕约-8.6°、内部+49，目标到达后保持约20～30s。
- 约95～100s主动按K/回中键，沿用iter25已确认的快速回中方式；回中后不再操作，记录至180s，保留约80s尾段。按实际舵位轨迹对齐，不把操作计划秒点当作精确阶跃。
- 比较同窗基线20～60s、固定打角末段、回中后10～30/30～60s及最后尾段的绝对速度、姿态波动、D抖动和积分状态。与旧0.0050动态记录仅在条件可比范围内作辅助对照；若重新调零，不把跨窗差值全部归因于sgain。
- 新档若出现持续增大的摆动或明显持续高速，结束该档测试并恢复0.0050，注明操作时刻，不为凑足时长继续。若D恶化重复出现，不能仅凭平均余速下降定版；本轮不同时修改av_kd来掩盖此项。

全局sgain会影响两侧舵位，本次只允许局部检验该左转位置，右转及其他角度尚未验证。后续是否把收益落在正向曲线，须依据动作结果再决定。

本轮仅追加本节，保留既有日志内容、原始CSV/summary及其他工作区改动。计算文件在`/private/tmp/bike_sgain_20261015/`；主要与对齐窗口的速度、姿态指标已用标准库独立重读原CSV复算一致。没有修改固件、烧录或操作硬件。

---
