Jupiterust/autoBike/bike_code/Fly_Dreams.ioc

Mcu.UserName=STM32F427IIHx
PA0/WKUP.GPIO_Label=SERVO
PA0/WKUP.Signal=S_TIM2_CH1_ETR
PA13.Signal=SYS_JTMS-SWDIO
PA14.Signal=SYS_JTCK-SWCLK
PB12.Signal=CAN2_RX
PB13.Signal=CAN2_TX
PB2/BOOT1.GPIO_Label=KEY
PB2/BOOT1.Signal=GPIO_Input
PD5.Signal=USART2_TX
PD6.Signal=USART2_RX
PD8.Signal=USART3_TX
PD9.Signal=USART3_RX
PE0.Signal=UART8_RX
PE1.Signal=UART8_TX
PE11.GPIO_Label=LED_R
PE11.Signal=GPIO_Output
PE7.Signal=UART7_RX
PE8.Signal=UART7_TX
PF14.GPIO_Label=LED_G
PF14.Signal=GPIO_Output
PG14.Signal=USART6_TX
PG9.Signal=USART6_RX
PH0/OSC_IN.Signal=RCC_OSC_IN
PH1/OSC_OUT.Signal=RCC_OSC_OUT
PH6.GPIO_Label=BEEP
PH6.Signal=S_TIM12_CH1
PI5.Signal=S_TIM8_CH1
PI6.Signal=S_TIM8_CH2
