Jupiterust/autoBike/bike_code/Core/Inc/main.h

#define KEY_Pin GPIO_PIN_2
#define KEY_GPIO_Port GPIOB
#define BEEP_Pin GPIO_PIN_6
#define BEEP_GPIO_Port GPIOH
#define SERVO_Pin GPIO_PIN_0
#define SERVO_GPIO_Port GPIOA
#define LED_R_Pin GPIO_PIN_11
#define LED_R_GPIO_Port GPIOE
#define LED_G_Pin GPIO_PIN_14
#define LED_G_GPIO_Port GPIOF
