Jupiterust/autoBike/bike_code/USER/tft/tft_font.h

/*
 * tft_font.h - ASCII glyph tables, from the LQ SGP18T reference driver.
 *
 * kFont6x8  : 6x8,  COLUMN major - one byte per column, bit j = row j (bit0 top)
 * kFont8x16 : 8x16, ROW major    - one byte per row,    bit i = column i (bit0 left)
 *
 * The two tables use different layouts.  That is how the original font came;
 * it is not a porting mistake.  Render them separately or one of them turns
 * into garbage.
 *
 * First character is space (0x20); index as table[ch - 32].
 * The original file was GB2312 and carried a demo-only CJK table; only the
 * ASCII tables are kept here, and this file is plain ASCII so it survives the
 * project's -finput-charset=GBK.
 */

#ifndef __TFT_FONT_H
#define __TFT_FONT_H

#include <stdint.h>

static const uint8_t kFont6x8[][6] = {
  {0x00,0x00,0x00,0x00,0x00,0x00},// (0)
  {0x00,0x00,0x00,0x4F,0x00,0x00},//!(1)
  {0x00,0x00,0x07,0x00,0x07,0x00},//"(2)
  {0x00,0x14,0x7F,0x14,0x7F,0x14},//#(3)
  {0x00,0x24,0x2A,0x7F,0x2A,0x12},//$(4)
  {0x00,0x23,0x13,0x08,0x64,0x62},//%(5)
  {0x00,0x36,0x49,0x55,0x22,0x50},//&(6)
  {0x00,0x00,0x05,0x03,0x00,0x00},//'(7)
  {0x00,0x00,0x1C,0x22,0x41,0x00},//((8)
  {0x00,0x00,0x41,0x22,0x1C,0x00},//)(9)
  {0x00,0x14,0x08,0x3E,0x08,0x14},//*(10)
  {0x00,0x08,0x08,0x3E,0x08,0x08},//+(11)
  {0x00,0x00,0x50,0x30,0x00,0x00},//,(12)
  {0x00,0x08,0x08,0x08,0x08,0x08},//-(13)
  {0x00,0x00,0x60,0x60,0x00,0x00},//.(14)
  {0x00,0x20,0x10,0x08,0x04,0x02},///(15)
  {0x00,0x3E,0x51,0x49,0x45,0x3E},//0(16)
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
  {0x00,0x00,0x00,0x00,0x00,0x00,0xFE,0x00,0x00,0xFE,0x00,0x00,0x00,0x00,0x00,0x00},//=(29)
  {0x00,0x00,0x00,0x02,0x0C,0x10,0x60,0x80,0x60,0x10,0x0C,0x02,0x00,0x00,0x00,0x00},//>(30)
  {0x00,0x00,0x38,0x44,0x82,0x82,0x40,0x20,0x10,0x10,0x10,0x00,0x10,0x10,0x00,0x00},//?(31)
  {0x00,0x00,0x38,0x44,0x82,0xB2,0xAA,0xAA,0xAA,0xAA,0xD2,0x02,0x84,0x78,0x00,0x00},//@(32)
  {0x00,0x00,0x10,0x10,0x10,0x28,0x28,0x28,0x44,0x44,0x7C,0x82,0x82,0x82,0x00,0x00},//A(33)
  {0x00,0x00,0x3E,0x42,0x82,0x82,0x42,0x3E,0x42,0x82,0x82,0x82,0x42,0x3E,0x00,0x00},
  {0x00,0x00,0x38,0x44,0x82,0x82,0x02,0x02,0x02,0x02,0x82,0x82,0x44,0x38,0x00,0x00},
  {0x00,0x00,0x3E,0x42,0x42,0x82,0x82,0x82,0x82,0x82,0x82,0x42,0x42,0x3E,0x00,0x00},
  {0x00,0x00,0xFE,0x02,0x02,0x02,0x02,0x7E,0x02,0x02,0x02,0x02,0x02,0xFE,0x00,0x00},
  {0x00,0x00,0xFE,0x02,0x02,0x02,0x02,0x7E,0x02,0x02,0x02,0x02,0x02,0x02,0x00,0x00},
  {0x00,0x00,0x38,0x44,0x82,0x02,0x02,0x02,0xE2,0x82,0x82,0x82,0xC4,0xB8,0x00,0x00},
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
};

#endif /* __TFT_FONT_H */
