Jupiterust/autoBike/bike_code/USER/oled/oled.h

/**
 ***************************************(C) COPYRIGHT 2018 DJI***************************************
 * @file       oled.h
 * @brief      this file contains sd card basic operating function
 * @note         
 * @Version    V1.0.0
 * @Date       Jan-28-2018      
 ***************************************(C) COPYRIGHT 2018 DJI***************************************
 */

#ifndef __OLED__H
#define __OLED__H

#include "stm32f4xx.h"
#include "disp_port.h"      /* shared SPI1 transport, see USER/disp/ */
#include <stdint.h>

#define Max_Column      128
#define Max_Row         64

#define X_WIDTH         128
#define Y_WIDTH         64

#define OLED_CMD        0x00
#define OLED_DATA       0x01

/* SH1106 has 132 columns of RAM but only 128 are visible, centred, so the
 * visible window starts at column 2.  If the panel turns out to be a 128-column
 * controller (SSD1306) the image will sit 2 px right instead - set this to 0. */
#define OLED_COL_OFFSET 2

#define CHAR_SIZE_WIDTH     6
#define VHAR_SIZE_HIGHT     12

/* DC is owned by disp_port (one cache, one BSY guard); these stay only so the
 * reference driver body below reads as it originally did. */
#define OLED_CMD_Set()      disp_set_dc(1)
#define OLED_CMD_Clr()      disp_set_dc(0)

#define OLED_RST_Set()      HAL_GPIO_WritePin(DISP_RST_PORT, DISP_RST_PIN, GPIO_PIN_SET)
#define OLED_RST_Clr()      HAL_GPIO_WritePin(DISP_RST_PORT, DISP_RST_PIN, GPIO_PIN_RESET)

typedef enum
{
    Pen_Clear = 0x00,
    Pen_Write = 0x01,
    Pen_Inversion = 0x02,
}Pen_Typedef;

/* function define */
void oled_init(void);
void oled_write_byte(uint8_t dat, uint8_t cmd);
void oled_display_on(void);
void oled_display_off(void);
/* Push only the pages whose content changed since the last call; returns how
 * many of the 8 pages actually went out over SPI.  Call oled_invalidate()
 * after anything that disturbs the panel's RAM behind the driver's back. */
uint8_t oled_refresh_gram(void);
void oled_invalidate(void);
void oled_clear(Pen_Typedef pen);
void oled_drawpoint(int8_t x, int8_t y, Pen_Typedef pen);
void oled_drawline(uint8_t x1, uint8_t y1, uint8_t x2, uint8_t y2, Pen_Typedef pen);
void oled_showchar(uint8_t row, uint8_t col, uint8_t chr);
void oled_shownum(uint8_t row, uint8_t col, uint32_t num, uint8_t mode, uint8_t len);
void oled_showstring(uint8_t row, uint8_t col, uint8_t *chr);
void oled_printf(uint8_t row, uint8_t col, const char *fmt,...);
void oled_LOGO(void);

#endif
