Jupiterust/autoBike/Remote/Hardware/key.h

#ifndef __KEY_H
#define __KEY_H

#include "include.h"

#define KEY0        sys_gpio_pin_get(GPIOB, SYS_GPIO_PIN9)   //左上
#define KEY1        sys_gpio_pin_get(GPIOA, SYS_GPIO_PIN11)  //右上
#define KEY2        sys_gpio_pin_get(GPIOB, SYS_GPIO_PIN8)   //左左
#define KEY3        sys_gpio_pin_get(GPIOB, SYS_GPIO_PIN7)   //左右
#define KEY4        sys_gpio_pin_get(GPIOA, SYS_GPIO_PIN15)  //右左  
#define KEY5        sys_gpio_pin_get(GPIOB, SYS_GPIO_PIN3)   //右右 
#define KEY6        sys_gpio_pin_get(GPIOB, SYS_GPIO_PIN6)   //左下 
#define KEY7        sys_gpio_pin_get(GPIOC, SYS_GPIO_PIN14)  //中左  
#define KEY8       sys_gpio_pin_get(GPIOA, SYS_GPIO_PIN0)    //中右
#define KEY9       sys_gpio_pin_get(GPIOA, SYS_GPIO_PIN12)   //右下

extern uint8_t Tx_Buf[14];
typedef enum{
    key_release,
    key_press,
    key_wait,
}key_state;

extern uint8_t Key_Flag[8];

uint8_t KEY_Read_All(void);

void Key_Scan(void);
void key_init(void);        /* ????????????? */


#endif
