Jupiterust/autoBike/Remote/Hardware/easy_tran.c

#include "easy_tran.h"
#define EASY_LENGTH  255
char easy_buff[EASY_LENGTH];

//[0,0,0,0,0,0,0,0,0,0,0,0,0,0]//
/*
uint8_t button_value[10],rocker_value[2][2];
for(uint8_t i = 0;i<8;i++)
{
    if(key_flag[i])
    {
      button_value[i] = 1;  
    }
    
}
*/
