Jupiterust/autoBike/Remote/System/delay.h

#ifndef __DELAY_H
#define __DELAY_H

#include "sys.h"


void delay_init(uint16_t sysclk);   /* 初始化延迟函数 */
void delay_ms(uint16_t nms);        /* 延时nms */
void delay_us(uint32_t nus);        /* 延时nus */

#endif
