Jupiterust/autoBike/Remote/System/include.h

#ifndef __include_H
#define __include_H

#include "include.h"
#include "stm32f10x.h"      
#include <string.h>
#include <math.h>
#include <stdio.h>
#include <stdarg.h>
#include <stdint.h>
#include <stdbool.h>
#include <math.h>
#include <stdio.h>
#include <stdarg.h>
#include <stdint.h>
#include <stdlib.h>
#include <cmath> // 引入数学库，以便使用绝对值等函数


#include "sys.h"
#include "usart.h"
#include "delay.h"
#include "timer.h"


#include "adc.h"
#include "dma.h"
#include "spi.h"
#include "stmflash.h"
#include "beep.h"
#include "key.h"
#include "nrf24l01.h"
#include "OLED_Data.h"
#include "OLED.h"
#include "LED.h"


#include "A_blue.h"


#include "easy_tran.h"



#endif
