Jupiterust/autoBike/(commit log)

2025-10-30 自行车以及遥控器初版代码
2025-11-01 添加VOFA文件，便于调参
2025-11-01 改变机械零点和参数，添加调参记录文件夹
2025-11-03 参数大致调好，需要注意上电后需要立马放手。
2025-11-04 改为遥控器启动，修改地方为主循环和串口7接受中断俩处，研究电流环，替代角速度环作为最内环
2025-11-14 遥控器最终版，其中分为简化版和遥控板，尝试加入电流环作为最内环提高响应速度
2025-11-14 添加odrive配置文件夹
2025-11-14 中间缓冲，无修改
2025-12-18 风大的时候需要将角度环的参数调大，角速度环和速度环需要调小，遥控右侧依次为切换是否自动、右转、左转、归中
    [my_odrive_config.json]
2026-09-04 添加生效的 .gitignore，停止跟踪编译中间产物
    原有的 bike.gitignore / remote.gitignore 从未生效：文件名缺少前导点，
    且内部使用了 .gitignore 不支持的行尾注释（`build/ # 说明`），整行连
    注释一起被当作匹配模式。它还误把 stm32f4xx_hal_msp.c 列为忽略项。
    改为仓库根目录一份 .gitignore，并把已被跟踪的 367 个产物移出索引
    （文件保留在磁盘上）：Keil 的 .o/.crf/.d/.sct/.axf/.hex/.map、GCC 的
    build/、JLink 日志、每用户的 .uvguix.* UI 状态、Python 缓存与虚拟环境。
    遥测日志只保留 logs/summary_*.json，逐帧原始 telem_*.csv 忽略。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
2026-09-04 统一行尾：把工作区的 CRLF 固化进仓库
    这 231 个文件的内容一个字节都没变，只是仓库里存的是 LF、工作区是 CRLF，
    导致 git status 长期显示约 200 个"已修改"文件、每个约 2000 行纯噪声，
    真实改动被完全淹没（此前只能靠 git diff --ignore-cr-at-eol 才看得出来）。
    源码本身是在 Keil/Windows 下写的 CRLF，直接固化为 CRLF 与磁盘一致，
    此后 git status 干净、diff 可读。
    [my_odrive_config.json]
2026-09-04 新增 GCC/Make 构建系统，使工程可在 macOS 上编译与烧录
    Keil AC5 只能在 Windows 跑，此前 Mac 上无法构建。补齐 CubeMX 生成的
    Makefile / STM32F427XX_FLASH.ld / startup_stm32f427xx.s 及 syscalls.c、
    sysmem.c，并手工把 CubeMX 不认识的 USER/ 目录加进 C_SOURCES 与 C_INCLUDES。
    要点：
    - 加 -finput-charset=GBK，否则 GBK 注释里以 0x5C 结尾的字节对会被 cpp
    误当成续行符。
    - 三处 AC5 专有写法改为可移植写法：A_include.h 的 <cmath> 用
    __cplusplus 保护；A_Remote.c / A_blue.c 中以 const 变量作文件作用域
    数组长度改为 #define（C 不允许 VLA 尺寸的文件作用域数组）。
    - openocd-ho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
2026-09-04 新增二进制遥测链路与上位机桥接，用于串级 PID 调参
    原有的 ValuePack 遥测发 15 个 float，其中 13 个是静态 PID 增益，动态量
    只有 imu.rol 和 set_speed1 —— 三个环里两个是瞎的，没法定位问题。
    固件侧新增 USER/telemetry/{telemetry.c,telemetry.h}：
    - 帧格式 0xAA55 + LEN + 73B payload + CRC16-CCITT(0x1021, init 0xFFFF)，
    小端逐字节打包（不依赖结构体布局，无 padding 风险），走 USART6 @460800。
    - TELEM_DECIM=2（400Hz 控制环 → 200Hz 发帧），TELEM_ENABLE 可整体关断，
    关断时所有钩子退化为空宏，不占一个字节。
    - 关键字段：set_speed0_raw（限幅前）与 set_speed0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
    [A_Remote.c, A_blue.c, A_include.h, Balane.c, CH100.c, Init.c, PID.c, beep.c]
2026-09-04 添加仓库 README
2026-09-04 更新 CLAUDE.md 的 git 卫生一节，反映仓库已清理
    原文描述的问题（ignore 文件失效、约 210 个文件因 CRLF 长期显示已修改、
    需要 --ignore-cr-at-eol 才能看清 diff）已经全部修掉，那一节留着会误导。
2026-09-04 更新 CLAUDE.md：顶层 README 已存在
2026-09-07 OLED 阶段2：脏页跟踪、SPI 流水化、10Hz + 事件驱动刷新
    实测全屏刷新在 2.81MHz 下是 3.1ms，其中 2.92ms 是 1024 字节的纯比特
    时间，软件无法突破。唯一能省的是少发页、少画帧。
    - oled.c 新增影子缓冲 OLED_SENT[8][128]，每页 memcmp 后跳过未变化的页，
    连 set_pos 的 3 个命令字节都不发；oled_refresh_gram() 返回实际推送页数。
    新增 oled_invalidate() 供面板复位后重同步。
    - 把 BSY 同步点从"每字节之后"移到"DC 变化之前"（oled_set_dc）。DC 必须在
    整个字节期间稳定，所以同步不能删，只能移；同 DC 的连续字节现在完全背靠背。
    DC 只能经 ol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
2026-09-07 ODrive: 每轴独立发送缓冲，不再丢弃 DMA 返回值
    odrive_speed_ctl() 用一块 static uint8_t[12] 服务两个轴，并且丢弃
    HAL_UART_Transmit_DMA() 的返回值。两个后果：
    - 12 字节 @460800 需要 260us 才能发完，balance() 里轴 0 发完仅几微秒后
    就调用轴 1，此时 gState 仍是 BUSY_TX，HAL 返回 HAL_BUSY 且一个字节都
    不发 —— 静默失败，无从察觉。
    - 即便不忙，共用缓冲也会让后一次调用改写前一帧仍在 DMA 传输中的内存。
    改为每轴一块缓冲；检查返回值，失败时累加新增的 odrive_tx_drops。
    balance() 里加一行 if(M1_cnt1 < 40)，让要发轴 1 的那一拍跳过轴 0。飞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
2026-09-07 阶段3：遥控命令协议、驾驶/菜单模式机、行级脏跟踪、开机同步刷屏
    协议与模式
    - 新增 ui_command()，vofa_apply() 的 default 分支把所有非数字 id 转过来；
    VOFA+ 的数字键 '0'-'7' 原封不动继续可用。
    - 遥控端只发物理按键(M/U/D/L/R/K + H 心跳)，语义由车端按当前模式解释，
    遥控端无状态、不可能失步。id 表写在 ui.h 头部，是两端契约。
    - 驾驶：M1_Ctl ±0.1 钳位 [-3,3]；Servo_Ctl ±5 钳位 ±80；OK 停车并回中。
    菜单：13 项参数，逐项 min/max/step；第 3-7 项 max 定为 0，那几个增益必须
    为负，越过零点会把对应环变成正反馈。
    - 心跳 500ms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
2026-09-07 新增 REMOTE_PROTOCOL.md：遥控端固件的自包含实现契约
    给另一位开发者写蓝牙手持遥控端固件用。脱离本仓库也能照着实现：物理层
    (UART7 115200 8N1，PE7/PE8，经蓝牙串口；与 USART6 460800 的遥测流无关)、
    帧格式与 vofa_get() 状态机逐条说明、id 命令表、时序契约(心跳 100-200ms、
    按住时 ~10Hz 重发、500ms 失联切驱动不切平衡)、value 字段格式、实现清单
    与字节级示例。
    权威代码用脚本从源文件直接抽取后逐字校验，不是凭记忆转述。文中三处与
    口头描述不符的地方以代码为准并单独标注：'V' 当前未编译进固件；缺逗号的
    "(id)" 会被静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
2026-09-08 遥测 v2：日志自带 PID 参数，payload 73 -> 113 字节
    自主调参的前提是日志能脱离固件被解读。v1 的 CSV 只有配上产生它的那次构建
    才有意义,也无法区分两次运行用的是哪组增益。
    - payload 末尾追加 10 个 float(小端): av_kp/ki/kd(角速度内环)、an_kp/ki/kd
    (角度环)、fw_kp/ki/kd(飞轮速度环)、angular_zero。名字与 OLED 菜单一致,
    日志字段和菜单行是同一个东西。PROTO_VERSION 1 -> 2。
    - flags 新增 bit6 TEST_ACTIVE(本提交只定义,接线在测试脉冲那一提交)。
    - pid_tuning_bridge.py 的 SCHEMA 同步,PAYLOAD_LEN 两侧均为 113。
    - 字节对齐用桩编译(cc -Dstatic= 把固件 tele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
2026-09-08 测试脉冲：可复现的固定角度阶跃 + OLED 菜单触发
    调参需要每次完全一致的激励, 否则两组参数没法比。给角度环设定值临时叠加
    TEST_STEP_DEG 持续 TEST_STEP_MS, 然后撤掉。
    - Balane.h/.c: test_pulse_start/update/offset/active。常量放头文件:
    TEST_STEP_DEG 0.3f, TEST_STEP_MS 400, TEST_ABORT_DEG 4.0f, TEST_ARM_MAX_DEG 1.0f。
    空闲时偏置返回精确 0.0f, 算术与不带该功能的构建逐位一致; 控制逻辑其余未动。
    - 幅值定为 0.3: 2.0 会把 error_zero 推到 7.84 并触发 5deg 断电保护;
    0.5 不摔, 但仍把飞轮充到 |now_speed0| 119..153(静态只有 ±30), 阶跃响应被
    之后的动量卸载主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
    [Balane.c, Balane.h, telemetry.c, ui.c]
2026-09-08 bridge：阶跃响应分析 + summary 的 params 块
    - 以 flags 的 TEST_ACTIVE 上升沿为 t0, 在其后 STEP_WINDOW_MS 内算: 峰值角偏离、
    恢复时间、峰值飞轮转速、恢复期饱和占比、残余稳态偏差, 写进 step_response。
    - summary 新增 params 块(9 增益 + angular_zero, 取最后一帧); 窗内若改过参数,
    warnings 会点名哪个改了并提示该窗不是干净基线。现有指标全部保留。
    - 恢复时间用严格定义: 最早的 t 使得从 t 到窗尾 |角误差| 始终在带内。单调、
    无歧义, 且天然落在脉冲撤销之后 —— 撤销那一下会打破更早的"保持"。
    除原 ±0.3deg 外追加 ±0.1deg 紧带(实测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
2026-09-08 调参文档：手册、迭代日志与各窗 summary
    - TUNING_PLAYBOOK.md: 方法与目标(用户所写), 纳入版本管理。
    - TUNING_JOURNAL.md: iter 0..6 的 append-only 记录, 含每轮的改动、前后指标、
    keep/rollback 判定与理由。其中 iter3 标记作废(激励未按预期烧录生效)、
    iter5 是一次回滚(速度环输出限幅, 见下)。
    - logs/summary_*.json: 各窗结论(按 .gitignore, summary 跟踪、telem_*.csv 不跟踪)。
    iter5 值得单独一提: 我给 Velocity_Control() 加了 ±0.5deg 输出限幅, 结果车
    完全站不住 —— pwm_accel = -0.016*now_speed0, ±0.5 等价于 |now_speed0|>31 就削,
    实测 12-21% 的帧被削, 飞轮卸不掉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
2026-09-08 锁定实测工作点：angular_zero -1.40、无风 fw_ki -0.081，脉冲防重复触发
    烧录会把菜单调出来的值冲回代码默认值。上一轮就因此吃过两次亏: TEST_STEP_DEG
    改了没烧录, 拿旧的 2.0deg 又把车掀翻一次; fw_ki 也出现过 -0.079/-0.081 的混淆。
    把已验证的工作点写进代码。
    - angular_zero -1.27 -> -1.40。-1.27 是上一套机械配置上整定的, 已失效。
    用 d(now_speed0)/dt 对 imu_rol 回归求过零点(飞轮不再被迫加速的那个 roll):
    稳定窗 telem_20260908_210718 给出 -1.4007, 相关性为当轮最高, 且该窗 idle
    +0.37、rol std 0.028、稳态角误差 -0.003, 是至今最干净的一窗。
    该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
2026-09-28 显示层：加 1.8 寸 ILI9163 TFT，用一个宏在它和 SH1106 之间切
    两块屏挂在同一条 SPI1 和同一组 DC/RST 上, 只能二选一。切屏改
    USER/disp/display.h 的 DISPLAY_DRIVER 一行, 重编重烧即可。
    - USER/disp/disp_port.c/h: 共用的寄存器级 SPI1 传输层, 由 oled_port.* 改名而
    来(两块屏共用同一条总线, 名字不该只提其中一块)。新增 CS(PA6, 仅 TFT 配置,
    OLED 那块模块这根脚是五向键的 ADC 抽头, 必须留作输入)、按屏分频(TFT /8 =
    11.25MHz, OLED /32 = 2.81MHz)、以及 RGB565 用的 disp_fill16()。
    DC 缓存从 oled.c 移到这里独占一份, 避免两处状态失步。
    - USER/tft/: ILI9163 驱动,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
2026-09-28 串口：接收出错后自动恢复，不必再关机重连
    症状是"蓝牙断一次就得关机重连"。根因不在无线那头, 在 MCU 这边:
    HAL_UART_IRQHandler() 把 ORE(以及 DMA 模式下的任何错误)当作 blocking error,
    调 UART_EndRxTransfer() 清掉 RXNEIE、把 RxState 置回 READY —— 接收被中止。
    而本工程重挂接收只写在 HAL_UART_RxCpltCallback() 里, 那个回调此后永远不会再
    被触发, 于是这条链路就死到复位为止。工程里原本没有任何 HAL_UART_ErrorCallback,
    只有 HAL 的空弱符号。
    ORE 在这块板上很容易发生: UART7 的 NVIC 抢占优先级是 2, 而 UART8(IMU, 整个
    2.5ms 控制环在它中断里跑)是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
    [uart.c, uart.h, ui.c]
2026-09-28 纳入 TFT 移植的参考源
    USER/tft/ 的来源, 留档以便日后核对移植是否忠实:
    - lq_tft/: 龙丘 LQ_SGP18T 原厂驱动(GBK), 初始化序列与 162x132 的 RAM 尺寸以它为准。
    - tft.cpp/.hpp, tft_font.h: 一份 C++/FreeRTOS 工程里的中间版本, USER/tft/ 直接
    由它移植。注意 tft.hpp 开头那段"这块屏点不亮、已停用"的注释是过时的 —— 同一
    套代码在本板上已点亮, 移植版的注释已按实际情况重写。
    - spi_bus.cpp/.hpp: 那份工程的 SPI 传输层。USER/disp/disp_port.c 没有照抄它的
    DMA + 信号量(那是为 FreeRTOS 让出任务用的, 裸机主循环里轮询更简单且同样快),
    但照搬了它两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
2026-09-28 Init.c 重排版（纯格式）
    while(KEY_0==0) 加大括号, if/else 拆行。语义未变 —— 去掉注释与空白后做过
    token 级比对, 差异只有括号和换行。单独提交, 好让后面那个 LED 提交的 diff
    只剩它自己的两行。
    Claude-Session: https://claude.ai/code/session_017iH4oaHB5ea4tgdW28yWY6
2026-09-28 加板载 8 路 LED，做成开机即跑的往返流水灯
    从同一份 C++ 工程的 led.cpp/hpp 移植成 C。两个自己猜不出来的事实照搬:
    - **物理顺序是反的**。CubeMX 的 LED_1..LED_8 对应 PG1..PG8, 但物理排列上
    PG8 才是第一颗。所以驱动里按字母 A..H 重新编号, A = PG8, H = PG1,
    引脚表是倒着写的。用字母就是为了不再问"1 号到底是哪颗"。
    - **低电平点亮**(共阳)。
    一处必须与原版不同: led.cpp 的注释说"方向由 MX_GPIO_Init 配好", 那是它那个
    工程。本工程的 .ioc 在 G 口只分配了 PG9/PG14(USART6), gpio.c 从未碰过
    PG1..PG8, 它们一直停在复位态(浮空输入) —— 这时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
2026-09-28 移除 TFT 移植的参考源
    USER/tft/ 已经移植完并在硬件上验证通过, 这些原始文件不再需要留在仓库根目录。
    需要回溯的话它们在 86f1a8f 里。
    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
2026-09-28 遥控器按键可跳过 31 秒直立校准
    按下板载 KEY_0 后要空等 31 秒才进主循环, 这期间遥控器完全没反应 —— 想用遥控
    调个参数都得先干等。现在按遥控器上任意一个按键即可结束校准、直接进正常模式。
    判据是"收到一个被识别的按键", 不是"收到帧"。这是本次唯一容易做错的地方:
    遥控器只要开着就在以 10Hz 发 (H,) 心跳(见 REMOTE_PROTOCOL.md), 拿收到帧当
    判据的话, 只要手柄是开的, 31 秒校准每次都会被瞬间跳过, 校准就形同虚设。
    rc_btn_seen 置位的那一行放在 ui_command() 的 switch 之后, 而 'H' 在 switch
    开头就 return、未知 id 走 default re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
2026-10-04 UART7 发送改中断模式，把 DMA1 Stream1 让给 USART3 接收
    后轮反馈需要 USART3 的接收走 DMA，而 STM32F4 上 USART3_RX 只有
    DMA1 Stream1 Channel 4 这一个请求映射，该流原本挂的是 UART7 的
    发送。
    让出它是安全的：uart_printf() 的全部调用点都是注释掉的，
    send_ValuePack() 在整个工程里没有任何调用者，所以这条 DMA 通道
    实际上是死的。两处发送改成 HAL_UART_Transmit_IT()——UART7 的
    NVIC 本来就为接收开着，而 send_ValuePack() 自己还带一个
    HAL_Delay(1)，可见这条路径对吞吐没有要求。
    注意 Core/Src/usart.c 是 CubeMX 生成的，这次改动不在 Fly_Dreams.ioc
    里，和 Mak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
2026-10-04 后轮位置/速度反馈：循环 DMA 接收，按 ODrive 实际回复格式解析
    ODrive 的 axis 1 反馈一直读不出来，查下来是两层原因，都不在最初
    怀疑的地方。
    接收侧改成循环 DMA。原先是 HAL_UART_Receive_IT(..., 1) 一次收一个
    字节，而 USART3 的 NVIC 抢占优先级(0,2)和 UART8(0,0)相同——UART8
    的中断里跑的是 CH100_Rec() 加整个 balance() 级联 PID，远超 460800
    下 21.7us 的单字节时间，所以回复落在 balance() 执行期间就接不住。
    现在 256 字节环形缓冲由 DMA 填、主循环排空，首次排空丢弃开机倒计时
    期间堆积的陈旧字节。（事后证明这不是回复被截断的原因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
2026-10-04 odrive_speed_ctl 跳过未变化的命令，带 100ms 心跳补发
    balance() 在 40 个 IMU 帧里有 39 帧调用 odrive_speed_ctl(0, ...)，
    约每秒 360 条命令、每条 12 字节，而 set_speed0 只由角速度环每 6 帧
    重算一次——其中五分之四是在重复发同一个值。ODrive 要逐条解析，而它
    的 BufferedStreamSink::write() 返回 void，装不下就静默丢弃，
    AsciiProtocol::respond() 也没检查返回值。
    现在只在格式化后的 6 个字符真正变化时才发。控制行为不变：ODrive 会
    保持上一次给定的速度。未变化的命令每 100ms 仍补发一次，这样单帧丢失
    不会把 ODrive 永久卡在旧设定点上；发送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
2026-10-10 修正舵机协议：实际角度±90度，命令与回显统一0.1度单位
2026-10-10 舵机通信改用整数度，命令与回显范围统一为±90
2026-10-10 同步上位机整数度协议说明、源码注释与CRC示例
2026-10-10 明确协议角度直接控制转向舵机轴而非车龙头转角
2026-10-11 扩展舵机转向范围至±120度并同步上位机通信契约
2026-10-11 回传ODrive实测转速，区分测量状态并增加过期回退
2026-10-11 提高后轮目标上限至240rpm并同步遥控驾驶限幅
2026-10-11 彩屏分色显示IMU三轴并隐藏临时调试信息
2026-10-11 新增CH100姿态查询回复及有效性检查并同步通信契约
2026-10-14 遥控舵机按实际约15度限幅并更新彩色显示和协议注释
2026-10-14 舵机实际角度修改为20度
2026-10-27 记录ODrive更换校准与舵机调参结果并同步协议说明
